1649472332-arch/Kolbe_Codex_handoff/README.md

# 当前使用入口

当前有效交付是 `CAD_v2/` 的 FreeCAD B1。先阅读 `README_START_HERE.md`，双击 `打开模块检查.cmd` 进入三维模块检查。下方为历史 OpenSCAD 原型，其尺寸与生成流程不适用于当前 FreeCAD 版本。

# 可堆叠无隔膜 Kolbe 电解槽：工程原型说明（历史资料）

本仓库描述一套可拆卸、可重复堆叠的板框式单极电解槽概念，供 OpenSCAD 几何检查和工程评审使用。它不是制造放行文件，也没有经过承压、密封、电气或化学验证。渲染成功不代表可安全运行。

## 设计摘要

- XY 为板面，Z 为堆叠方向。相邻电极形成独立开放流道；不设膜或隔膜。
- 电极按 `C-A-C`、`C-A-C-A-C`、`C-A-C-A-C-A-C` 排列。所有 A 并接、所有 C 并接，属于单极并联，不是双极串联。内部电极两面面向流道；两侧外阴极只有朝内的主要工作面。
- 基准几何：120 mm 方形框、R4 外角；50 mm 方形工作窗、R3 圆角；80 mm 方形电极、0.35 mm 厚。电极耳延至 x=±80 mm、宽 10 mm、位于 y=0：A 向 +x，C 向 −x。
- 每个流道框厚度与名义流道间隙相等，默认 4 mm；范围示例 2/4/6 mm。硬止挡由框体平整端面提供。
- 框两侧各有闭合圆角方形密封槽，中心线边长 60 mm、圆角 R6；密封圈线径 `cs=gap/4`，槽宽 `1.4cs`、深 `0.75cs`。自由密封圈截面为圆形；模型中的压扁/椭圆形只为表现压缩后的变形，不是可直接制造的自由态截面。
- 八个 M6 拉杆孔位于 x=±50 mm、y=±45/±15 mm；框、绝缘板和端板孔径均为 7 mm，配 12 mm 垫圈。端部各有 4 mm 绝缘支撑板和 10 mm 刚性端板。
- 接液框暂以 PEEK 为材料占位；阳极暂以铂或双面镀铂钛建模，阴极材料待定。材料牌号、表面处理和所有接液件仍需依据真实电解液与温度选定。

## 堆叠尺寸与物料数量

| 电极数 n | 流道数 n−1 | 名义总高 |
| ---: | ---: | ---: |
| 3 | 2 | 37.05 mm |
| 5 | 4 | 45.75 mm |
| 7 | 6 | 54.45 mm |

总高公式：`H = n·0.35 + (n−1)·gap + 2·(10+4) mm`。以上取默认 `gap=4 mm`，未含接头、外部母线、垫圈突起或压紧变形。

初版 BOM 计数：`n` 片电极；`n−1` 个流道框；`2(n−1)` 个密封圈；2 个绝缘支撑板、2 个端板；8 根 M6 拉杆、16 个垫圈和 16 个螺母；每框 2 个微管/连接短管，共 `2(n−1)` 个。外部歧管、远端接头、堵头、仪表、线缆及安装件需另行设计选型。

## 装配顺序（概念）

1. 检查框槽、端面、工作窗和孔道无毛刺、污物或可见损伤；确认每个框两条密封闭环连续。
2. 将合适的自由态密封圈分别放入每框两面的槽内。不可拉伸过度或扭曲；确认接液材料已通过相容性确认。
3. 从一端端板和绝缘板开始，按 `C-A-C...` 顺序交替堆叠电极与流道框，确保每个流道两侧电极表面平整贴合框体止挡，电极耳朝向和绝缘间隙符合装配图。
4. 加另一端绝缘板和端板，装入对称拉杆、垫圈和螺母。按经计算确定的顺序与预紧方案均匀加载；本说明不提供扭矩值或压紧力。
5. 逐个通道连接外部分配/回流管路，低风险介质下先确认通断和排气路径；连接干侧母线时确认极性、绝缘与短路防护。电极没有已定型的横向定位特征，需另设计装配定位夹具/治具（TBD）。

模型给出的硬止挡目标是框体端面抵住电极平面，不应靠无限增加螺母扭矩挤压软密封。实际装配工艺、紧固件预紧和压紧均匀性必须单独制定。

## 历史参考的取舍

旧 v37 仅作尺寸、外壳、加工和历史问题参考：外形尺度、孔位和加工空间等经验可用于比较与复核；旧参数中的约 104.7 mm 外形、68/86 mm 腔体尺度和 8/9/10 孔版本不直接决定新模型尺寸。双半框、隔膜、M12 插电极孔、垂直交叉电极及旧的接液铜连接思路均不属于本方案，不能据此推断新结构已解决密封或电化学性能问题。

## 修改与生成视图

主模型和视图开关见 `kolbe_stack.scad`。按项目提供的渲染脚本批量生成 3/5/7 片、爆炸图和流道剖视：

```powershell
python scripts/render_variants.py
```

如脚本或 OpenSCAD CLI 尚未安装，需先在本机配置 OpenSCAD 并按脚本提示运行。模型支持输出几何视图、STL/DXF 等脚本明确列出的格式；不承诺提供原生 STEP，也不应把网格输出当作已完成的加工图纸。每个加工件的材料、尺寸、公差和表面要求仍需工程图定义。

修改电极数时只使用奇数 3、5、7；修改间隙时同步复核密封圈线径、双槽之间的框体剩余腹板、进出液孔壁厚、软管接口和堆叠高度。不要只改单个参数就假定其余结构仍有足够壁厚或可装配。

## 必须确认的工程输入与限制

- 设计压力、正常工作压差、堵塞/泵故障压力、泄压设定、压力循环范围均为 **TBD**。当前没有压力额定值，也没有任何压力试验结果。
- 电解液组成、浓度、羧酸盐/产物、溶剂、清洗液、实际温度、流量、产气量与泵曲线尚未提供。60–85 °C 是待兼容性评估的温度范围，不是已验证工况。
- 需确认密封圈截面与材料、槽公差、压缩率、热膨胀、溶胀及压缩永久变形。默认 `cs=1 mm`（4 mm 间隙）；2 mm 间隙时 `cs=0.5 mm`，需供应商确认可采购性和装配能力。
- 需确认流体接头、微管、软管与外部并联歧管。当前框内埋入式横向孔直径为 `gap/4`，短管外径为 `port_d+0.4 mm`；相邻流道框同侧管口的 Z 中心距为 `gap+0.35 mm`，同一框相对两侧管口的 Y 向距离为 120 mm。每个框面无法假定可直接安装常规接头。微管与框体之间的密封和保持/防脱设计尚未完成，远端扇出连接、接头采购和压力验证仍是 TBD；未完成前不得按可用于实际带液服务的框体下单加工。
- 需确定阴极材质、阳极涂层与基材、引出耳连接方式、电流、电流密度、接触电阻、温升、母线截面和电气间隙。旧装置约 10.5 V 是槽电压记录，不是电极电位，也不能用来证明铜箔安全载流。
- 需做端板弯曲、拉杆/螺母/垫圈强度、压紧载荷分布、框体局部应力、绝缘和浮动公差计算；检查薄板在压差下的挠曲、屈曲/鼓胀及外侧阴极的背衬条件。
- 需要考虑 60–85 °C 下 PEEK 等材料的热膨胀、密封与框体蠕变、PTFE 冷流（若选用）和重复拆装后的损伤。
- 无隔膜单腔体系可能发生产物交叉、混合气体与可燃气体风险。系统必须另行设计气液分离、持续排气/安全排放、压力监测和适当防护；本模型不能解决这些系统安全问题。

OpenSCAD 几何只能帮助检查构型与尺寸关系，不能证明承压、均匀预紧、长期耐腐蚀、电气安全或“保证不漏液”。在材料测试、结构计算和经批准的压力/循环试验完成前，不可把本原型作为额定设备投入运行。
