1649472332-arch/Kolbe_Codex_handoff/CAD_v2/docs/design_review.md

# Kolbe 紧凑电堆设计审查

## 设计状态

当前冻结候选为 56 mm × 56 mm 双面电极片、0.35 mm PEEK 绝缘载片和 KF-101 内部分流框。框体在 CAD 中标注为 **PVDF provisional**；PEEK 仅用于载片/绝缘件，框体的最终材料尚未选定。6 mm 是机械审查用的暂定框厚，实际电极间隙仍待实测电极与流量需求确定。

这份审查覆盖 FreeCAD BRep 几何和尺寸关系。几何有效不代表耐压、流动、化学兼容或量产工艺已验证。

## 有效面积与密封边界

- 湿腔为 50 mm × 50 mm、R3 圆角，无加宽分配槽；流体由 ±Y 内部歧管经埋入式支路直接进入湿腔。
- 湿腔面积为 2,492.27 mm²。电极片为 56 mm × 56 mm、R2 圆角，去掉引出片后的面积为 3,132.57 mm²；湿腔/电极面积比为 79.56%。
- 主密封槽中心线尺寸 53.6 mm、R4.8，宽 1.4 mm、深 0.75 mm；密封槽外包络尺寸 55.0 mm。相对 56 mm 金属片，每边仅有 0.50 mm 外侧余量；密封槽内缘到 50 mm 湿腔边缘的平面余量为 1.10 mm。供应商公差及装配偏差可能显著影响这两个窄边界。
- 主 O 形圈暂按 1.0 mm 截面估算：名义压缩率 25.0%，矩形槽截面填充率约 74.8%。歧管槽使用独立参数：均径 14 mm、宽 2.2 mm、深 1.1 mm，暂按 1.5 mm 截面估算，压缩率 26.7%，填充率约 73.0%。密封材料、硬度、温度和介质适配尚未指定。

## 歧管、支路与装配

两个 Ø8 轴向歧管位于 (0, ±62)，金属电极片没有歧管孔。歧管密封落在载片/支撑件的绝缘平面上；主密封圈则压在金属电极片上。KF-101 的 Ø2.2 横向埋入支路在 z=3 mm 处从歧管通到湿腔。BRep 探针检查确认支路、湿腔和歧管交汇处无实体阻挡，主密封环和四个歧管密封环的抽样点均处于槽内。

重复 n 片电极的名义层叠关系为：n 个 PEEK 载片、n 个电极片、n−1 个 KF-101 框、2(n−1) 个主密封、4n 个歧管密封；端部为前端板 KP-201、前适配件 KP-202、后闭合件 KP-203、后端板 KP-204 各 1 件。每个框另有 2 个 M4 交叉钻孔堵头和配套垫片。KF-101 的外侧交叉钻孔是制造通道，堵头不是外部流体接口。

| 电极片数 n | 载片 | 电极片 | KF-101 框 | 主密封 | 歧管密封 | M4 堵头/垫片 |
| ---: | ---: | ---: | ---: | ---: | ---: | ---: |
| 3 | 3 | 3 | 2 | 4 | 12 | 4 组 |
| 5 | 5 | 5 | 4 | 8 | 20 | 8 组 |
| 7 | 7 | 7 | 6 | 12 | 28 | 12 组 |

堵头 KH-901 在 CAD 中为 M4×0.7、Ø3.3 光滑螺纹包络、6 mm 长，带 Ø5.5 × 2 mm 一字槽头；KH-902 垫片建模为 Ø5.5/Ø4.2、厚 0.5 mm。螺纹不是螺旋实体，堵头/垫片接触、公差、紧固扭矩和密封方式都需工程确认。

## 尚待验证

1. 实测电极、载片、框体厚度及平面度公差，并复核 0.50 mm 外侧密封余量和 1.10 mm 内侧余量。
2. 确定 KF-101 最终材料、密封材料、实际电解液和温度范围；完成相容性试验。
3. 对共用液体歧管评估离子旁路/分流电流。PEEK 载片隔离了金属歧管孔，但不能据此认定已消除所有液相分流。
4. 通过流量测量或 CFD 评估支路压降、分配均匀性、滞流区和排气/排液；目前没有 CFD 结论。
5. 完成交叉孔加工可达性、堵头装配与密封试验，以及工作压力、泄漏和耐久验证。

现有 FreeCAD 几何审计通过，只说明当前 BRep 有效、连通孔道没有被实体堵住；**尚未达到制造放行或压力等级认证状态**。
