1649472332-arch/Kolbe_Codex_handoff/CODEX_TASK.md

# Codex 开发任务：可堆叠、无隔膜、双面反应 Kolbe 电解槽（OpenSCAD）

## 任务目标

基于 reference/ 下的旧 v37 OpenSCAD 作为**尺寸、外壳、加工和历史问题参考**，重新设计一个类似碱性电解水电堆的**模块化板框压滤式（filter-press）Kolbe 电解槽**。不要直接在旧双半框、隔膜和垂直交叉电极结构上简单增加孔。提交可运行的参数化 SCAD 机械结构、分件视图、装配视图、爆炸图、装配说明、密封/供液/导电说明及可执行检查。

老师的硬性要求：**不是一体式池体，必须能拆卸、堆叠、扩容，并使内部电极的两个表面都能够参与反应。** 用户当前体系：**无隔膜**、单腔思路、外部储液瓶、循环泵。约 10.5 V 为旧装置部分实验槽电压，不等于电极电位，也不能据此确定铜箔安全载流能力。曾出现泵开启、压差增加后渗漏；设计优先级为密封可靠性和可维护性，不是单纯外观。

## 必须实现的电极结构与电连接

- 采用平行平板**单极式（monopolar）、同极并联**阵列，不做双极板串联。优先支持 `C-A-C`（3片）、`C-A-C-A-C`（5片）、`C-A-C-A-C-A-C`（7片），参数切换且自动重复相同类型零件。
- C=阴极、A=阳极；每两片相邻电极之间设置一个独立的开放流道，**无膜、无隔膜**。两侧外阴极只有朝向流道的主要工作面，内部电极两面参与反应；不能夸大成“所有电极两面都充分利用”。
- 双面阳极反应表面设为连续、平整的铂或双面镀铂钛模型（实际电极材料由实验确定），不允许背后用实体集流板挡住反应面。
- 每块电极的**平面引出耳/导电耳**在周向密封区外伸出；电极平板本体被两侧密封圈压住。设计时确保引出耳的几何特征**不破坏密封压合面**。电极引出耳、外部铜线/铜排、拉杆、端板彼此要有电气绝缘与机械避让。
- **铜箔/铜排只位于干燥的外部区域**，不能接触阳极电解液。导电接头强度、接触电阻、电流和温升需要单独校核，不把 10.5 V 直接当成铜箔耐压阈值。

## 必须实现的机械与密封结构

1. 重复单元：`流道框 + 两侧密封件 + 电极板`；两端安装绝缘支撑板与刚性压板，外围用对称拉杆/螺栓压紧。各件需便于单独拆出、更换、扩展。
2. 每个流道框内有贯通工作窗口；其**左右两张端面**均设置闭合、连续的密封圈槽/垫片座，密封圈压在邻接电极的**平整面**上。不能出现“密封圈被入口沟槽切断”“螺栓孔位于湿侧密封区”等问题。
3. 配置明确的压缩限位面/硬止挡，避免过度挤压密封圈；密封槽几何必须全部参数化，同时文档标明设计压缩率、槽宽/深、压缩后高度、堆叠尺寸链和公差分析。默认值仅作方案占位，需供应商标准进一步核查，不得称为已认证/保证不漏液。
4. 端板、外框、拉杆需有可供工程人员进行抗弯/预紧计算的尺寸和建议校核路径；OpenSCAD 不能直接证明压紧均匀。螺杆分布按湿区外周均匀对称布置，满足几何壁厚和绝缘避让。不要假设增加螺栓数量就一定密封更好。
5. 流道框材料先建模为 PEEK 等高刚性耐化学材质的占位；密封材料 EPDM/FKM/FFKM 等必须注明需按实际碱度、羧酸盐、产物和 60-85°C 条件做相容性验证。PTFE 的热蠕变/冷流应作为风险而非忽略。所有接液材料需留 BOM 备注，不能直接把旧原型的 3D 打印密封能力当作可靠承压能力。

## 供液与排气（第一版先用外部分配）

- 每个流道框独立入口/出口（优选底部进液、顶部出液/排气的流路），所有流道经**外部并联分配歧管**接循环泵与储液瓶。需要绘出每个流道的进出液通孔、接头安装空间及至内窗的实际贯通流路，而不是装饰性孔。
- 流道入口和出口若从侧边钻入框体，必须设计为框体**实体内部的穿孔**，不得在密封端面挖穿 O 形圈路径的明槽。端面 O 形圈需构成从湿窗向外无缺口的闭环。应显示局部剖视确认。
- 给各流道配置可拆卸堵头/转接接头概念、空间避让、排气说明；气液会有可燃混合气体风险，不得设计成无泄压出口的封闭压力腔。外部气液分离、安全排放、压力监测等需在 README 明确为系统级需求，不假装靠机械密封就解决产气危险。
- 可在后续提出“内部共用歧管”版本，但优先完成**可制造、可检查、可逐通道排障**的外部分配原型。

## 目标参数（初始方案占位，可为结构合理性调整）

| 参数 | 初始值 | 说明 |
| --- | --- | --- |
| `electrode_count` | 3 | 可取 3/5/7，奇数 |
| `active_window_mm` | 50 | 50×50 mm，暂定；不要强求沿用旧 68×68 腔体 |
| `gap_mm` | 4 | 2/4/6 mm 可选，最终由气泡/压降测试决定 |
| `electrode_thickness_mm` | 0.35 | 历史参考，不作为实际薄片强度认证 |
| `frame_material` | PEEK (概念) | 不是实际材料采购认证 |
| `gasket_cs_mm` | 可调 | O形圈线径，取供应商选型值后确定 |
| `bolt_count` | 6/8 或算法推导 | 受外形、密封环、端板刚度与应力约束，不是固定答案 |
| `operating_temperature_C` | 60-85 | 供兼容性与热膨胀校核 |
| `design_pressure_bar` | **TBD** | 用户尚未提供工作压差与极限压力；必须高亮待确认，**不要自定承压额定值** |

原版 V37 参数化参考里 `footprint_scale=2`、外形约 104.7×104.7 mm、活动腔参考尺寸可达 86×86 mm；另有 8/9/10 螺栓版本。旧工程含“双半框/膜/M12 插电极孔/交叉电极”遗留设定，**这些不是本方案的目标结构**。新板框尺寸由空间和受力需要决定，可以与旧 v37 不同。

## OpenSCAD 实施要求

- 建立统一坐标：建议 XY 为电极/流道板面，Z 为堆叠方向。每一层零件的 Z 位置由累计厚度确定，不用随意相对平移来掩盖干涉。
- 顶层提供 `part` 或 `view` 开关：`assembly`, `exploded`, `one_frame`, `gasket`, `anode`, `cathode`, `endplate`, `insulator`, `three_layer`, `five_layer`, `seven_layer`, `flow_section`, `terminal_detail` 等。
- 具有合理的颜色和透明度，能肉眼辨认阳极/阴极、流道、密封圈、端板、拉杆、外部接线耳；但输出 STL 时各零件必须是**单独可打印/可加工**的模型，颜色不作为制造特征。
- 加入 `assert()` 约束和错误提示：`electrode_count` 为奇数>=3；可用密封宽度>0；密封环不与螺杆孔/进出液孔相交；电极间净距>0；端板与接线耳有空间避让；侧向流道穿孔不得挖穿密封槽侧壁；避免开孔之间壁厚为负。
- 通过 OpenSCAD CLI 对 3/5/7 三种层数和流道间距配置执行至少预览/渲染检查。若机器没有 OpenSCAD，提供清晰的本地运行命令，不能谎称验证通过。
- 代码拆分合理，所有关键尺寸集中在参数区；维护可读注释，禁止过度 hardcode。

## 交付物

请在项目中创建以下文件，全部能在本地 OpenSCAD 中使用：

1. `kolbe_stack.scad`：参数化主模型和多种视图。
2. `README.md`：设计原则、装配顺序、参数表、修改方法、材料兼容性及仍需确认的工程参数。
3. `docs/seal_stackup.md`：密封接触路径、压缩尺寸链、公差、热膨胀与高温蠕变风险、失效模式。
4. `docs/electrical_fluid.md`：单极并联接线、电极双面利用、干侧铜连接、单独通道外部分流、产气及安全排气。
5. `docs/validation_plan.md`：逐层检查、几何干涉、密封压紧均匀性、冷态/热态水压和压差监测、循环工况、漏液判断等测试计划（压力阈值待确认）。
6. `scripts/render_variants.sh` 或跨平台 Python 脚本：OpenSCAD CLI 导出与批量渲染。
7. `renders/`：三、五、七电极装配图，至少一张爆炸图和一张流道密封剖视图（若能实际生成）。

## 验收标准

- `electrode_count=3,5,7` 可切换，几何阵列正确，每层间距与总堆叠厚度可计算。
- 中间每片电极两面面向相邻流道；没有膜；电连接为各 A 同极、各 C 同极，禁止短路。
- 每个湿区端面有完整密封闭环；出入口均连通工作窗口且未从端面截断密封圈；螺栓孔干区避让。
- 有真正的可拆分组件和清楚的 BOM，不只是一个看起来像电堆的单一实体。
- 电极引出耳全在干侧，外部铜件不直接接触液体；不存在明显电极/螺栓/压板干涉。
- 每个流道均可分配液体并排出气液，未出现死端封闭腔。
- 文档明确说明：OpenSCAD 模型无法证明承压、长期耐腐蚀或“保证不漏液”；需通过材料测试、端板受力和压力试验后再加工运行。

## 执行顺序

1. 阅读全部 reference/ SCAD，先简述旧设计真正可复用的几何、现存缺陷和需要推翻的部分。
2. 先构建密封流道框（含闭合周向密封槽、侧向实体内进出液孔）；出 `flow_section` 和 `one_frame`。
3. 再做双面电极薄板、引出耳与绝缘框架，接着完成 3/5/7 片装配。
4. 最后添加端板/拉杆/限位、导电母线示意、批量渲染、尺寸/安全/验证文档。
5. 完成后列出工程未定项，不许用模型可渲染代替密封性和耐压验证。
