1649472332-arch/Kolbe_Codex_handoff/docs/electrical_fluid.md

# 电连接、流道与排气

## 电极排列与电连接

阵列使用平行平板单极并联：3 片 `C-A-C`，5 片 `C-A-C-A-C`，7 片 `C-A-C-A-C-A-C`。每对相邻电极之间各有一个无膜、无隔膜的独立开放流道。所有 A 电极并到阳极母线，所有 C 电极并到阴极母线；不得把相邻板串成双极电池。每个通道的电压/电流分布仍需实测和设计校核。

内部 A 电极的两面分别朝向相邻流道，是双面阳极反应面；中间 C 电极的两面亦分别朝向流道。两侧最外层 C 电极只有朝内的主要工作面，不能表述为所有电极均双面充分利用。阳极建模为平整、连续的铂或双面镀铂钛概念件，背面不能加实体集流板遮挡其反应面。实际阳极基材/涂层、阴极材质、厚度、表面处理均待实验确定。

电极耳在周向密封区域外伸出：阳极耳向 x=+80 mm，阴极耳向 x=−80 mm，耳宽 10 mm、位于 y=0；外部干侧母线位置为 x=±82 mm。耳的根部及引出路径需保持框体密封压合面完整，并与端板、拉杆、垫圈和异极耳保持机械间隙与电气绝缘。每个重复层的极性耳可分别汇接同极母线；接头细节、紧固件和应力释放尚待设计。当前没有已定型的电极横向定位特征，堆叠装配需另设计定位夹具/治具（TBD）。

铜箔/铜排只用于外部干燥区域，不可浸入阳极电解液或接触湿润表面。引出耳—铜连接的接触电阻、载流能力、温升、机械强度、腐蚀隔离和绝缘距离需按电流及工况计算、测量。历史约 10.5 V 是旧装置槽电压数据，不是电极电位，也不构成铜箔载流能力的证明。

## 流体路径与接头边界

每个流道框有独立入口与出口，建议入口接框体下部、出口接上部，使流体冲洗工作窗并便于气体向上排出。所有通道由外部并联供液歧管接循环泵与储液瓶；每条支路应能单独隔离、取样、排气和排障，并评估并联支路的流量均匀性。端口必须经真实贯通孔道与活动窗相通，不得仅作外观孔。

本几何占位是横向埋入框体的孔，孔径 `port_d=gap/4`，Z 位于间隙中面。短管外径为 `port_d+0.4 mm`；相邻流道框同侧管口的 Z 中心距为 `gap+0.35 mm`。同一框的入口和出口位于相对两侧，Y 向相距 120 mm。默认 g=4 mm 时，孔径约 1 mm、短管外径约 1.4 mm、相邻框同侧管口 Z 中心距 4.35 mm；g=2 mm 时，孔径约 0.5 mm、短管外径约 0.9 mm、相邻框同侧管口 Z 中心距 2.35 mm。该几何不能假定可在每个框面直接安装常规接头。微管与框体之间的密封和保持/防脱设计尚未完成，远端扇出方案、固定方式和可采购性均为 **TBD**；完成设计并通过压力验证前，不应下单加工用于实际带液服务的流道框。

每个框的两面密封槽与工作窗之间保持闭合密封路径。横向钻孔必须位于框体实体内部，避免从端面开槽穿过 O 形圈路径。通孔、槽底和相邻面的薄隔壁需检查截面、加工偏差和强度；默认估算隔壁仅 `0.1875·gap`，g=4 mm 时 0.75 mm。除非已在模型剖视和实物验证，否则不能认为该薄壁可承压。

在接入循环泵前，外部分配管路应有明确的供液、回液、隔离、排气与泄压安排。每通道需能排尽气袋并确认回流；泵死端、堵塞、软管折弯和支路不平衡都可能提高压差。具体泵、流量、压差和接头额定值尚未确定。

## 产气与系统安全

无隔膜单腔运行时，反应产物与气体可能互相接触或混合，并可能形成可燃气体混合物。不得将有产气的流道设计或操作成没有安全排气/泄压路径的封闭压力腔。储液瓶、回液、气液分离器、连续排气、安全排放、压力监测/联锁和适当的通风/防护需要作为系统级设计；本模型和机械密封不能替代这些措施，也不能据此确认反应化学安全。

电解液种类、浓度、产物、溶剂、实际温度（目标范围 60–85 °C）、电流、气体生成速率和危险评估均待确认。所有接液材料、软管及密封件必须针对完整体系和清洗介质做相容性与寿命验证。
