1649472332-arch/Kolbe_Codex_handoff/docs/seal_stackup.md

# 密封路径与堆叠尺寸链

## 结构与接触路径

一个流道重复单元由流道框、框两侧各一只自由态圆截面密封圈，以及邻接的平整电极面组成。框体工作窗为 50×50 mm、R3；框外形为 120×120 mm、R4。密封圈中心线为边长 60 mm、R6 的闭合圆角方形。两个端面上的槽各自连续闭合，围住湿窗；流体口从框体内部横向钻入，不在密封端面开明槽。八个拉杆孔处于密封湿区之外。

接触路径是湿窗 → 密封圈内侧接液边 → 连续密封接触面 → 干侧框体/端面。检查每个面全周闭环、槽角、孔道与槽之间的实体隔壁，以及螺杆孔到槽的最小实体宽度。模型几何不能证明表面粗糙度、平面度、材料渗透率或实际接触压力。

## 名义压缩与止挡

符号：`g=gap_mm`，自由圈截面直径 `cs=g/4`；槽宽 `w=1.4cs`；单面槽深 `d=0.75cs`。框体厚度设为 `g`。框面硬止挡贴到电极平面时，压缩后的名义密封高度等于槽深 `d`，因此：

```text
压缩量 = cs − d = 0.25cs
名义压缩率 = (cs − d) / cs = 25%
```

此处是概念占位。自由圆截面密封圈的名义槽填充率为：

```text
fill = (π·cs²/4) / (1.4cs·0.75cs) = 74.8%
```

模型将压缩后的密封圈示意为宽约 `1.333cs`、高 `0.75cs` 的椭圆；这只是变形可视化，不代表可直接制造或采购的截面。未压缩的圈应按圆截面供应件处理。实际允许压缩率与槽填充率必须根据供应商对材料、截面、温度、介质、表面和静/动态密封工况的建议确认。

| 间隙 g | 自由截面 cs | 槽宽 w | 槽深 d | 双槽后残余腹板 `g−2d` | 名义框厚 |
| ---: | ---: | ---: | ---: | ---: | ---: |
| 2 mm | 0.5 mm | 0.7 mm | 0.375 mm | 1.25 mm | 2 mm |
| 4 mm | 1.0 mm | 1.4 mm | 0.75 mm | 2.50 mm | 4 mm |
| 6 mm | 1.5 mm | 2.1 mm | 1.125 mm | 3.75 mm | 6 mm |

### 端口壁厚的几何占位

横向埋入孔直径 `port_d=g/4`，位于框体 Z 中面。以孔道到任一密封槽底之间最短实体距离估算的名义隔壁：

```text
ligament = g/2 − 0.75cs − port_d/2
         = g/2 − 0.1875g − 0.125g
         = 0.1875g
```

即 g=4 mm 时仅 0.75 mm；g=2 mm 时为 0.375 mm。该薄隔壁是明显的强度、加工和泄漏敏感点，需检查真实孔道走向、槽宽、钻孔偏差、材料与工艺，并以截面/压力验证决定是否改版。代数结果不是最小制造壁厚的推荐值。

## 堆叠高度与公差

端板厚 10 mm、绝缘板厚 4 mm，各一对；每片电极厚 0.35 mm；每个流道框名义厚 `g`。总高度链为：

```text
H = 2·10 + 2·4 + n·0.35 + (n−1)·g
```

以 g=4 mm：n=3 时 37.05 mm，n=5 时 45.75 mm，n=7 时 54.45 mm。实际装配高度还受框厚公差、板厚、密封圈压缩、端板挠曲、垫圈/螺母和接头布置影响。压缩圈位于槽中，不可将自由圈高度额外累加到框厚链上。

公差链至少应纳入端板厚度与平面度、绝缘板厚度、电极厚度/翘曲、框体厚度/平行度、槽深、槽宽、圈截面公差及热态尺寸。螺杆有效长度和夹紧余量应由最终公差叠加与预紧设计确定。

**仅作算例的尺寸公差敏感性**：若自由截面与槽深分别为名义值 ±0.03 mm（不是已选工艺能力），g=4 mm 时，最小压缩率按 `cs=0.97,d=0.78` 算为 `(0.97−0.78)/0.97=19.6%`；最大按 `cs=1.03,d=0.72` 算为 `(1.03−0.72)/1.03=30.1%`。此算例未计温度、圈截面非圆、槽宽、材料回弹或压板变形，不能作为验收公差。

## 热、材料与装配风险

- 60–85 °C 下框、端板、杆件、电极与密封的热膨胀不同，可能改变间隙、预紧力和圈压缩量。应按具体牌号和实际尺寸建立冷热尺寸链。
- 密封材料对碱、羧酸盐/产物、溶剂及清洗液的兼容性未确定。EPDM、FKM、FFKM 等须按实际配方与温度筛选并浸泡/循环验证；不能仅凭通用材料名称判断兼容。
- PEEK 作为框材占位仍需采购牌号与化学兼容性确认。PTFE 若用于密封或绝缘部件，应把热蠕变和冷流纳入预紧保持评估。
- 反复拆装、偏心压紧、污染、刮伤、圈扭曲、槽毛刺、端面不平、孔道隔壁破损，均可能造成旁路或外漏。
- 只有框体硬止挡接触、槽底/槽宽和自由圈正确，才接近模型所示压缩。不得用提高拧紧扭矩弥补公差或泄漏。

## 载荷和失效评估路径

压力对一个窗口的分离力可先按 `F_p = Δp·A_wet` 估算，其中 `A_wet` 取真实受压投影面积；整个堆叠需考虑所有流道的压差、可能的压力不平衡和闭合力路径。密封压紧力需依据供应商数据或接触分析取得。由此校核拉杆、螺母、垫圈承压、端板弯曲/挠度、框体局部应力和压紧均匀性，并确认端板挠度不会明显改变流道间隙或局部圈压缩。针对电极薄板还需评估压差造成的挠曲/屈曲及外侧阴极是否需要背衬。

尚无确定压力、材料数据、预紧力、扭矩或端板校核结果；因此**无承压额定值、无建议扭矩、无“不漏”结论**。潜在失效包括外漏、通道间串漏、圈挤出/切伤、密封压缩不足或过大、端板翘曲、紧固件松弛、热态蠕变、孔道穿透槽壁和电极变形。压力阈值须由系统危险分析和结构设计确定后，再制定验证计划。
