1649472332-arch/Kolbe_Codex_handoff/CAD_v2/docs/seal_fluid_notes.md

# KF-101 密封与流路审查记录

本记录使用当前 KF-101 FreeCAD BRep 和设计基准进行几何核对。单位均为 mm；面积比仅针对圆角电极片主体，排除引出片。

## 密封槽尺寸核算

| 位置 | O 形圈截面 | 槽宽 × 深 | 名义压缩率 | 截面填充率 |
| --- | ---: | ---: | ---: | ---: |
| 主湿腔周边 | 1.0 | 1.4 × 0.75 | 25.0% | 74.8% |
| 每个歧管口 | 1.5 | 2.2 × 1.1 | 26.7% | 73.0% |

压缩率按 `1 − 槽深 / O形圈截面` 计算；填充率按 `π(CS/2)² / (槽宽 × 槽深)` 估算。结果是矩形截面的名义几何比例，不含圆角、弹性体体积公差、热膨胀、润滑剂或压缩后材料流动影响。

主槽为中心线 53.6、R4.8 的闭合圆角方环。槽外包络为 55.0；56 mm、R2 电极片外缘每边余量 0.50。槽内包络为 52.2；相对 50 mm 湿腔每边余量 1.10。歧管槽为均径 14、宽 2.2 的环槽，与主密封槽使用独立参数。

建议后续按目标介质、温度、压力、循环寿命和供应商 O 形圈规格复核压缩与填充，并将片材/加工/装配公差纳入最坏情况叠加。可参考 [Parker O-Ring Handbook](https://www.parker.com/content/dam/Parker-com/Literature/O-Ring-Division-Literature/ORD-5700.pdf) 的密封设计原则；本文尺寸仍是当前 CAD 假设，不代表该手册认可这些具体尺寸。

## 埋入支路与剩余壁厚

KF-101 每侧以 Ø2.2 横向钻孔连接轴向 Ø8 歧管与 50 mm 湿腔；外侧加工口为 Ø3.3 M4 螺纹底孔，深 6 mm，并用堵头和垫片封闭。BRep 空腔探针覆盖从湿腔、支路、歧管交点到外侧加工口的连续路径；探针与实体交叠体积低于审计阈值。此项只验证几何连通，不验证流量或密封能力。

在支路位于框厚中面、主槽从两侧各切深 0.75、歧管槽各切深 1.1 的名义几何下：

- 支路到主槽槽底的最小覆盖厚度约为 `3 − 0.75 − 1.1 = 1.15`。
- 支路到歧管槽槽底的最小覆盖厚度约为 `3 − 1.1 − 1.1 = 0.80`。

0.80 mm 是局部薄弱壁厚，应在最终材料、加工方式和压力边界确定后做强度/耐压复核。当前没有 FEA、压力试验或流量分配结果。

## 关键限制

- 框体 CAD 材料标签为 **PVDF provisional**，并非已批准材料；PEEK 是载片/绝缘件的暂定材料标注。
- 电极间隙、实际电极厚度和流量工况仍待用户实物/需求确认；6 mm 只作机械审查包络。
- M4 堵头为光滑名义螺纹包络，没有建模螺旋牙型；当前 KH-902 垫片是 Ø5.5/Ø4.2 × 0.5，不等同于已选定的密封件。
- 公共液体歧管可能形成离子旁路；需要按电解液、电阻率、层数和电气边界评估分流电流。
- O 形圈材质、硬度、公差、压缩量、表面粗糙度、堵头防松和泄漏标准均未冻结。
