1649472332-arch/Kolbe_Codex_handoff/CAD_v2/renders/inspection_free_angle.png

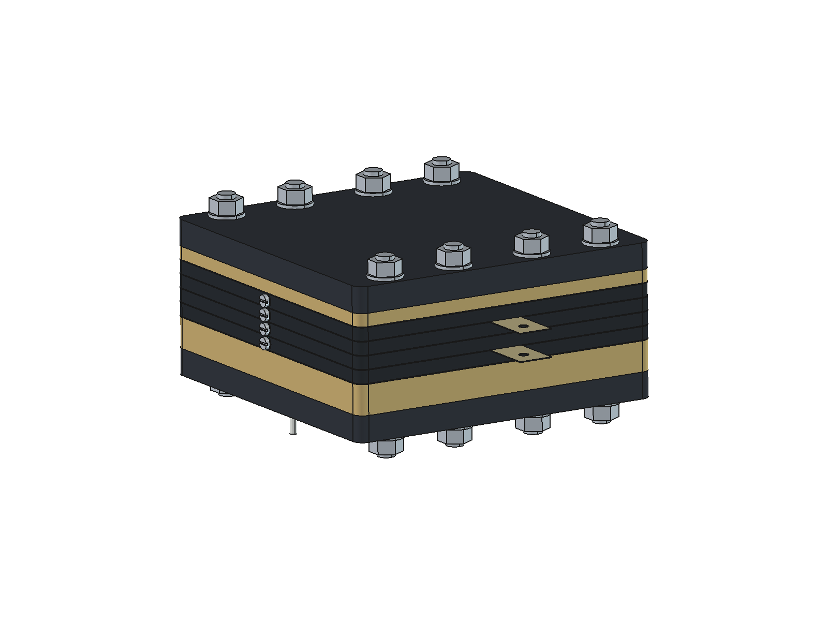
CAD_v2/renders/inspection_free_angle.png
