1649472332-arch/Kolbe_Codex_handoff/CAD_v2/renders/inspection_isolated.png

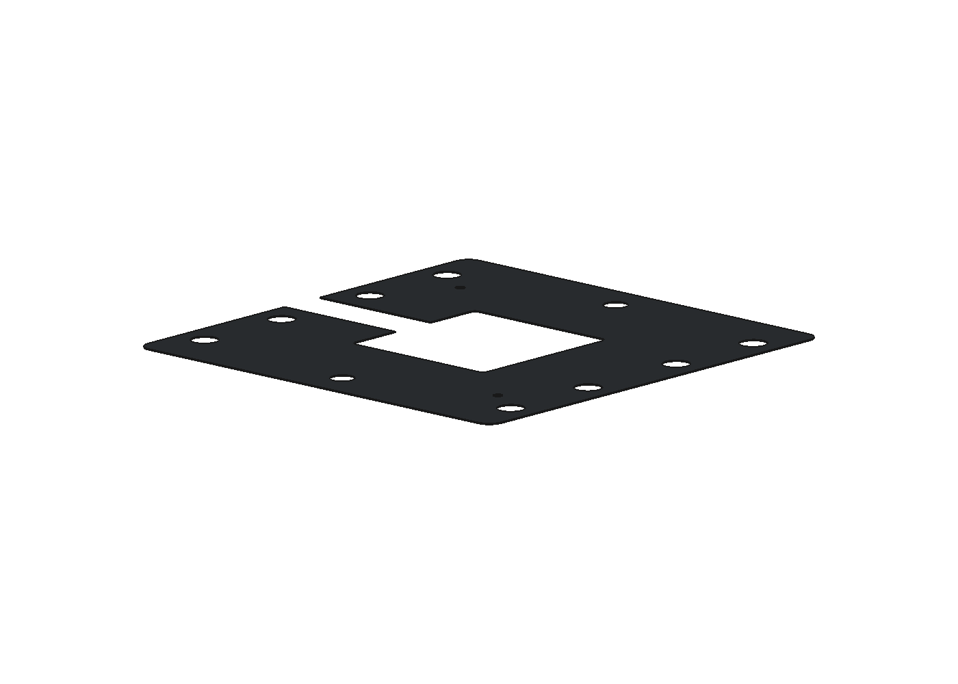
CAD_v2/renders/inspection_isolated.png
