1649472332-arch/Kolbe_Codex_handoff/CAD_v2/renders/Kolbe_3.png

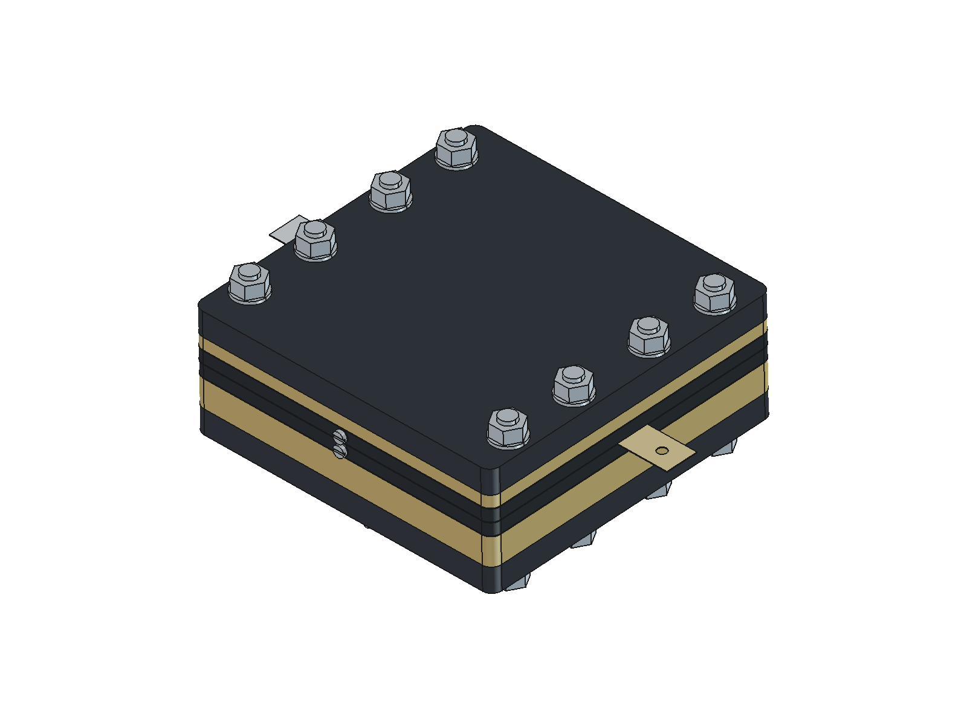
CAD_v2/renders/Kolbe_3.png
