1649472332-arch/Kolbe_Codex_handoff/CAD_v2/renders/Kolbe_5_exploded.png

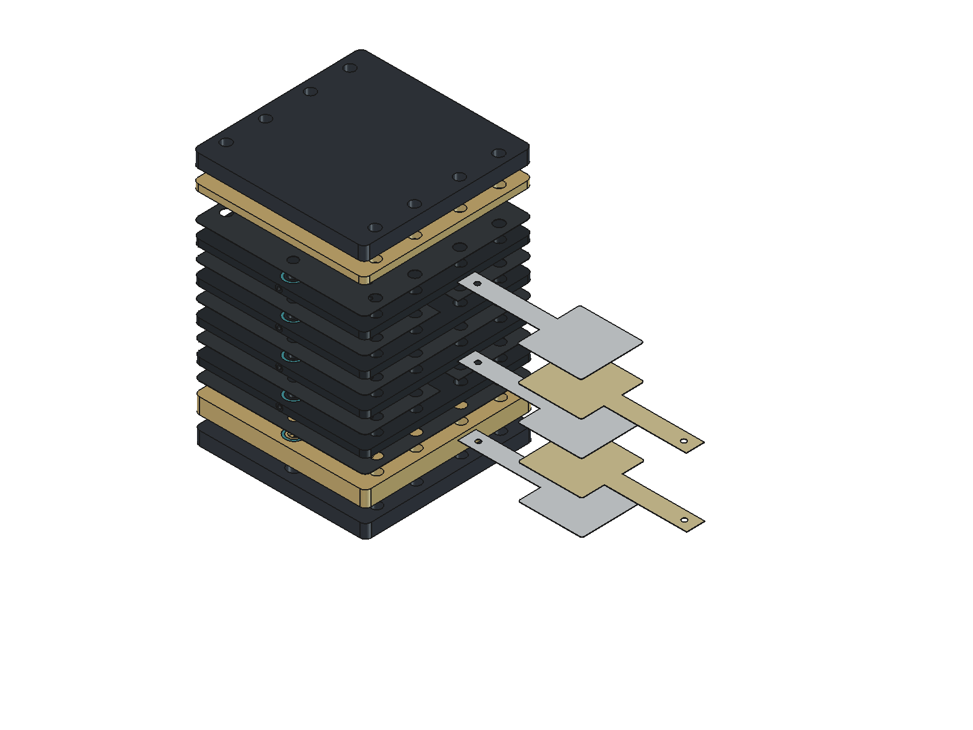
CAD_v2/renders/Kolbe_5_exploded.png
