1649472332-arch/Kolbe_Codex_handoff/CAD_v2/renders/KP-101.png

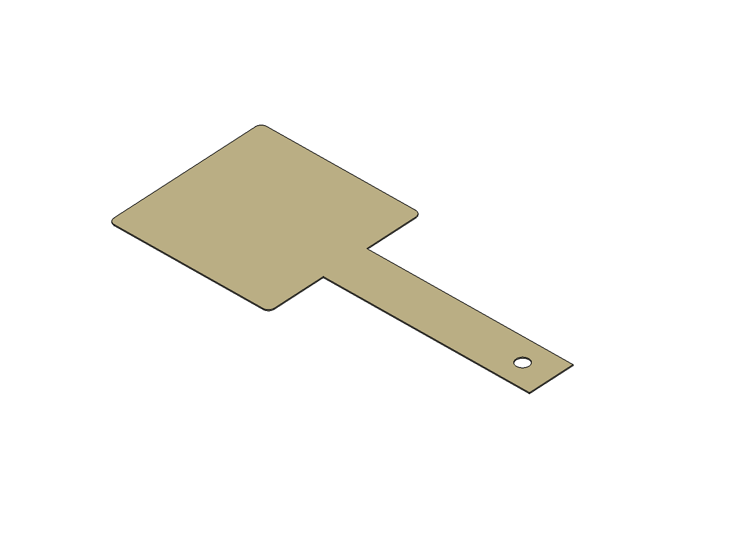
CAD_v2/renders/KP-101.png
