1649472332-arch/Kolbe_Codex_handoff/renders/exploded.png

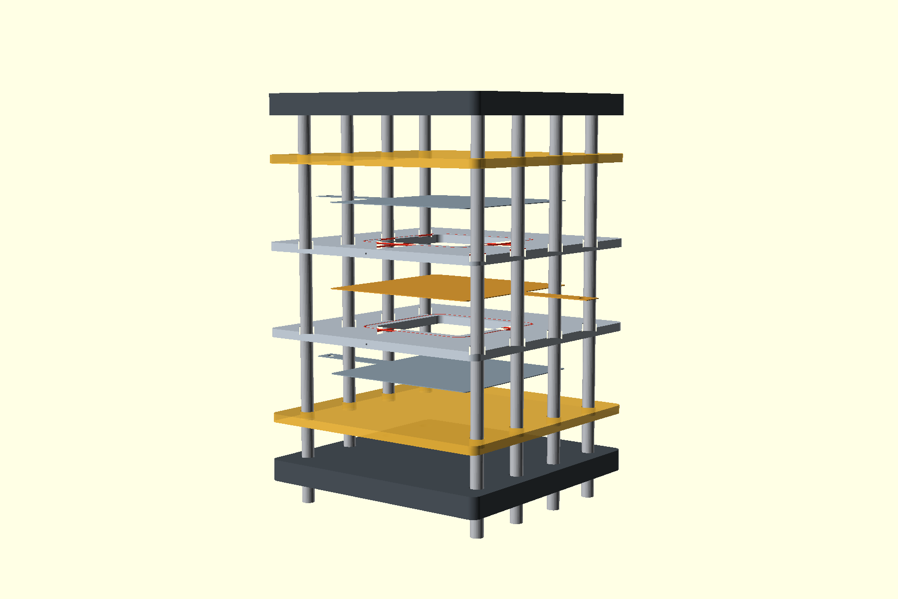
renders/exploded.png
