1649472332-arch/Kolbe_Codex_handoff/renders/flow_section.png

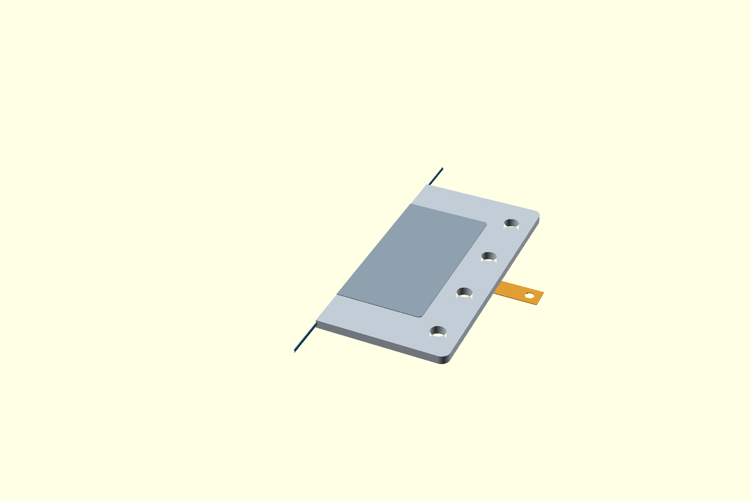
renders/flow_section.png
