1649472332-arch/Kolbe_Codex_handoff/renders/one_frame.png

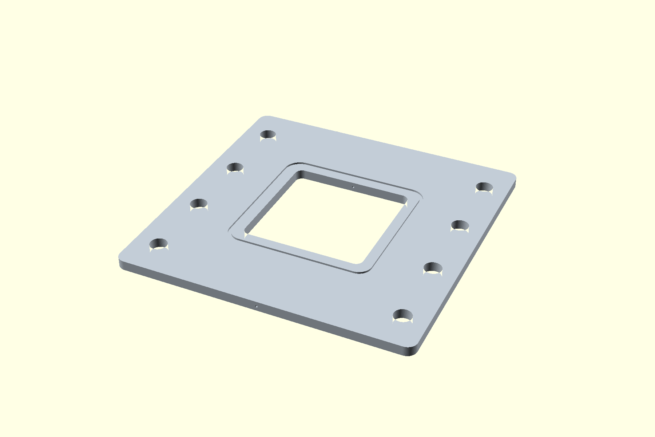
renders/one_frame.png
