1649472332-arch/Kolbe_Codex_handoff/renders/terminal_detail.png

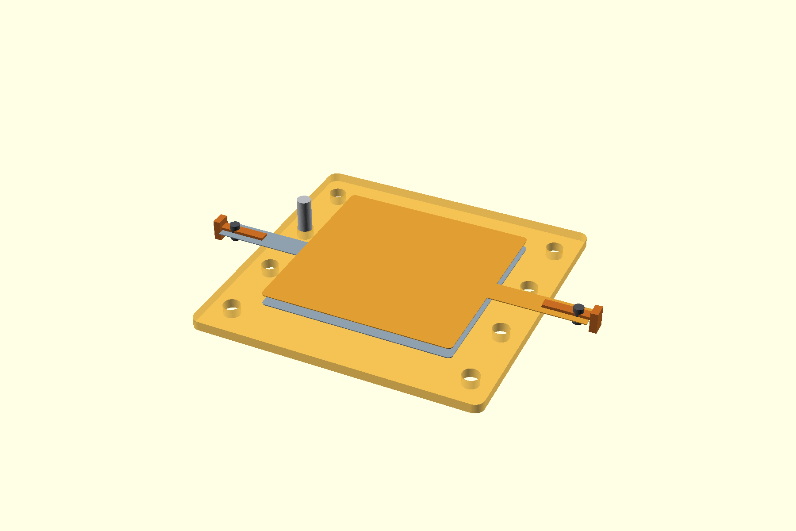
renders/terminal_detail.png
