1649472332-arch/Kolbe_Codex_handoff/CAD_v2/drawings/BOM_3.csv

Part number | Quantity | Note
KP-201 | 1 | See native component document
KP-202 | 1 | See native component document
KS-102 | 12 | Compressed seal shown in assembly
KP-602 | 2 | See native component document
KP-102 | 2 | See native component document
KF-101 | 2 | See native component document
KS-101 | 4 | Compressed seal shown in assembly
KH-901 | 4 | See native component document
KH-902 | 4 | See native component document
KP-601 | 1 | See native component document
KP-101 | 1 | See native component document
KP-203 | 1 | See native component document
KP-204 | 1 | See native component document
STD-M8-ROD-3-PLATE | 8 | See native component document
STD-M8-WASHER | 16 | See native component document
STD-M8-NUT | 16 | See native component document
STD-LOCATOR-3 | 2 | See native component document
KP-501 | 2 | See native component document
KP-502 | 2 | See native component document
KP-503 | 2 | See native component document
