1649472332-arch/Kolbe_Codex_handoff/CAD_v2/assemblies/Kolbe_5_exploded.step

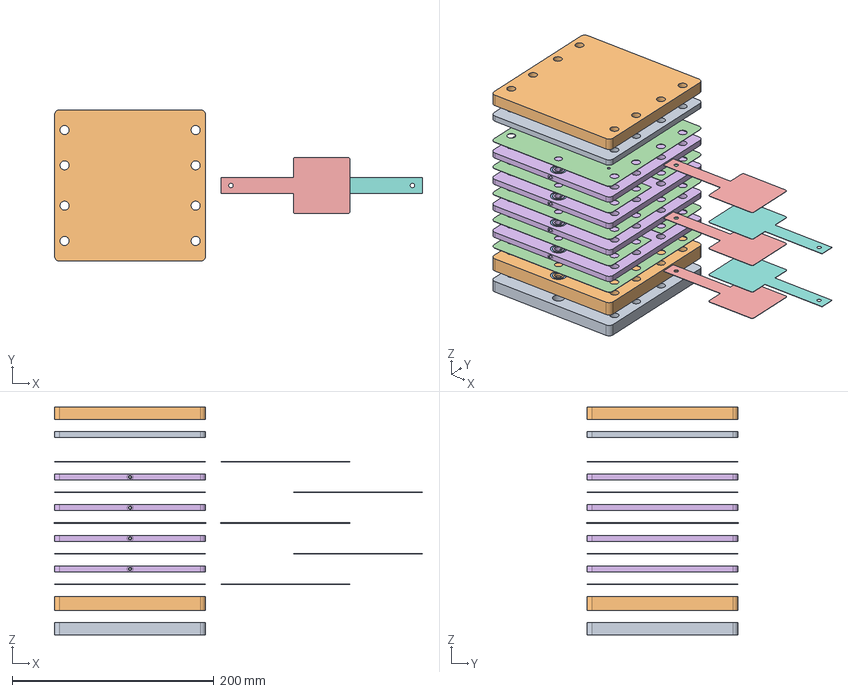
[picture p25: CAD file, 2026-11-03]
CAD_v2/assemblies/Kolbe_5_exploded.step
365.0 x 150.0 x 225.8 mm
KP-201｜前端压板
KP-202｜前端绝缘流道板
KS-102｜歧管端面密封圈 x 20
KP-602｜阴极精密绝缘载膜 x 3
KP-102｜阴极电极片 x 3
KF-101｜内部并联流道框 x 4
KS-101｜主流道周边密封圈 x 8
KP-601｜阳极精密绝缘载膜 x 2
KP-101｜阳极电极片 x 2
KP-203｜后端绝缘封流板
KP-204｜后端压板
