1649472332-arch/Kolbe_Codex_handoff/CAD_v2/drawings/KP-601_drawing.FCStd

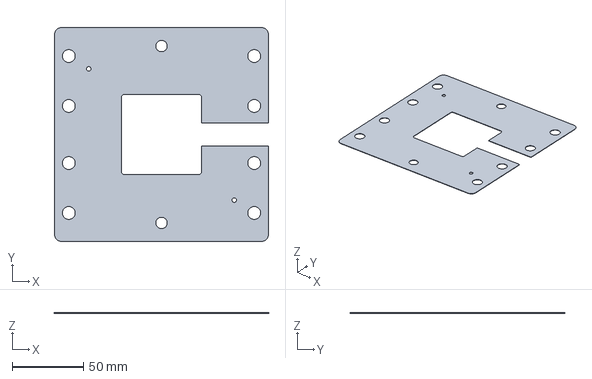
[picture p26: CAD file, 2026-11-03]
CAD_v2/drawings/KP-601_drawing.FCStd
150.0 x 150.0 x 0.35 mm
