1649472332-arch/Kolbe_Codex_handoff/CAD_v2/modules/Kolbe_5层电极组件第1号.step

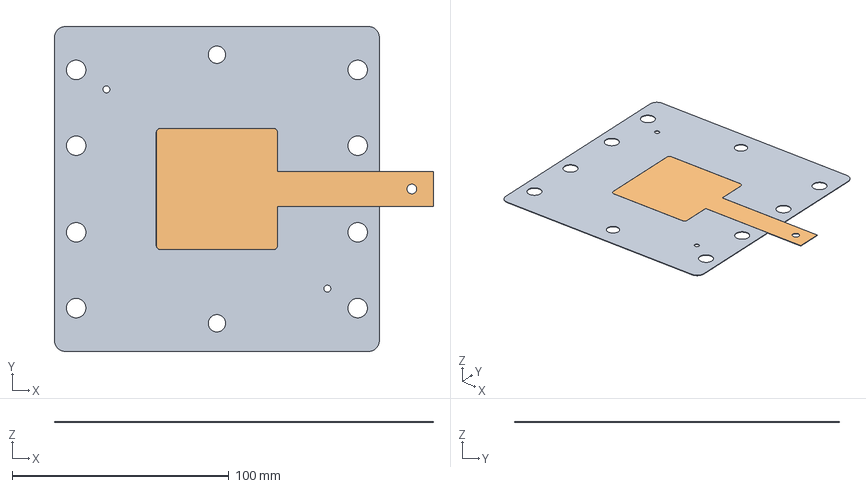
[picture p27: CAD file, 2026-11-03]
CAD_v2/modules/Kolbe_5层电极组件第1号.step
175.0 x 150.0 x 0.35 mm
