1649472332-arch/Kolbe_Codex_handoff/CAD_v2/validation/import_test.step

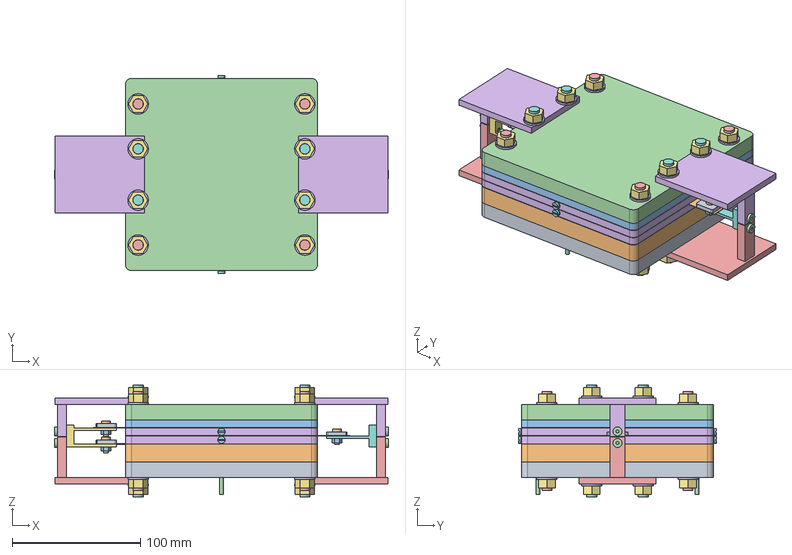
[picture p28: CAD file, 2026-11-03]
CAD_v2/validation/import_test.step
260.4 x 154.6 x 87.2 mm
KP-201 | KP-201 | Front dry endplate with manifold tool access
KP-202 | KP-202 | Front manifold insulator
KS-102-COMP x 12
KP-602 | KP-602 | Cathode precision-film carrier x 2
KP-102 | KP-102 | Cathode electrode x 2
KF-101 | KF-101 | Internal-manifold flow frame KF-101 x 2
KS-101-COMP x 4
KH-901 | KH-901 | M4x0.7 nominal cross-drill plug x 4
KH-902 | KH-902 | Cross-drill plug washer x 4
KP-601 | KP-601 | Anode precision-film carrier
KP-101 | KP-101 | Anode electrode
KP-203 | KP-203 | Rear manifold insulator
KP-204 | KP-204 | Rear dry endplate
KB-801 | KB-801 | Front PEEK comb support bracket x 2
KB-802 | KB-802 | Rear PEEK comb support bracket x 2
KB-C3 | KB-C3 | Cathode negative-X copper comb busbar, 3 layers
KB-A3 | KB-A3 | Anode positive-X copper comb busbar, 3 layers
KP-301 | KP-301 | Electrode tab clamp jaw x 3
STD-M4-S10 | STD-M4-S10 | STD-M4-S10 x 3
STD-M4-NUT | STD-M4-NUT | STD-M4-NUT x 3
STD-M4-S12 | STD-M4-S12 | STD-M4-S12 x 4
STD-M8-ROD-3-PLATE | STD-M8-ROD-3-PLATE | STD-M8-ROD-3-PLATE x 4
STD-M8-WASHER | STD-M8-WASHER | STD-M8-WASHER x 16
STD-M8-NUT | STD-M8-NUT | STD-M8-NUT x 16
STD-M8-ROD-3-SUPPORT | STD-M8-ROD-3-SUPPORT | STD-M8-ROD-3-SUPPORT x 4
STD-LOCATOR-3 | STD-LOCATOR-3 | STD-LOCATOR-3 x 2
KP-501 | KP-501 | M6x1 bulkhead connector nut x 2
KP-502 | KP-502 | Tube compression ferrule x 2
KP-503 | KP-503 | Electrolyte tube stub x 2
