1649472332-arch/Kolbe_Codex_handoff/drawings/endplate_profile.dxf

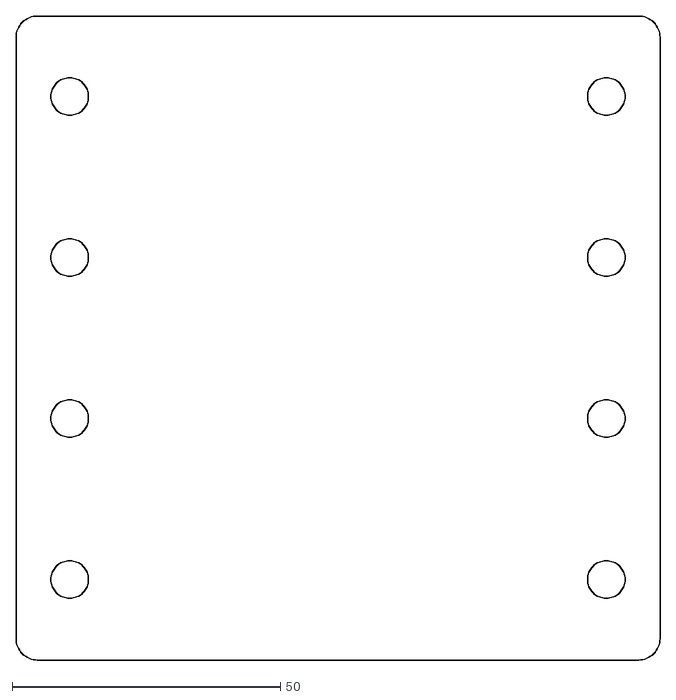
[picture p29: CAD file, 2026-11-03]
drawings/endplate_profile.dxf
120.0 x 120.0
