1649472332-arch/Kolbe_Codex_handoff/models/gasket.stl

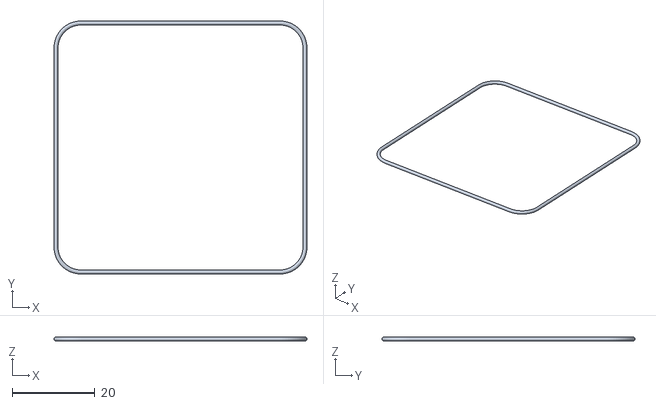
[picture p30: CAD file, 2026-11-03]
models/gasket.stl
61.0 x 61.0 x 0.981
