1649472332-arch/Kolbe_Codex_handoff/version4.3mf

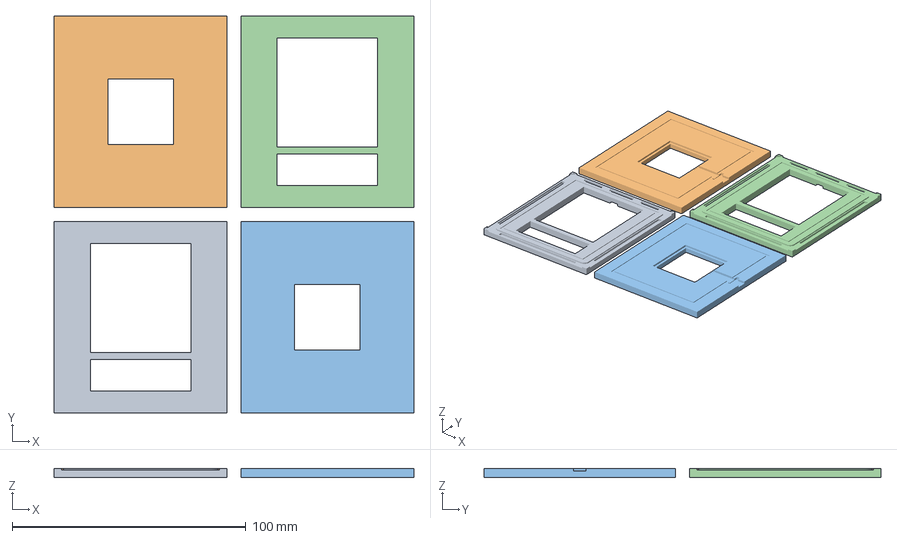
[picture p31: CAD file, 2026-11-13]
version4.3mf
154.0 x 170.0 x 4.00 mm
