1649472332-arch/Kolbe_Codex_handoff/CAD_v2/drawings/KP-201_drawing.FCStd

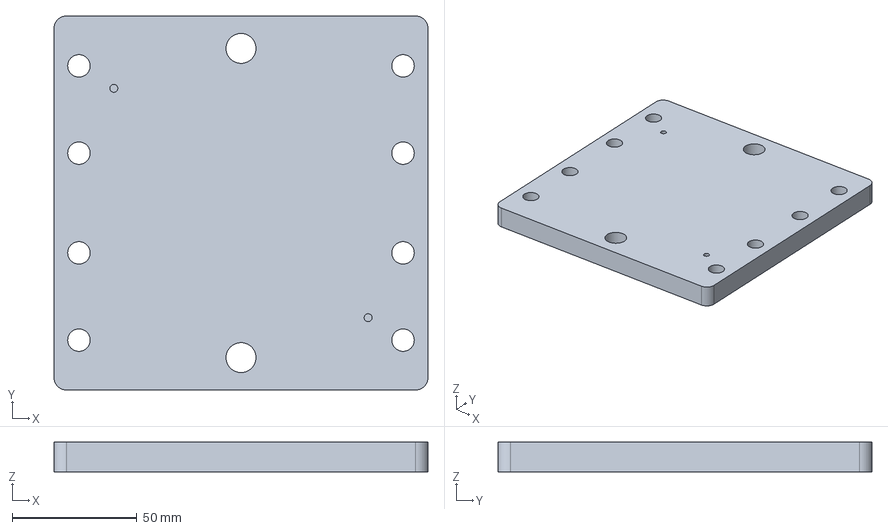
[picture p33: CAD file, 2026-11-03]
CAD_v2/drawings/KP-201_drawing.FCStd
150.0 x 150.0 x 12.0 mm
