1649472332-arch/Kolbe_Codex_handoff/drawings/frame_profile.dxf

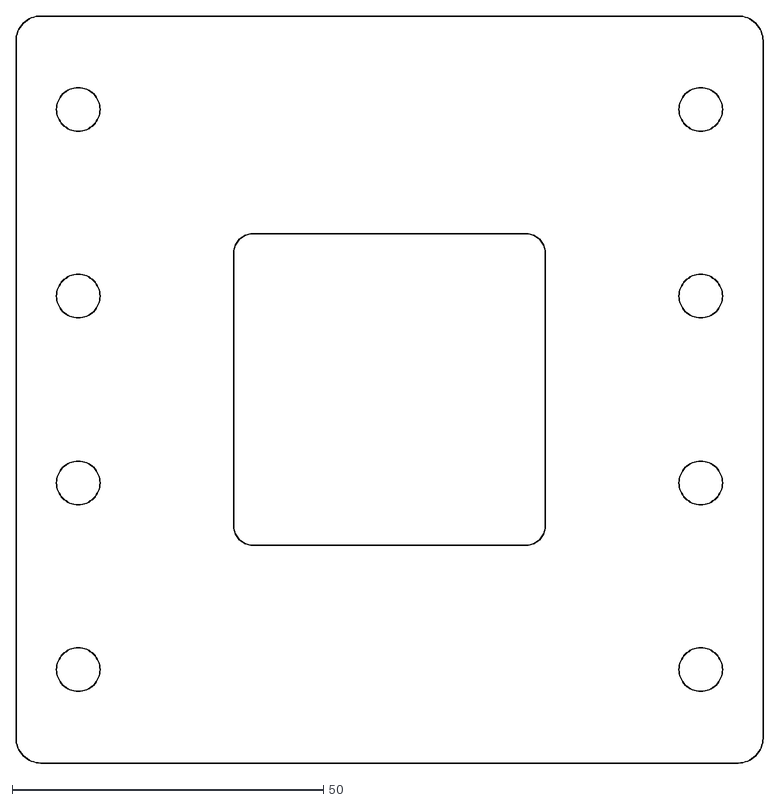
[picture p34: CAD file, 2026-11-03]
drawings/frame_profile.dxf
120.0 x 120.0
