1649472332-arch/Kolbe_Codex_handoff/models/anode.stl

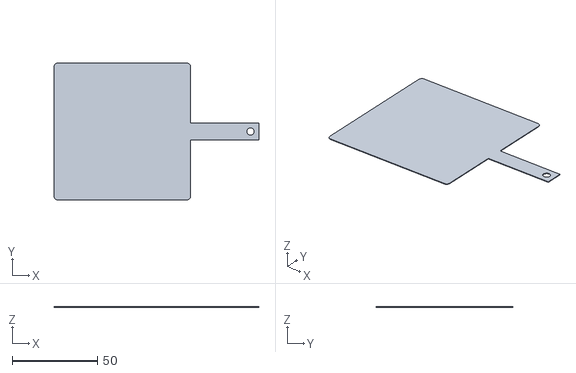
[picture p35: CAD file, 2026-11-03]
models/anode.stl
120.0 x 80.0 x 0.35
