1649472332-arch/Kolbe_Codex_handoff/CAD_v2/modules/Kolbe_5层流体接口组件.step

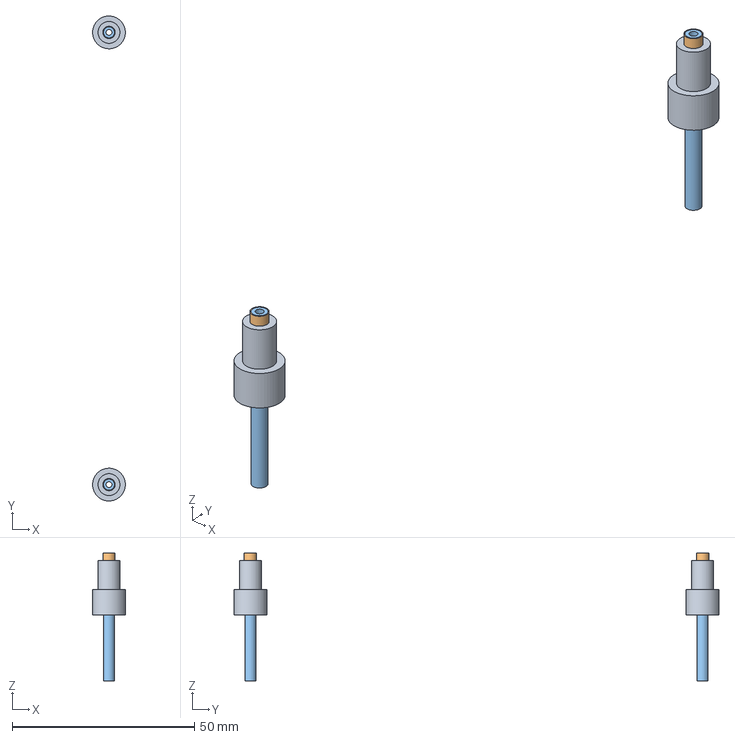
[picture p37: CAD file, 2026-11-03]
CAD_v2/modules/Kolbe_5层流体接口组件.step
8.99 x 133.0 x 35.0 mm
