1649472332-arch/Kolbe_Codex_handoff/CAD_v2/parts/KF-03.step

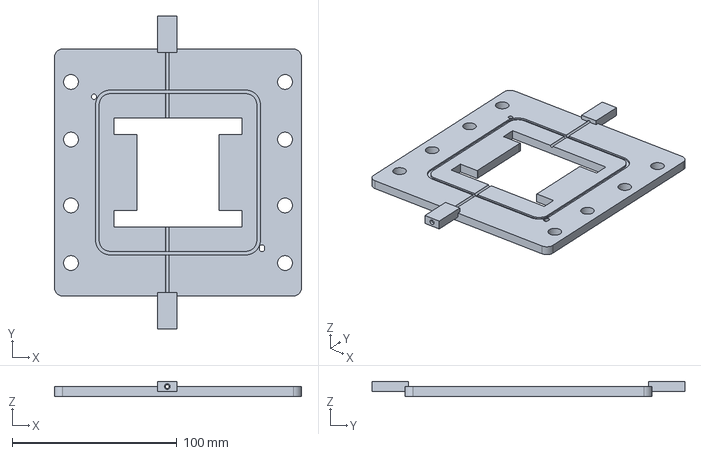
[picture p38: CAD file, 2026-11-03]
CAD_v2/parts/KF-03.step
150.0 x 190.0 x 9.00 mm
