1649472332-arch/Kolbe_Codex_handoff/drawings/cathode_profile.dxf

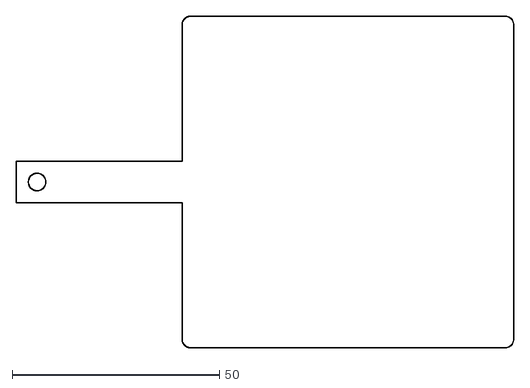
[picture p39: CAD file, 2026-11-03]
drawings/cathode_profile.dxf
120.0 x 80.0
