1649472332-arch/Kolbe_Codex_handoff/CAD_v2/assemblies/Kolbe_5.step

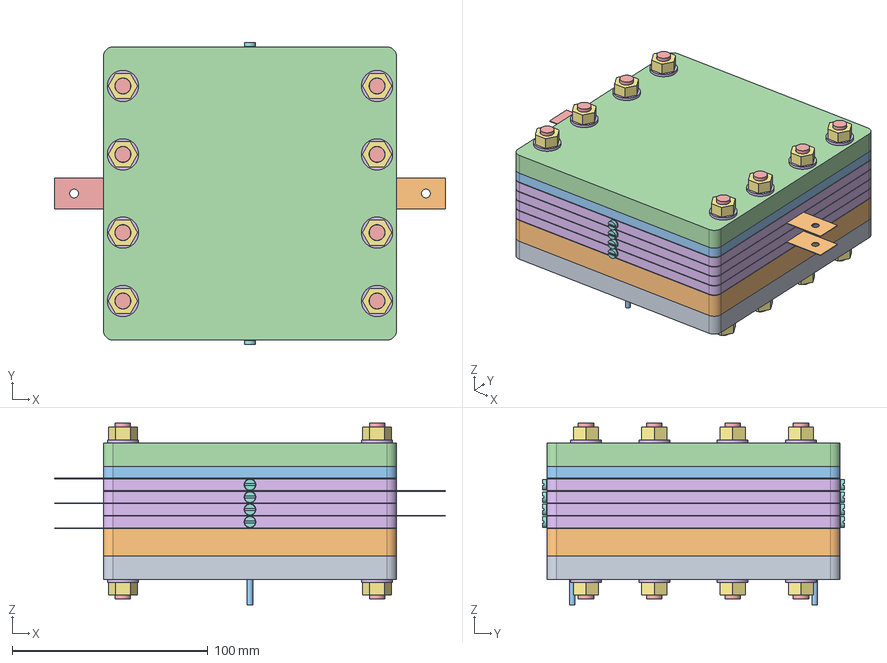
[picture p40: CAD file, 2026-11-03]
CAD_v2/assemblies/Kolbe_5.step
200.0 x 154.6 x 92.9 mm
KP-201｜前端压板
KP-202｜前端绝缘流道板
KS-102｜歧管端面密封圈 x 20
KP-602｜阴极精密绝缘载膜 x 3
KP-102｜阴极电极片 x 3
KF-101｜内部并联流道框 x 4
KS-101｜主流道周边密封圈 x 8
KH-901｜M4横钻孔堵头 x 8
KH-902｜堵头密封垫圈 x 8
KP-601｜阳极精密绝缘载膜 x 2
KP-101｜阳极电极片 x 2
KP-203｜后端绝缘封流板
KP-204｜后端压板
STD-M8-ROD-5-PLATE｜M8×5层压板用拉杆 x 8
STD-M8-WASHER｜M8平垫圈 x 16
STD-M8-NUT｜M8螺母 x 16
STD-LOCATOR-5｜5层电堆绝缘对准销 x 2
KP-501｜M6×1隔板接头螺母 x 2
KP-502｜管路压紧卡套 x 2
KP-503｜电解液导管 x 2
