1649472332-arch/Kolbe_Codex_handoff/CAD_v2/modules/Kolbe_5层流道组件第2号.step

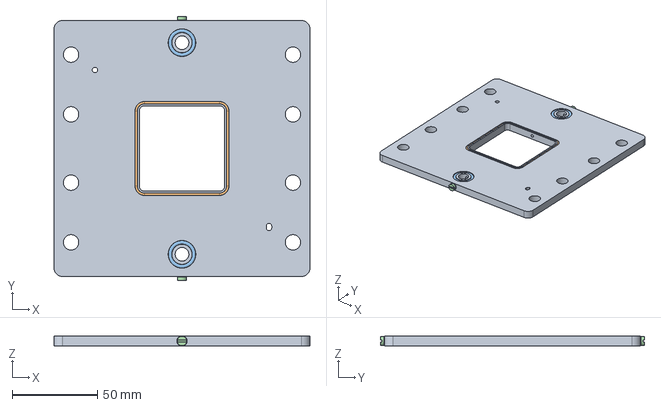
[picture p41: CAD file, 2026-11-03]
CAD_v2/modules/Kolbe_5层流道组件第2号.step
150.0 x 154.6 x 6.00 mm
