1649472332-arch/Kolbe_Codex_handoff/drawings/anode_profile.dxf

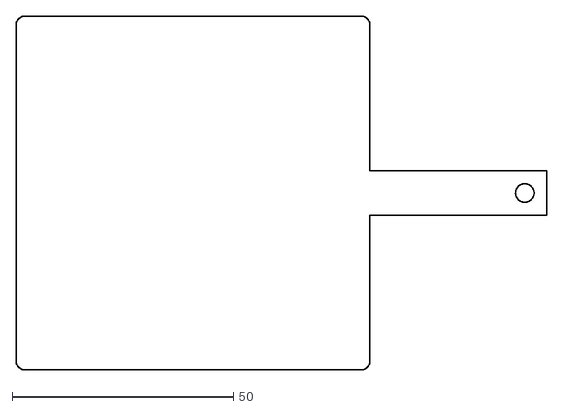
[picture p42: CAD file, 2026-11-03]
drawings/anode_profile.dxf
120.0 x 80.0
