1649472332-arch/Kolbe_Codex_handoff/models/tube_adapter.stl

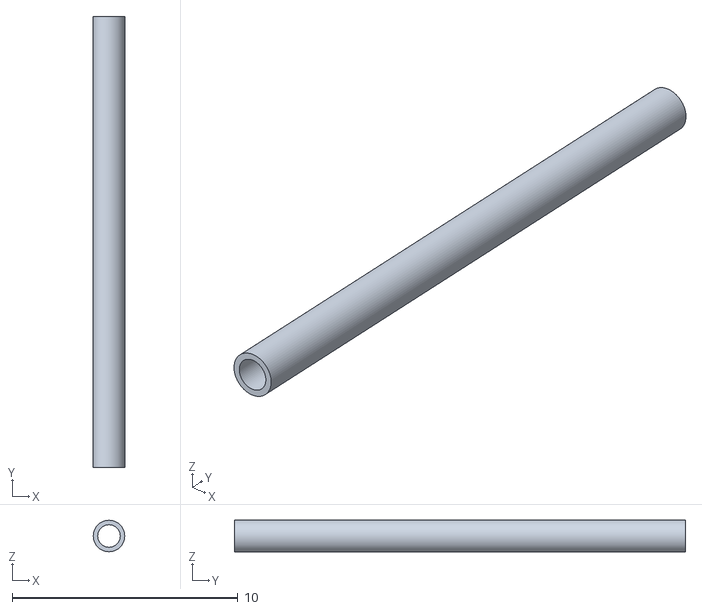
[picture p43: CAD file, 2026-11-03]
models/tube_adapter.stl
1.40 x 20.0 x 1.40
