1649472332-arch/Kolbe_Codex_handoff/models/insulator.stl

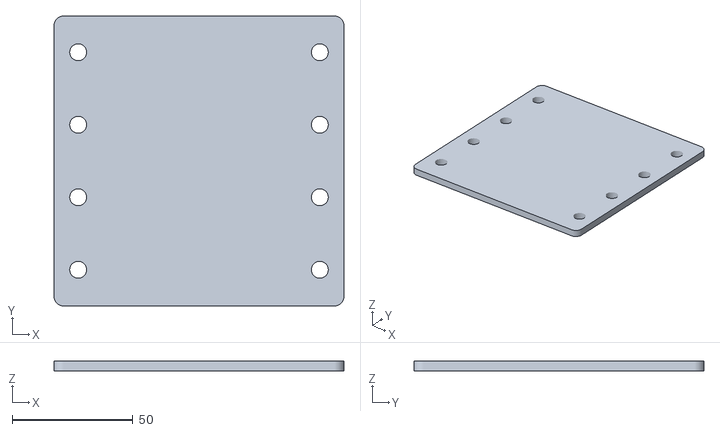
[picture p44: CAD file, 2026-11-03]
models/insulator.stl
120.0 x 120.0 x 4.00
