1649472332-arch/Kolbe_Codex_handoff/CAD_v2/drawings/KH-901_drawing.FCStd

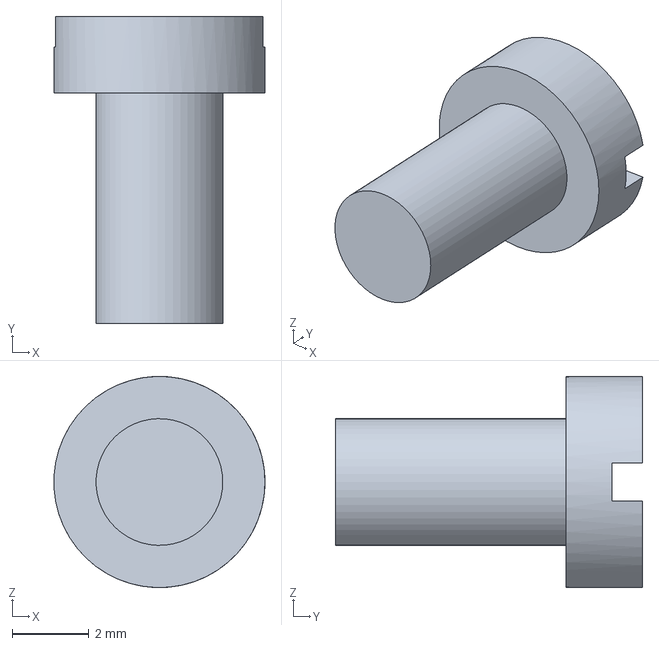
[picture p45: CAD file, 2026-11-03]
CAD_v2/drawings/KH-901_drawing.FCStd
5.49 x 8.00 x 5.50 mm
