1649472332-arch/Kolbe_Codex_handoff/CAD_v2/parts/KP-503.step

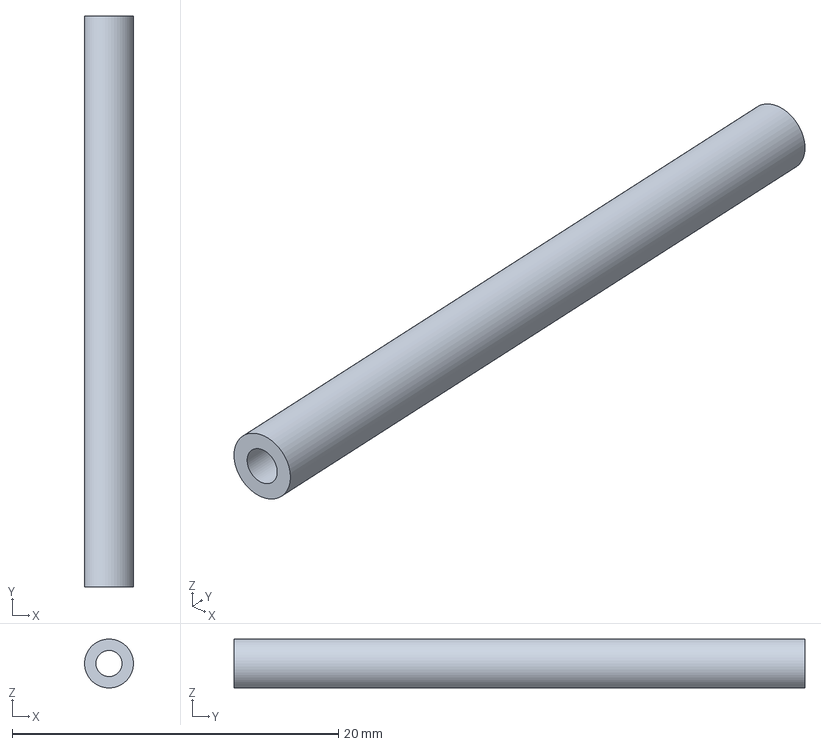
[picture p46: CAD file, 2026-11-03]
CAD_v2/parts/KP-503.step
3.00 x 35.0 x 3.00 mm
