1649472332-arch/Kolbe_Codex_handoff/models/endplate.stl

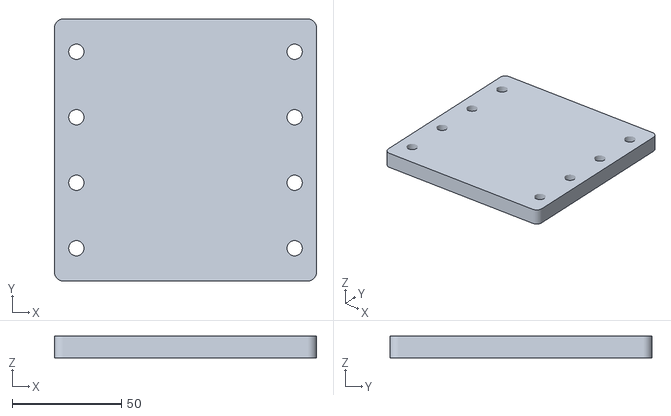
[picture p47: CAD file, 2026-11-03]
models/endplate.stl
120.0 x 120.0 x 10.0
