1649472332-arch/Kolbe_Codex_handoff/CAD_v2/drawings/KF-101_drawing.FCStd

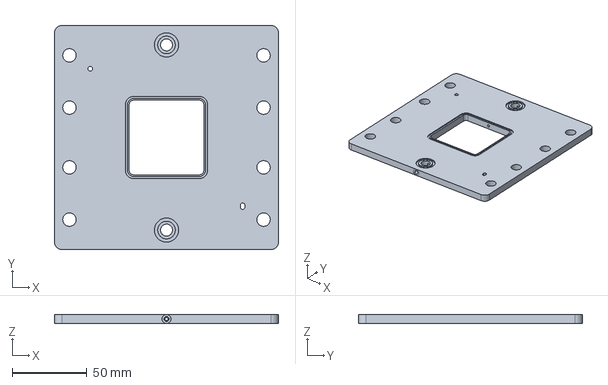
[picture p48: CAD file, 2026-11-03]
CAD_v2/drawings/KF-101_drawing.FCStd
150.0 x 150.0 x 6.00 mm
