1649472332-arch/Kolbe_Codex_handoff/CAD_v2/parts/KS-102.step

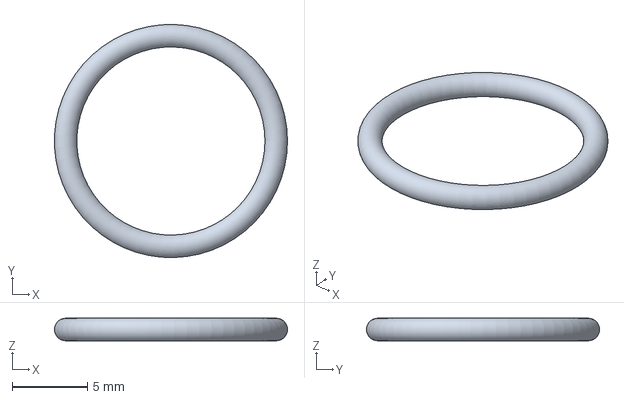
[picture p49: CAD file, 2026-11-03]
CAD_v2/parts/KS-102.step
15.5 x 15.5 x 1.50 mm
