1649472332-arch/Kolbe_Codex_handoff/models/one_frame.stl

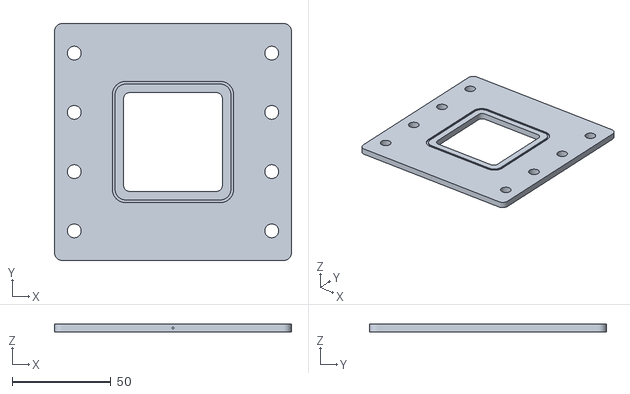
[picture p50: CAD file, 2026-11-03]
models/one_frame.stl
120.0 x 120.0 x 4.00
