1649472332-arch/Kolbe_Codex_handoff/CAD_v2/parts/STD-LOCATOR-7.step

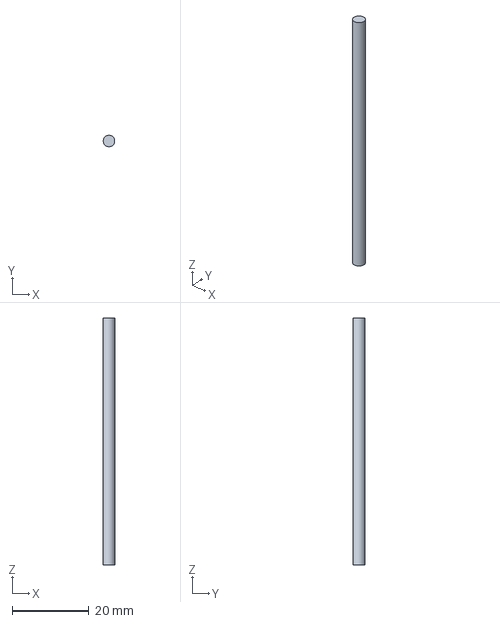
[picture p52: CAD file, 2026-11-03]
CAD_v2/parts/STD-LOCATOR-7.step
3.00 x 3.00 x 64.2 mm
