1649472332-arch/Kolbe_Codex_handoff/CAD_v2/parts/KP-401.step

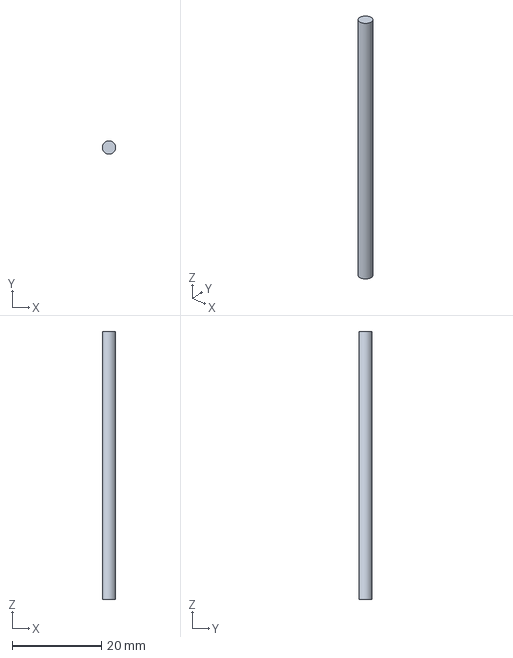
[picture p54: CAD file, 2026-11-03]
CAD_v2/parts/KP-401.step
3.00 x 3.00 x 60.0 mm
