1649472332-arch/Kolbe_Codex_handoff/CAD_v2/parts/KP-502.step

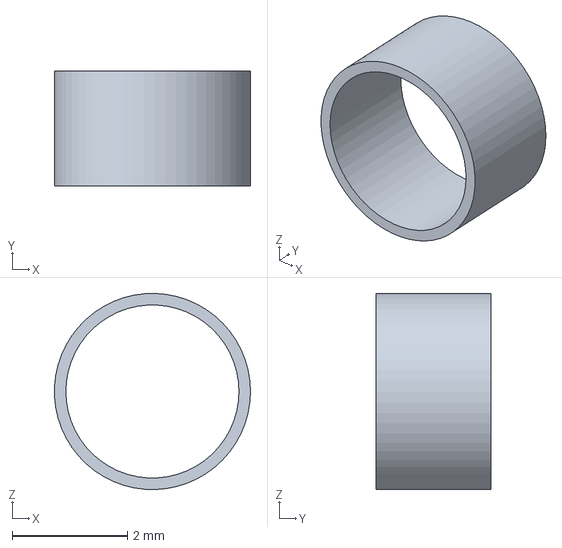
[picture p55: CAD file, 2026-11-03]
CAD_v2/parts/KP-502.step
3.40 x 2.00 x 3.40 mm
