1649472332-arch/Kolbe_Codex_handoff/CAD_v2/modules/Kolbe_5层拉杆与定位组件.step

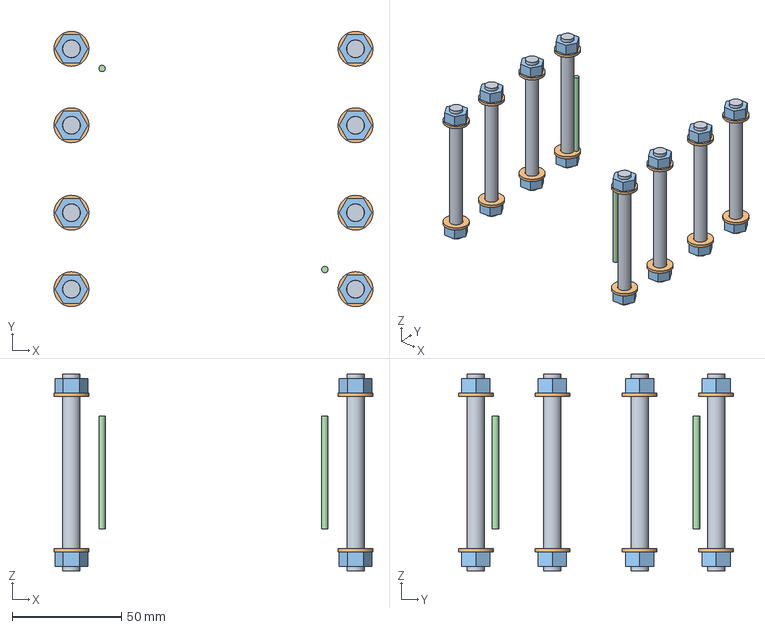
[picture p56: CAD file, 2026-11-03]
CAD_v2/modules/Kolbe_5层拉杆与定位组件.step
146.0 x 126.0 x 89.9 mm
