1649472332-arch/Kolbe_Codex_handoff/CAD_v2/drawings/KH-902_drawing.FCStd

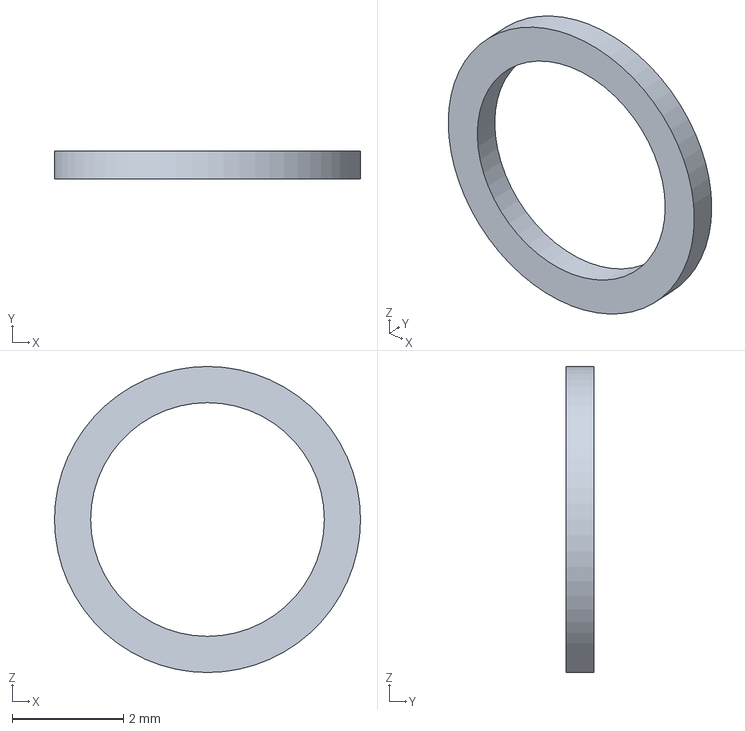
[picture p57: CAD file, 2026-11-03]
CAD_v2/drawings/KH-902_drawing.FCStd
5.50 x 0.5 x 5.50 mm
