1649472332-arch/Kolbe_Codex_handoff/CAD_v2/modules/Kolbe_7层拉杆与定位组件.step

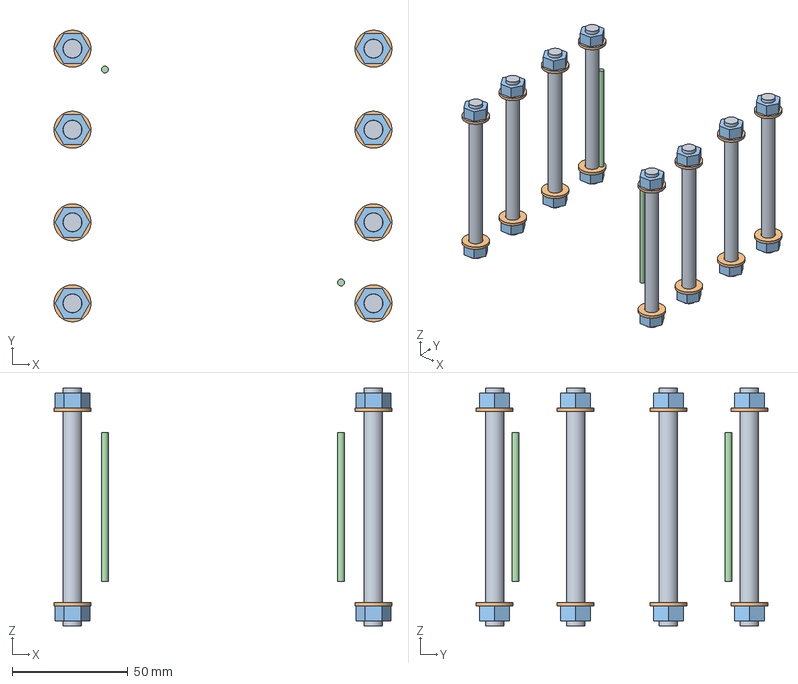
[picture p58: CAD file, 2026-11-03]
CAD_v2/modules/Kolbe_7层拉杆与定位组件.step
146.0 x 126.0 x 102.6 mm
