1649472332-arch/Kolbe_Codex_handoff/CAD_v2/parts/STD-LOCATOR-5.step

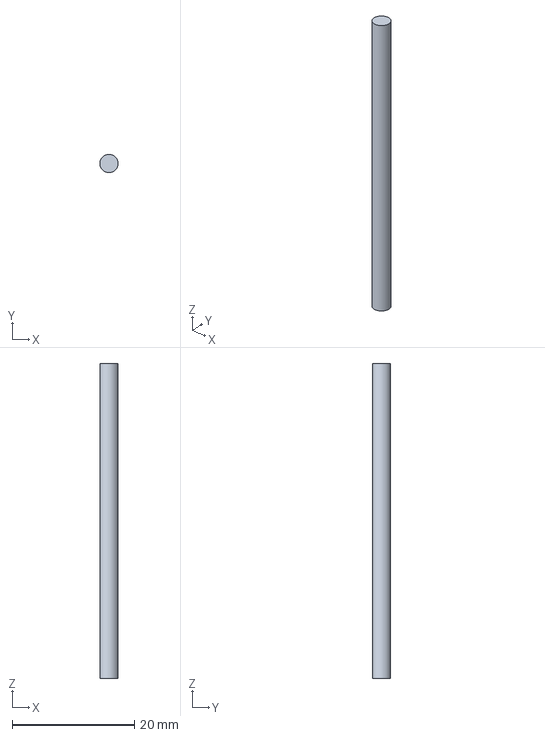
[picture p59: CAD file, 2026-11-03]
CAD_v2/parts/STD-LOCATOR-5.step
3.00 x 3.00 x 51.5 mm
