1649472332-arch/Kolbe_Codex_handoff/CAD_v2/modules/Kolbe_7层后端组件.step

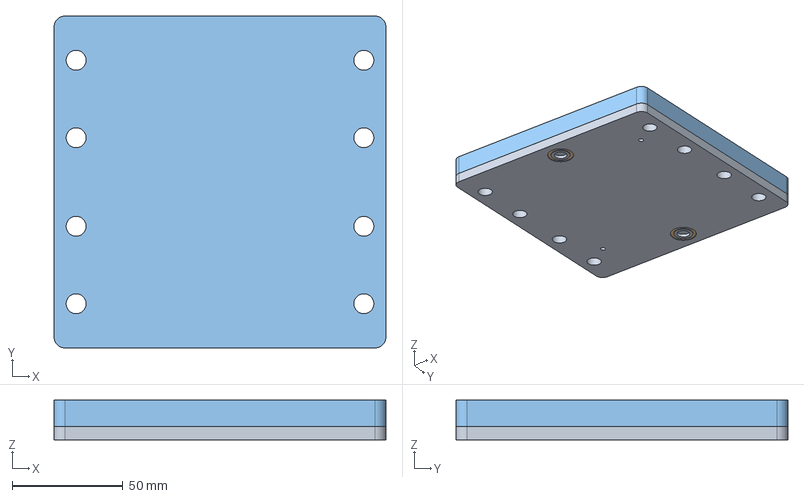
[picture p60: CAD file, 2026-11-03]
CAD_v2/modules/Kolbe_7层后端组件.step
150.0 x 150.0 x 18.0 mm
