1649472332-arch/Kolbe_Codex_handoff/CAD_v2/parts/STD-LOCATOR-3.step

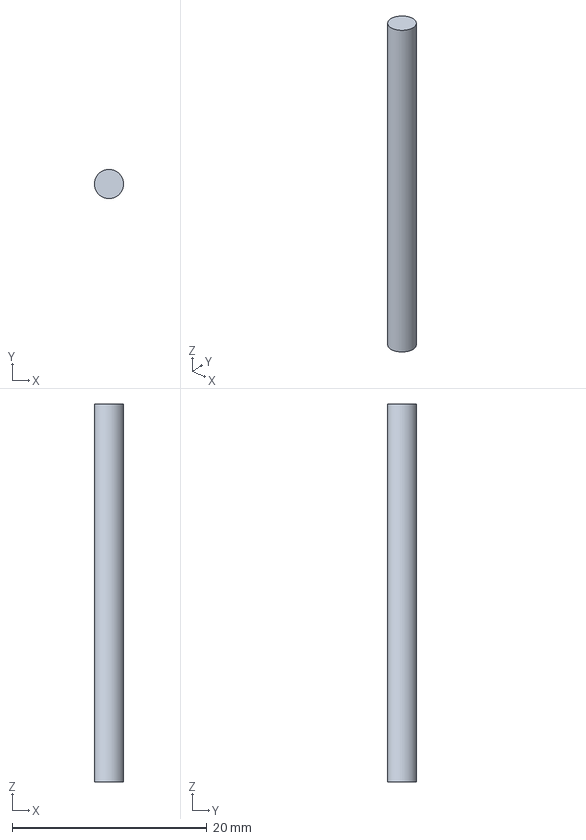
[picture p61: CAD file, 2026-11-03]
CAD_v2/parts/STD-LOCATOR-3.step
3.00 x 3.00 x 38.9 mm
