1649472332-arch/Kolbe_Codex_handoff/CAD_v2/parts/KP-501.step

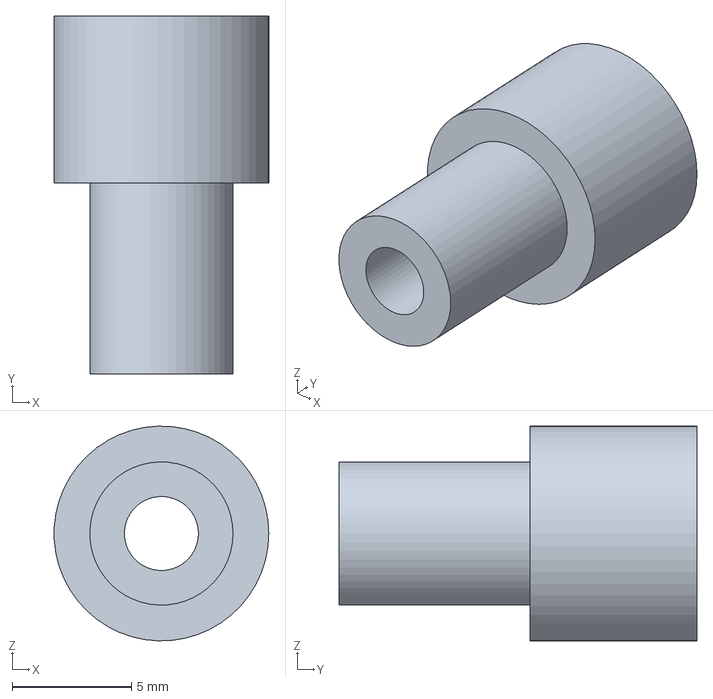
[picture p62: CAD file, 2026-11-03]
CAD_v2/parts/KP-501.step
8.99 x 15.0 x 9.00 mm
