1649472332-arch/Kolbe_Codex_handoff/CAD_v2/drawings/KP-102_drawing.FCStd

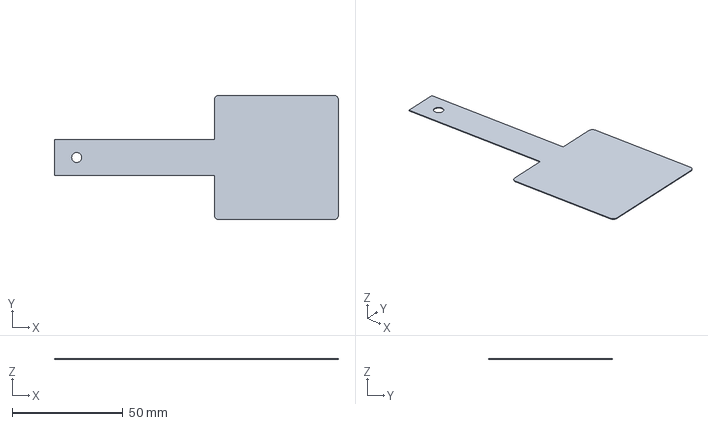
[picture p63: CAD file, 2026-11-03]
CAD_v2/drawings/KP-102_drawing.FCStd
128.0 x 56.0 x 0.35 mm
