1649472332-arch/Kolbe_Codex_handoff/CAD_v2/parts/KS-101.step

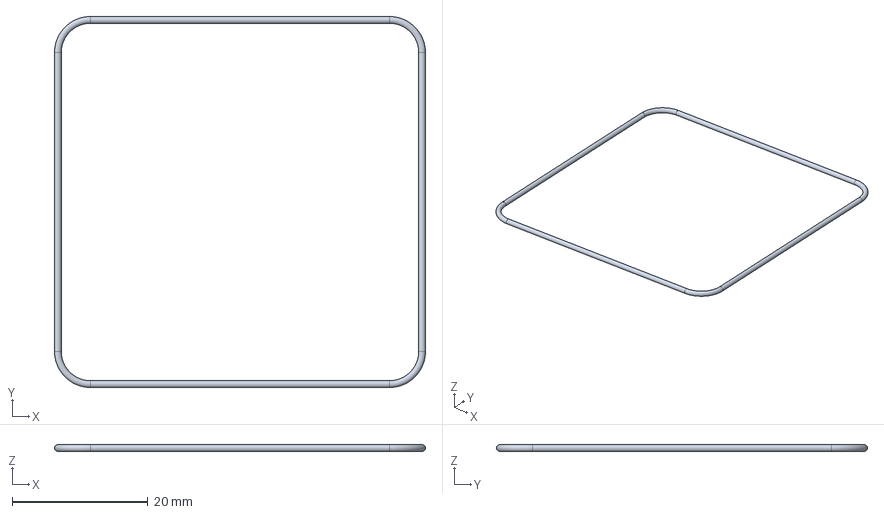
[picture p65: CAD file, 2026-11-03]
CAD_v2/parts/KS-101.step
54.6 x 54.6 x 1 mm
