1649472332-arch/Kolbe_Codex_handoff/CAD_v2/parts/STD-M8-ROD-3-PLATE.step

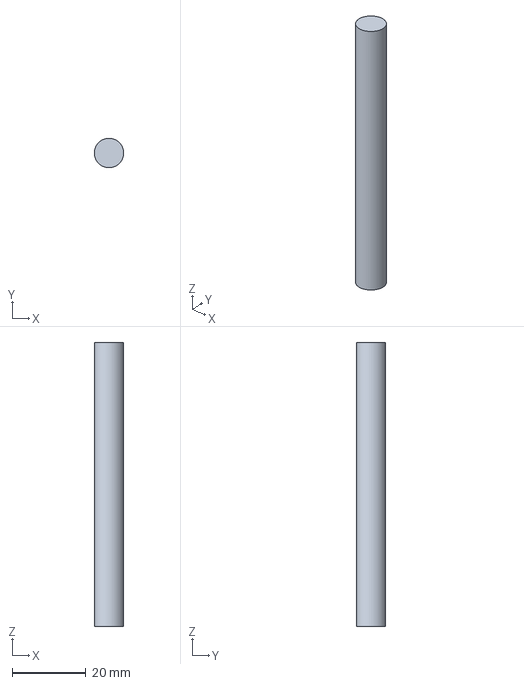
[picture p66: CAD file, 2026-11-03]
CAD_v2/parts/STD-M8-ROD-3-PLATE.step
7.99 x 8.00 x 77.2 mm
