1649472332-arch/Kolbe_Codex_handoff/CAD_v2/modules/Kolbe_3层拉杆与定位组件.step

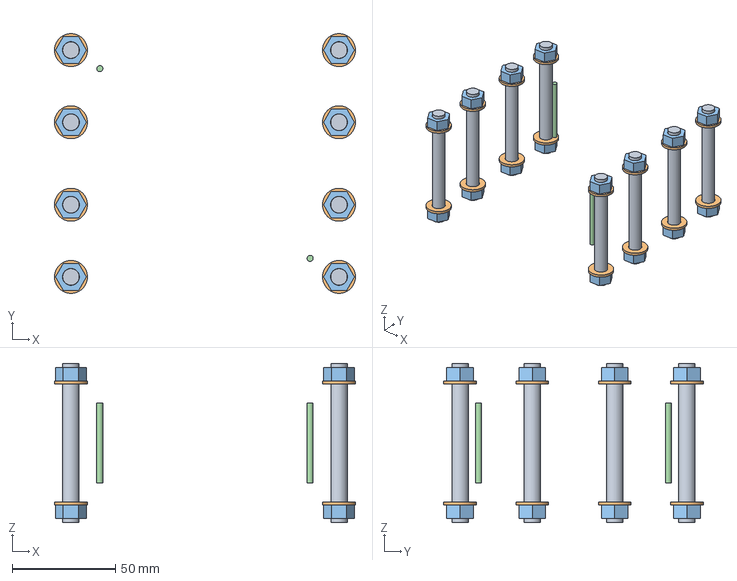
[picture p67: CAD file, 2026-11-03]
CAD_v2/modules/Kolbe_3层拉杆与定位组件.step
146.0 x 126.0 x 77.2 mm
