1649472332-arch/Kolbe_Codex_handoff/(list of files, cad)

Other CAD files:
CAD_v2/parts/KP-601.step
CAD_v2/modules/Kolbe_5层电极组件第2号.step
CAD_v2/parts/KP-201.step
CAD_v2/drawings/KP-204_drawing.FCStd
models/cathode.stl
CAD_v2/drawings/KP-102_plan.dxf
CAD_v2/parts/KF-05.step
CAD_v2/drawings/KP-203_drawing.FCStd
CAD_v2/modules/Kolbe_3层流体接口组件.step
CAD_v2/parts/KP-203.step
CAD_v2/modules/Kolbe_7层流道组件第4号.step
CAD_v2/modules/Kolbe_3层流道组件第1号.step
CAD_v2/drawings/KH-901_plan.dxf
CAD_v2/modules/Kolbe_5层电极组件第0号.step
CAD_v2/drawings/KP-601_plan.dxf
CAD_v2/modules/Kolbe_7层电极组件第6号.step
CAD_v2/drawings/KP-602_drawing.FCStd
CAD_v2/drawings/KF-101_plan.dxf
CAD_v2/parts/KH-902.step
CAD_v2/drawings/KS-102_plan.dxf
CAD_v2/modules/Kolbe_5层前端组件.step
CAD_v2/drawings/KP-101_plan.dxf
CAD_v2/modules/Kolbe_7层流道组件第1号.step
CAD_v2/parts/KF-06.step
CAD_v2/drawings/KP-203_plan.dxf
CAD_v2/modules/Kolbe_3层前端组件.step
CAD_v2/modules/Kolbe_7层电极组件第4号.step
CAD_v2/drawings/KS-101_plan.dxf
CAD_v2/modules/Kolbe_7层流体接口组件.step
CAD_v2/drawings/KP-101_drawing.FCStd
CAD_v2/modules/Kolbe_7层电极组件第0号.step
CAD_v2/drawings/KP-204_plan.dxf
CAD_v2/modules/Kolbe_5层电极组件第3号.step
CAD_v2/parts/KF-04.step
CAD_v2/drawings/KP-201_plan.dxf
CAD_v2/modules/Kolbe_3层电极组件第2号.step
CAD_v2/parts/KH-901.step
CAD_v2/drawings/KH-902_plan.dxf
CAD_v2/modules/Kolbe_5层后端组件.step
CAD_v2/parts/KF-01.step
CAD_v2/drawings/KP-602_plan.dxf
CAD_v2/modules/Kolbe_7层电极组件第3号.step
CAD_v2/drawings/KS-101_drawing.FCStd
CAD_v2/modules/Kolbe_3层流道组件第0号.step
CAD_v2/parts/KP-102.step
CAD_v2/drawings/KS-102_drawing.FCStd
CAD_v2/parts/KP-204.step
CAD_v2/drawings/KP-202_plan.dxf
CAD_v2/modules/Kolbe_7层流道组件第3号.step
CAD_v2/parts/KP-602.step
CAD_v2/modules/Kolbe_5层流道组件第3号.step
CAD_v2/modules/Kolbe_5层流道组件第0号.step
CAD_v2/parts/KF-02.step
CAD_v2/modules/Kolbe_3层电极组件第1号.step
CAD_v2/parts/KP-101.step
CAD_v2/modules/Kolbe_3层电极组件第0号.step
CAD_v2/parts/KF-101.step
CAD_v2/modules/Kolbe_7层电极组件第2号.step
CAD_v2/parts/KP-202.step
CAD_v2/modules/Kolbe_3层后端组件.step
CAD_v2/modules/Kolbe_7层流道组件第2号.step
CAD_v2/modules/Kolbe_7层电极组件第5号.step
CAD_v2/modules/Kolbe_7层流道组件第5号.step
CAD_v2/modules/Kolbe_5层电极组件第4号.step
CAD_v2/modules/Kolbe_5层流道组件第1号.step
CAD_v2/modules/Kolbe_7层电极组件第1号.step
CAD_v2/modules/Kolbe_7层流道组件第0号.step
reference/Kolbe_v37_104p7_shell_68_chamber_8bolts_centered_ports_shifted.scad
CAD_v2/archive/before_no_busbars/assemblies/Kolbe_3.FCStd
CAD_v2/archive/before_no_busbars/assemblies/Kolbe_3.step
CAD_v2/archive/before_no_busbars/assemblies/Kolbe_5.FCStd
CAD_v2/archive/before_no_busbars/assemblies/Kolbe_5.step
CAD_v2/archive/before_no_busbars/assemblies/Kolbe_5_exploded.FCStd
CAD_v2/archive/before_no_busbars/assemblies/Kolbe_5_exploded.step
CAD_v2/archive/before_no_busbars/assemblies/Kolbe_7.FCStd
CAD_v2/archive/before_no_busbars/assemblies/Kolbe_7.step
CAD_v2/archive/before_no_busbars/drawings/KB-801_drawing.FCStd
CAD_v2/archive/before_no_busbars/drawings/KB-801_plan.dxf
CAD_v2/archive/before_no_busbars/drawings/KB-802_drawing.FCStd
CAD_v2/archive/before_no_busbars/drawings/KB-802_plan.dxf
CAD_v2/archive/before_no_busbars/drawings/KB-A3_drawing.FCStd
CAD_v2/archive/before_no_busbars/drawings/KB-A3_plan.dxf
CAD_v2/archive/before_no_busbars/drawings/KB-A5_drawing.FCStd
CAD_v2/archive/before_no_busbars/drawings/KB-A5_plan.dxf
CAD_v2/archive/before_no_busbars/drawings/KB-A7_drawing.FCStd
CAD_v2/archive/before_no_busbars/drawings/KB-A7_plan.dxf
CAD_v2/archive/before_no_busbars/drawings/KB-C3_drawing.FCStd
CAD_v2/archive/before_no_busbars/drawings/KB-C3_plan.dxf
CAD_v2/archive/before_no_busbars/drawings/KB-C5_drawing.FCStd
CAD_v2/archive/before_no_busbars/drawings/KB-C5_plan.dxf
CAD_v2/archive/before_no_busbars/drawings/KB-C7_drawing.FCStd
CAD_v2/archive/before_no_busbars/drawings/KB-C7_plan.dxf
CAD_v2/archive/before_no_busbars/drawings/KF-101_plan.dxf
CAD_v2/archive/before_no_busbars/drawings/KH-901_plan.dxf
CAD_v2/archive/before_no_busbars/drawings/KH-902_plan.dxf
CAD_v2/archive/before_no_busbars/drawings/KP-101_drawing.FCStd
CAD_v2/archive/before_no_busbars/drawings/KP-101_plan.dxf
CAD_v2/archive/before_no_busbars/drawings/KP-102_plan.dxf
CAD_v2/archive/before_no_busbars/drawings/KP-201_plan.dxf
CAD_v2/archive/before_no_busbars/drawings/KP-202_plan.dxf
CAD_v2/archive/before_no_busbars/drawings/KP-203_drawing.FCStd
CAD_v2/archive/before_no_busbars/drawings/KP-203_plan.dxf
CAD_v2/archive/before_no_busbars/drawings/KP-204_drawing.FCStd
CAD_v2/archive/before_no_busbars/drawings/KP-204_plan.dxf
CAD_v2/archive/before_no_busbars/drawings/KP-601_plan.dxf
CAD_v2/archive/before_no_busbars/drawings/KP-602_drawing.FCStd
CAD_v2/archive/before_no_busbars/drawings/KP-602_plan.dxf
CAD_v2/archive/before_no_busbars/drawings/KS-101_drawing.FCStd
CAD_v2/archive/before_no_busbars/drawings/KS-101_plan.dxf
CAD_v2/archive/before_no_busbars/drawings/KS-102_drawing.FCStd
CAD_v2/archive/before_no_busbars/drawings/KS-102_plan.dxf
CAD_v2/archive/before_no_busbars/modules/Kolbe_3_electrical_busbars.FCStd
CAD_v2/archive/before_no_busbars/modules/Kolbe_3_electrical_busbars.step
CAD_v2/archive/before_no_busbars/modules/Kolbe_3_electrode_00.FCStd
CAD_v2/archive/before_no_busbars/modules/Kolbe_3_electrode_00.step
CAD_v2/archive/before_no_busbars/modules/Kolbe_3_electrode_01.FCStd
CAD_v2/archive/before_no_busbars/modules/Kolbe_3_electrode_01.step
CAD_v2/archive/before_no_busbars/modules/Kolbe_3_electrode_02.FCStd
CAD_v2/archive/before_no_busbars/modules/Kolbe_3_electrode_02.step
CAD_v2/archive/before_no_busbars/modules/Kolbe_3_flow_00.FCStd
CAD_v2/archive/before_no_busbars/modules/Kolbe_3_flow_00.step
CAD_v2/archive/before_no_busbars/modules/Kolbe_3_flow_01.FCStd
CAD_v2/archive/before_no_busbars/modules/Kolbe_3_flow_01.step
CAD_v2/archive/before_no_busbars/modules/Kolbe_3_fluid_ports.FCStd
CAD_v2/archive/before_no_busbars/modules/Kolbe_3_fluid_ports.step
CAD_v2/archive/before_no_busbars/modules/Kolbe_3_front_end.FCStd
CAD_v2/archive/before_no_busbars/modules/Kolbe_3_front_end.step
CAD_v2/archive/before_no_busbars/modules/Kolbe_3_rear_end.FCStd
CAD_v2/archive/before_no_busbars/modules/Kolbe_3_rear_end.step
CAD_v2/archive/before_no_busbars/modules/Kolbe_3_tie_rods_alignment.FCStd
CAD_v2/archive/before_no_busbars/modules/Kolbe_3_tie_rods_alignment.step
CAD_v2/archive/before_no_busbars/modules/Kolbe_5_electrical_busbars.FCStd
CAD_v2/archive/before_no_busbars/modules/Kolbe_5_electrical_busbars.step
CAD_v2/archive/before_no_busbars/modules/Kolbe_5_electrode_00.FCStd
CAD_v2/archive/before_no_busbars/modules/Kolbe_5_electrode_00.step
CAD_v2/archive/before_no_busbars/modules/Kolbe_5_electrode_01.FCStd
CAD_v2/archive/before_no_busbars/modules/Kolbe_5_electrode_01.step
CAD_v2/archive/before_no_busbars/modules/Kolbe_5_electrode_02.FCStd
CAD_v2/archive/before_no_busbars/modules/Kolbe_5_electrode_02.step
CAD_v2/archive/before_no_busbars/modules/Kolbe_5_electrode_03.FCStd
CAD_v2/archive/before_no_busbars/modules/Kolbe_5_electrode_03.step
CAD_v2/archive/before_no_busbars/modules/Kolbe_5_electrode_04.FCStd
CAD_v2/archive/before_no_busbars/modules/Kolbe_5_electrode_04.step
CAD_v2/archive/before_no_busbars/modules/Kolbe_5_flow_00.FCStd
CAD_v2/archive/before_no_busbars/modules/Kolbe_5_flow_00.step
CAD_v2/archive/before_no_busbars/modules/Kolbe_5_flow_01.FCStd
CAD_v2/archive/before_no_busbars/modules/Kolbe_5_flow_01.step
CAD_v2/archive/before_no_busbars/modules/Kolbe_5_flow_02.FCStd
CAD_v2/archive/before_no_busbars/modules/Kolbe_5_flow_02.step
CAD_v2/archive/before_no_busbars/modules/Kolbe_5_flow_03.FCStd
CAD_v2/archive/before_no_busbars/modules/Kolbe_5_flow_03.step
CAD_v2/archive/before_no_busbars/modules/Kolbe_5_fluid_ports.FCStd
CAD_v2/archive/before_no_busbars/modules/Kolbe_5_fluid_ports.step
CAD_v2/archive/before_no_busbars/modules/Kolbe_5_front_end.FCStd
CAD_v2/archive/before_no_busbars/modules/Kolbe_5_front_end.step
CAD_v2/archive/before_no_busbars/modules/Kolbe_5_rear_end.FCStd
CAD_v2/archive/before_no_busbars/modules/Kolbe_5_rear_end.step
CAD_v2/archive/before_no_busbars/modules/Kolbe_5_tie_rods_alignment.FCStd
CAD_v2/archive/before_no_busbars/modules/Kolbe_5_tie_rods_alignment.step
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
