1649472332-arch/Kolbe_Codex_handoff/CAD_v2/renders/drawing QA/Kolbe_3_assembly.png

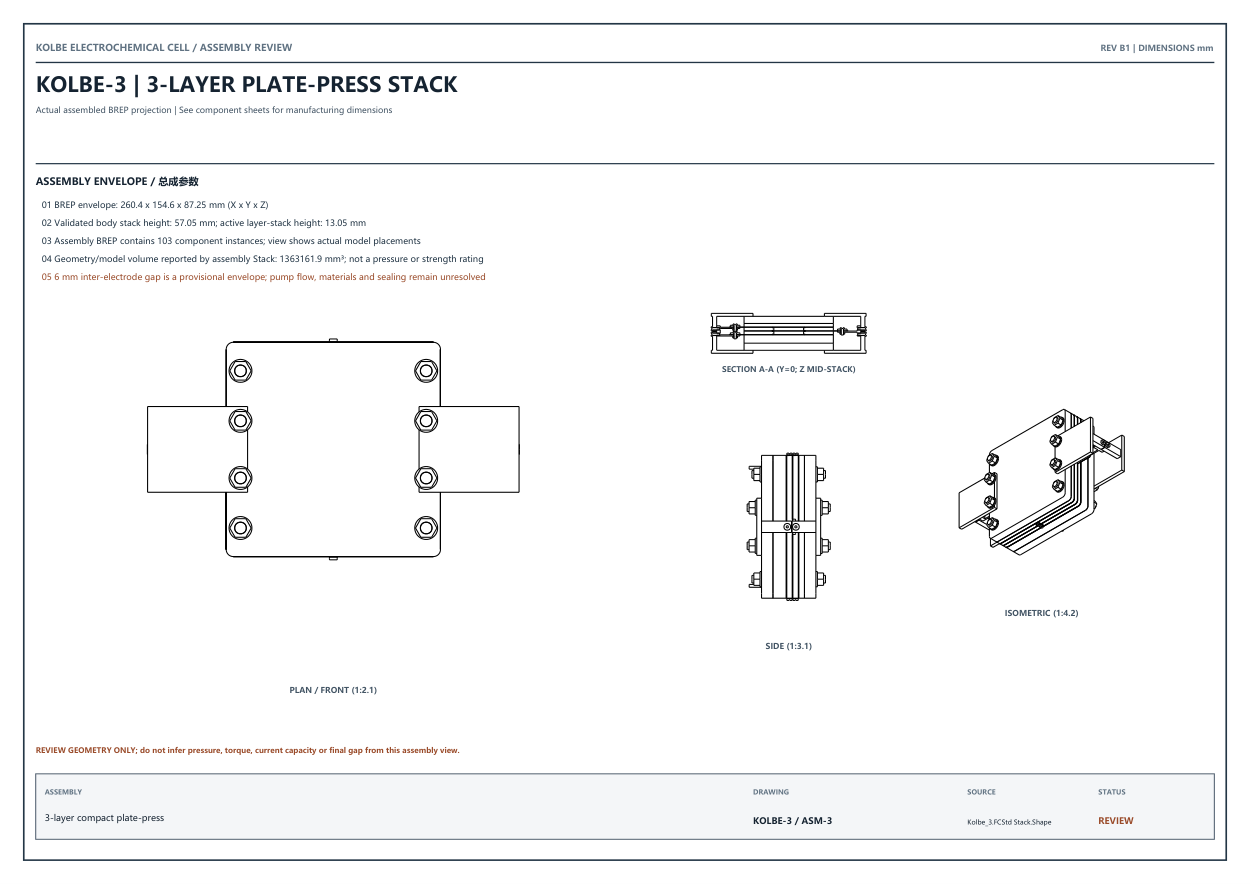
CAD_v2/renders/drawing QA/Kolbe_3_assembly.png
