1649472332-arch/Kolbe_Codex_handoff/renders/assembly_7.png

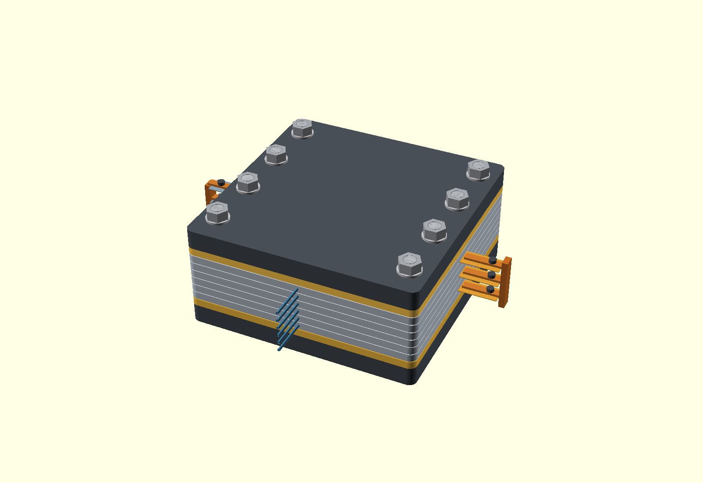
renders/assembly_7.png
