1649472332-arch/Kolbe_Codex_handoff/validation/README.md

# Rev A 实际检查记录（2026-10-30）

- OpenSCAD：3/5/7 电极 × 2/4/6 mm 间距，共 9 组 CSG 生成通过；不等同于实体干涉自动分析。
- 默认间距 4 mm：3 张装配图、爆炸图、单框、流道剖视、接线局部图均实际生成。
- 7 种零件 STL 实体渲染、5 种平面轮廓 DXF 导出完成。STL 三角网格边计数检查均无非流形边；该检查不证明加工可行性。
- 5 组故意错误配置（偶数电极、过大端口、过大密封圈、湿区螺栓、过小电极）均触发断言拒绝。见 assertion_checks.json。
- 独立名义尺寸检查 9 组通过，见 dimension_checks.json。此脚本记录固定 Rev A 尺寸，修改主模型后应同步更新。
- 爆炸图单独以 explode_step_mm=18 和侧向相机重新生成，以提高可读性；接线局部图母排位置同步至 ±82 mm。批量脚本已保存爆炸图参数。
- PDF 经逐页栅格化与视觉检查。PDF 是手工编排的尺寸评审图，与 SCAD 不具备自动关联更新关系。

未执行：结构有限元、接触压力分析、压力/漏液试验、化学相容性试验、热态循环、电流温升、实际泵循环、实际加工和装配。微管与框体接口的固定/密封以及电极定位尚未定型。压力、材料、采购密封圈和制造公差待确定，禁止据本版直接制造运行设备。

完整命令与输出见 export_results.json、logs/；模型为毫米单位。原始 reference/ 文件保留。
