1649472332-arch/Kolbe_Codex_handoff/CAD_v2/renders/drawing QA/review_cover.pdf

### KOLBE ELECTROCHEMICAL CELL / REV B1

# 板式压紧电化学电池

# CAD尺寸评审图册

依据最终零件BREP生成正视、侧视、轴测投影；尺寸单位为mm。

湿窗投影占箔片实体：79.56% = 2492.274 / 3132.566 mm²（50 x 50 R3窗口 / 56 x 56 R2箔片本体；干端子排除）。

审查状态：压力、化学兼容性、材料牌号、制造公差及密封验证未完成。

6 mm间隙仅为机械评审包络；实际电极厚度、装配间隙和泵流量待确认。

不赋予额定压力或最终紧固扭矩。螺纹标注为名义光滑包络，不代表螺旋牙型。

图册包含零件功能、材料现状、主要尺寸、端口/密封/紧固特征和模型投影。

图纸编号：B1-CAD-REVIEW | 禁止用于制造放行

包含3/5/7层当前总成投影及全部在用自定义零件；已剔除未使用的旧端子、铜带和固定长度定位销。
