1649472332-arch/Kolbe_Codex_handoff/CAD_v2/renders/drawing QA/KP-102_drawing.png

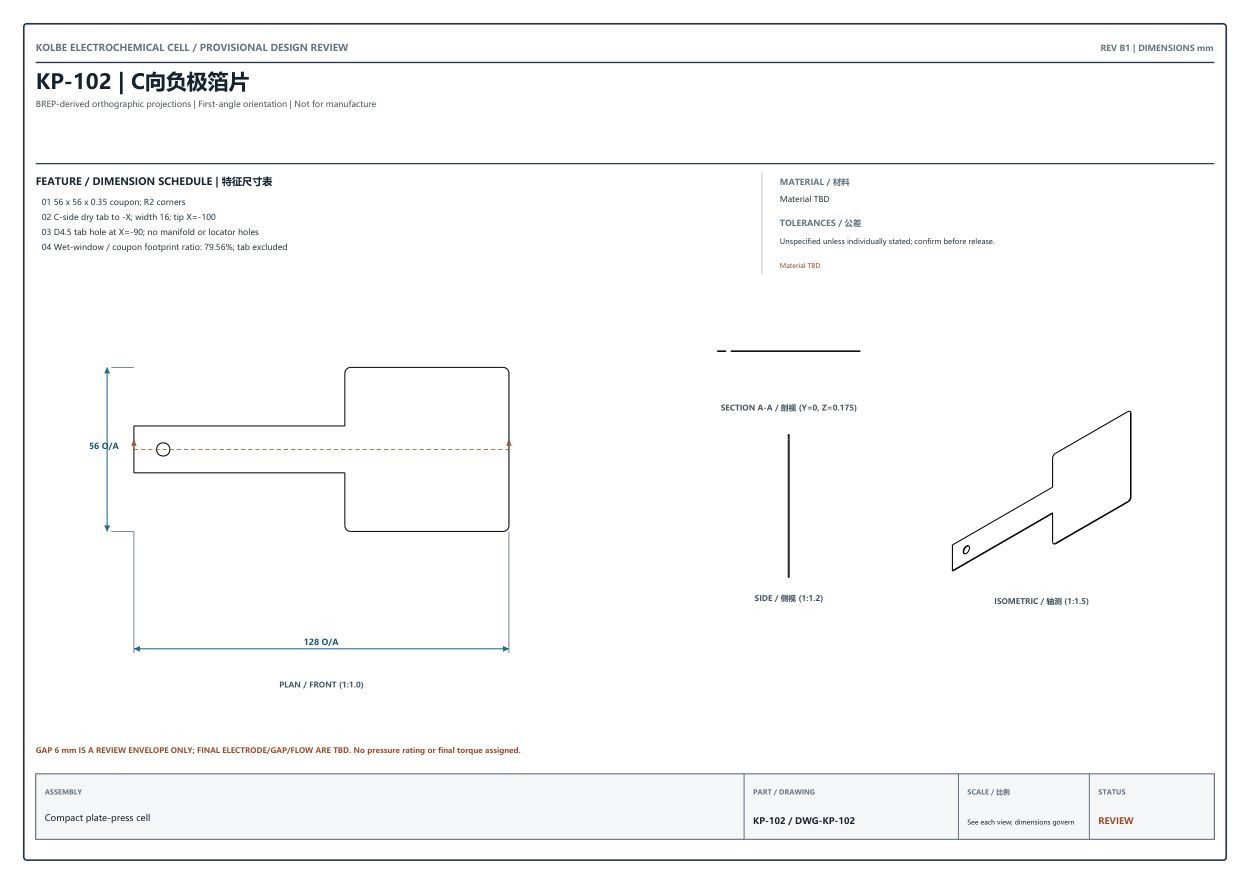
CAD_v2/renders/drawing QA/KP-102_drawing.png
