1649472332-arch/Kolbe_Codex_handoff/CAD_v2/renders/drawing QA/review_page_21.png

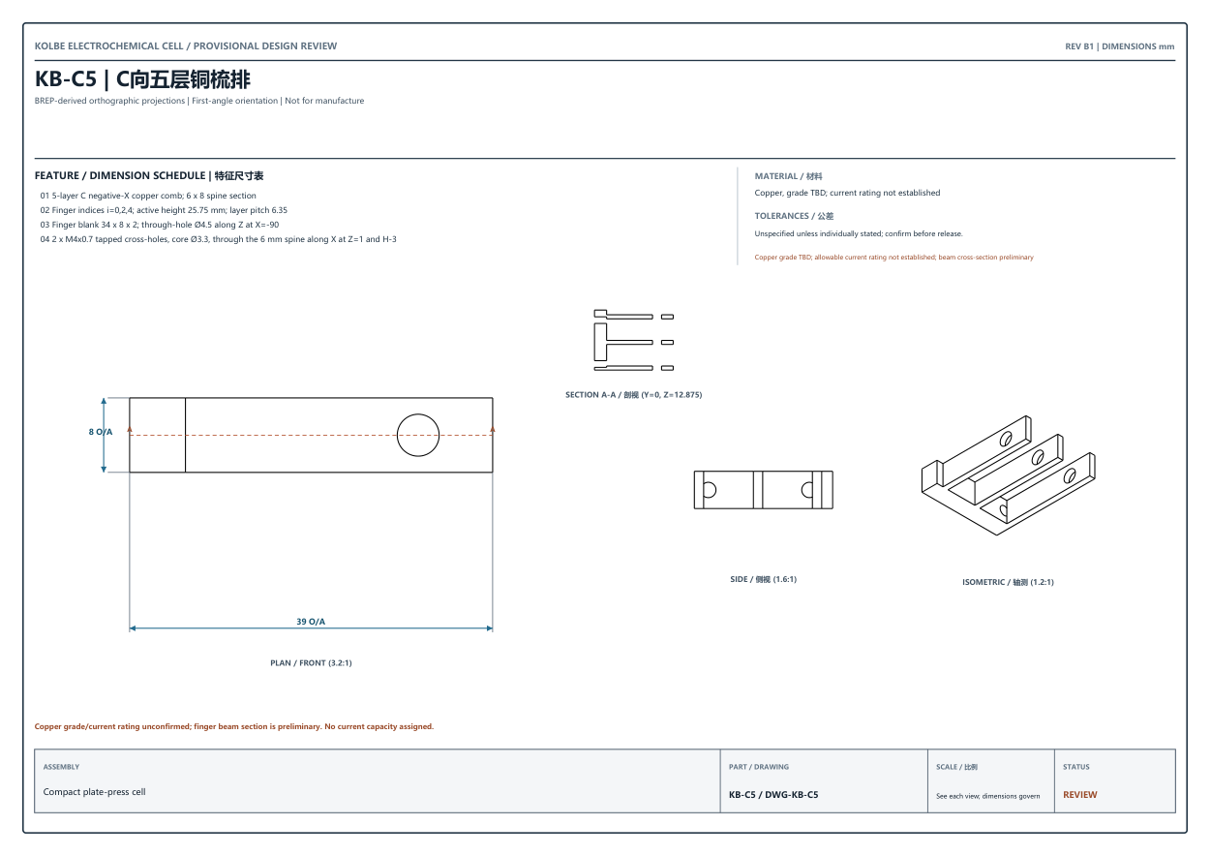
CAD_v2/renders/drawing QA/review_page_21.png
