1649472332-arch/Kolbe_Codex_handoff/CAD_v2/renders/review_QA/page_01.png

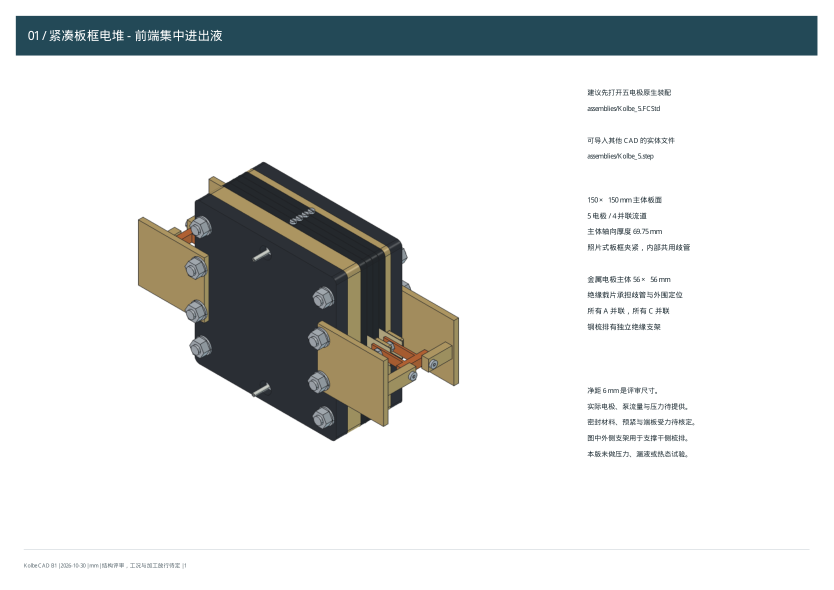
CAD_v2/renders/review_QA/page_01.png
