1649472332-arch/Kolbe_Codex_handoff/CAD_v2/validation/inspection_gui_initial_animation_failure.txt

Traceback (most recent call last):
  File "C:/Users/16494/Desktop/Kolbe_Codex_handoff/CAD_v2/scripts/verify_inspection.FCMacro", line 18, in <module>
    assert max(abs(a-b) for a,b in zip(before,after))>1e-6, (before,after)
           ^^^^^^^^^^^^^^^^^^^^^^^^^^^^^^^^^^^^^^^^^^^^^^^
AssertionError: ((0.4654341672135181, 0.2815082689850717, 0.28150809017113604, 0.7904918251642372), (0.4654341672135181, 0.2815082689850717, 0.28150809017113604, 0.7904918251642372))
