1649472332-arch/Kolbe_Codex_handoff/CAD_v2/archive/before_no_busbars/drawings/Kolbe_3_assembly.pdf

# KOLBE-3 | 3-LAYER PLATE-PRESS STACK

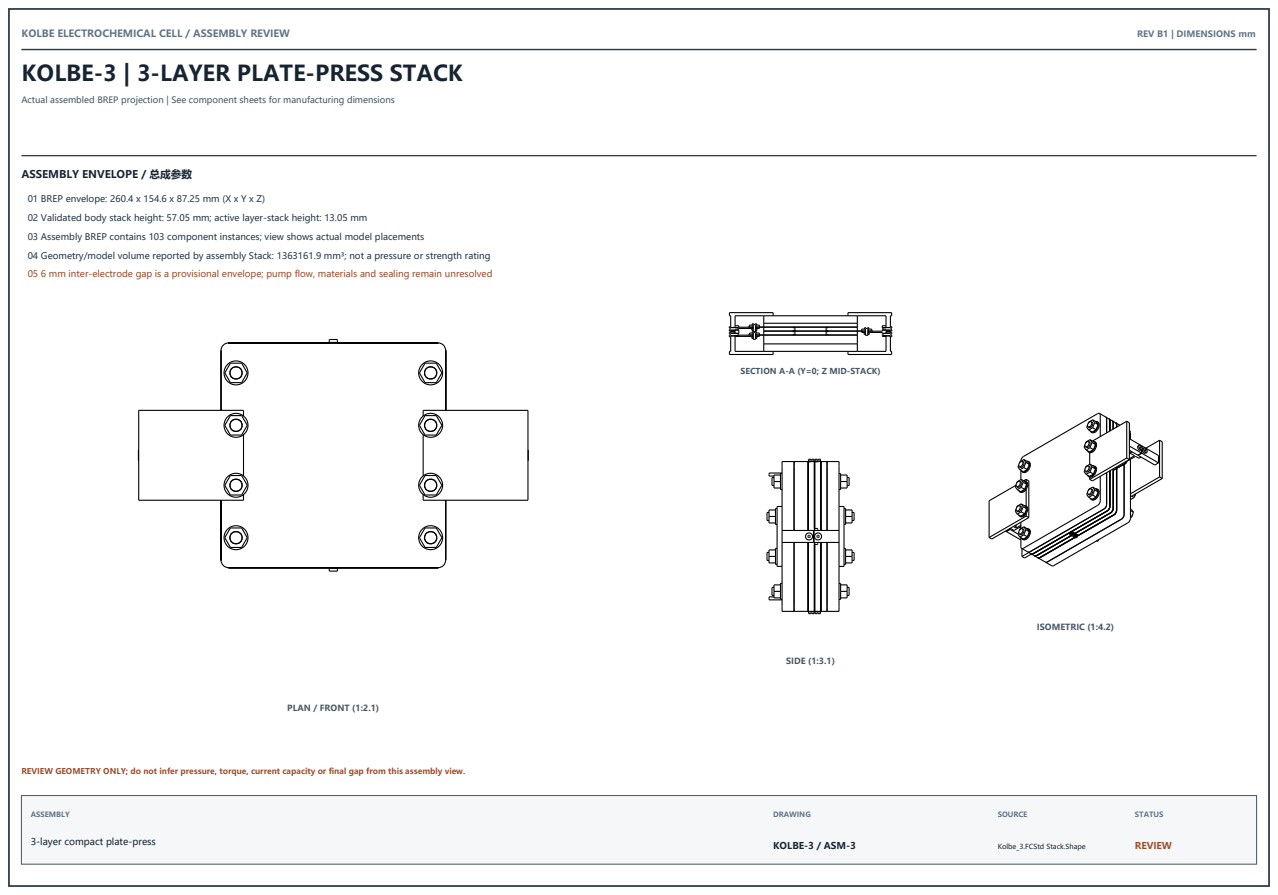
[picture p89: page 1]
KOLBE ELECTROCHEMICAL CELL / ASSEMBLY REVIEW; REV B1 | DIMENSIONS mm; PLAN / FRONT (1:2.1); SIDE (1:3.1); ISOMETRIC (1:4.2); ASSEMBLY; DRAWING; KOLBE-3 / ASM-3; SOURCE; STATUS; REVIEW

Actual assembled BREP projection | See component sheets for manufacturing dimensions

ASSEMBLY ENVELOPE / 总成参数

01 BREP envelope: 260.4 x 154.6 x 87.25 mm (X x Y x Z)
02 Validated body stack height: 57.05 mm; active layer-stack height: 13.05 mm
03 Assembly BREP contains 103 component instances; view shows actual model placements
04 Geometry/model volume reported by assembly Stack: 1363161.9 mm³; not a pressure or strength rating
05 6 mm inter-electrode gap is a provisional envelope; pump flow, materials and sealing remain unresolved

SECTION A-A (Y=0; Z MID-STACK)

REVIEW GEOMETRY ONLY; do not infer pressure, torque, current capacity or final gap from this assembly view.

3-layer compact plate-press

Kolbe_3.FCStd Stack.Shape
