1649472332-arch/Kolbe_Codex_handoff/CAD_v2/archive/before_no_busbars/Kolbe_CAD_B1_review.pdf

# 01 / 紧凑板框电堆 - 前端集中进出液


Kolbe CAD B1 | 2026-10-30 | mm | 结构评审，工况与加工放行待定 | 1

## 建议先打开五电极原生装配

## assemblies/Kolbe_5.FCStd

## 可导入其他 CAD 的实体文件

## assemblies/Kolbe_5.step

## 150 × 150 mm 主体板面

## 5 电极 / 4 并联流道

## 主体轴向厚度 69.75 mm

## 照片式板框夹紧，内部共用歧管

## 金属电极主体 56 × 56 mm

## 绝缘载片承担歧管与外围定位

## 所有 A 并联，所有 C 并联

## 铜梳排有独立绝缘支架

## 净距 6 mm 是评审尺寸。

## 实际电极、泵流量与压力待提供。

## 密封材料、预紧与端板受力待核定。

## 图中外侧支架用于支撑干侧梳排。

## 本版未做压力、漏液或热态试验。

# 02 / 分层拆装 - 电极与绝缘载片分离


Kolbe CAD B1 | 2026-10-30 | mm | 结构评审，工况与加工放行待定 | 2

## 从前至后：

## 前压板 / 前绝缘液路板

## C / 流道框 / A / 流道框 / C

## 流道框 / A / 流道框 / C

## 后绝缘封液板 / 后压板

## 每张金属片配同厚绝缘载片。

## 主密封圈仅压金属片窄边。

## 歧管密封圈压在绝缘载片上。

## 内部电极两面均面向流道。

## 最外侧阴极主要使用朝内一面。

## 爆炸图横向移出金属电极，

## 用于检查反应窗、耳片与载片。

## 铜连接与紧固件在本图中省略。

## 单件 FCStd 保留原生特征树。

## 装配零件定义嵌入同一文件，

## 无外部零件引用。

## 定位采用明确基准放置；

## 未添加运动学装配约束。

# 03 / 电极面积 - 窄边密封，外围由绝缘载片承担

双面开放反应窗口

Kolbe CAD B1 | 2026-10-30 | mm | 结构评审，工况与加工放行待定 | 3

## 金属主体 56 × 56 / R2；窗口 50 × 50 / R3

## 橙线：密封槽边界（中心线 53.6 / R4.8；宽 1.4）

## 外槽边至金属边名义余量 0.5 mm；需结合公差与薄片变形核查。

## 按圆角轮廓计算：

## 单面窗口面积：2492.27 mm²

## 金属主体面积：3132.57 mm²

## 主体几何面积占比：79.56%

## 计入当前干侧耳片后，金属总面积 4284.57 mm²，

## 窗口占金属总面积 58.17%。

## 这是几何开窗面积，不是实测电化学有效面积。

## 载片不覆盖金属反应面。

## 实际电极尺寸未提供，主体和窗口均可重做。

## 如采用镀铂钛，可将铂镀层限制在工作区，

## 耳片与密封边的镀覆范围另行明确。


## 150 mm 绝缘载片承担歧管孔、定位与外围。

# 04 / 实际 CAD 核验与待定工程输入

Kolbe CAD B1 | 2026-10-30 | mm | 结构评审，工况与加工放行待定 | 4
电极数 电极数 | 内部流道 | 主体厚度 / mm | STEP 实体数 | 未解释实体干涉
| | 57.05 | 103
69.75 | 135
82.45 | 167

# 已核验：原生装配可打开；全部实例为有效实体；STEP 重新导入实体数量一致。

# 螺纹采用名义包络。M4 螺钉与攻丝底孔的设计啮合已单列，不属于遗漏的碰撞。

# 密封件装配形状为保面积椭圆截面示意，供货尺寸以独立自由态零件为准。

# 仍需：实际电极长宽厚及材料、泵工作流量与最大压力、电解液/溶剂、温度和电流。

# 据此确定净距、支路孔径、材料、密封圈、公差、预紧以及端板挠度要求。

# 内部共用歧管仍需检查旁路电流、并联流量分配和气体排放路径。

# 未执行实际加工、压力/漏液、介质相容性、热循环和电气温升试验。

# 后附原生实体投影与剖视图。每个定制件的 FCStd 与 STEP 见 parts/。

## KOLBE ELECTROCHEMICAL CELL / REV B1

# 板式压紧电化学电池

# CAD尺寸评审图册

依据最终零件BREP生成正视、侧视、轴测投影；尺寸单位为mm。

湿窗投影占箔片实体：79.56% = 2492.274 / 3132.566 mm²（50 x 50 R3窗口 / 56 x 56 R2箔片本体；干端子排除）。

审查状态：压力、化学兼容性、材料牌号、制造公差及密封验证未完成。

6 mm间隙仅为机械评审包络；实际电极厚度、装配间隙和泵流量待确认。

不赋予额定压力或最终紧固扭矩。螺纹标注为名义光滑包络，不代表螺旋牙型。

图册包含零件功能、材料现状、主要尺寸、端口/密封/紧固特征和模型投影。

图纸编号：B1-CAD-REVIEW | 禁止用于制造放行

包含3/5/7层当前总成投影及全部在用自定义零件；已剔除未使用的旧端子、铜带和固定长度定位销。

# KOLBE-3 | 3-LAYER PLATE-PRESS STACK

### ASSEMBLY ENVELOPE / 总成参数

KOLBE ELECTROCHEMICAL CELL / ASSEMBLY REVIEW; REV B1 | DIMENSIONS mm; PLAN / FRONT (1:2.1); SIDE (1:3.1); ISOMETRIC (1:4.2); ASSEMBLY; DRAWING; KOLBE-3 / ASM-3; SOURCE; STATUS; REVIEW

Actual assembled BREP projection | See component sheets for manufacturing dimensions

01 BREP envelope: 260.4 x 154.6 x 87.25 mm (X x Y x Z)
02 Validated body stack height: 57.05 mm; active layer-stack height: 13.05 mm
03 Assembly BREP contains 103 component instances; view shows actual model placements
04 Geometry/model volume reported by assembly Stack: 1363161.9 mm³; not a pressure or strength rating
05 6 mm inter-electrode gap is a provisional envelope; pump flow, materials and sealing remain unresolved

SECTION A-A (Y=0; Z MID-STACK)

REVIEW GEOMETRY ONLY; do not infer pressure, torque, current capacity or final gap from this assembly view.

3-layer compact plate-press

Kolbe_3.FCStd Stack.Shape

# KOLBE-5 | 5-LAYER PLATE-PRESS STACK

### ASSEMBLY ENVELOPE / 总成参数

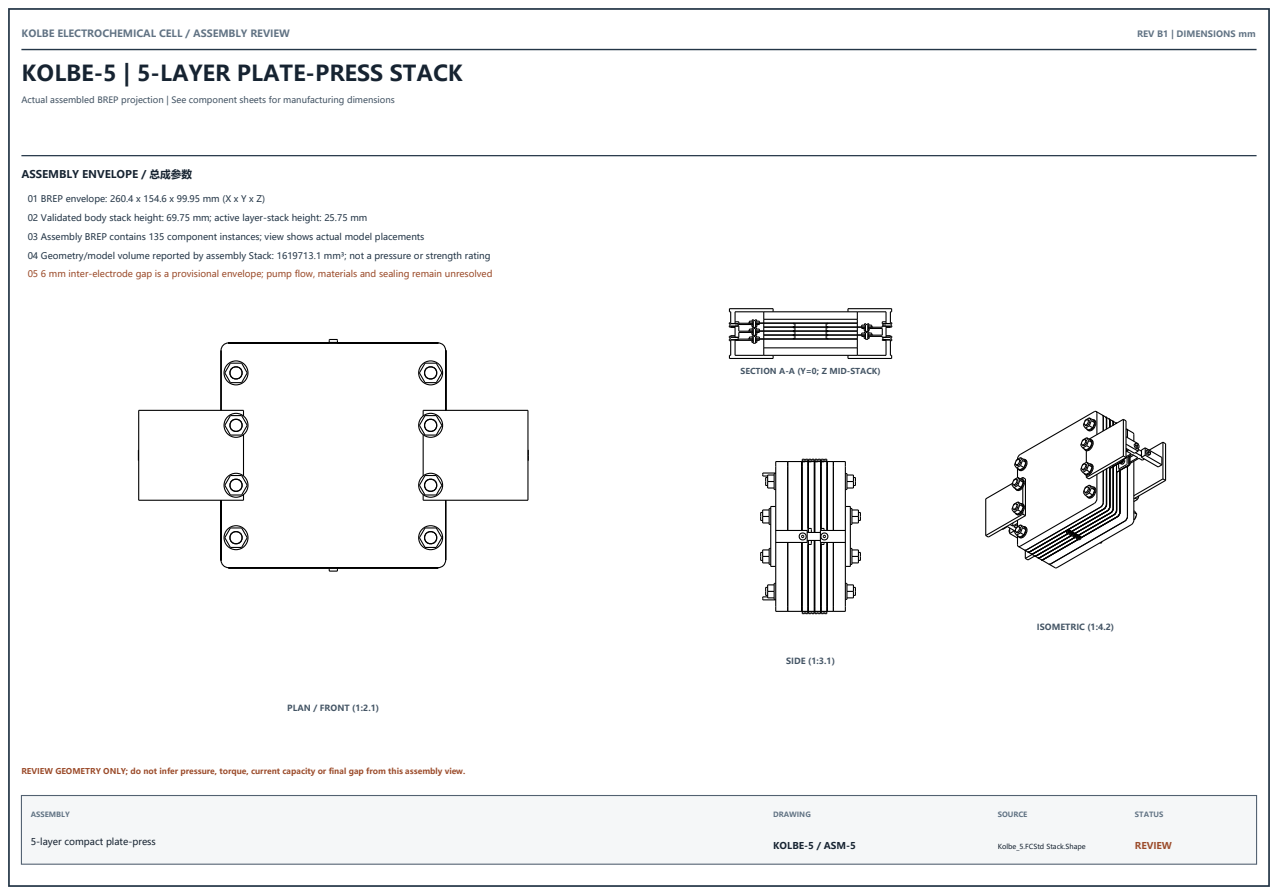
[picture p90: page 7]
KOLBE ELECTROCHEMICAL CELL / ASSEMBLY REVIEW; REV B1 | DIMENSIONS mm; PLAN / FRONT (1:2.1); SIDE (1:3.1); ISOMETRIC (1:4.2); ASSEMBLY; DRAWING; KOLBE-5 / ASM-5; SOURCE; STATUS

Actual assembled BREP projection | See component sheets for manufacturing dimensions

01 BREP envelope: 260.4 x 154.6 x 99.95 mm (X x Y x Z)
02 Validated body stack height: 69.75 mm; active layer-stack height: 25.75 mm
03 Assembly BREP contains 135 component instances; view shows actual model placements
04 Geometry/model volume reported by assembly Stack: 1619713.1 mm³; not a pressure or strength rating
05 6 mm inter-electrode gap is a provisional envelope; pump flow, materials and sealing remain unresolved

SECTION A-A (Y=0; Z MID-STACK)

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

5-layer compact plate-press

Kolbe_5.FCStd Stack.Shape

# KOLBE-7 | 7-LAYER PLATE-PRESS STACK

### ASSEMBLY ENVELOPE / 总成参数

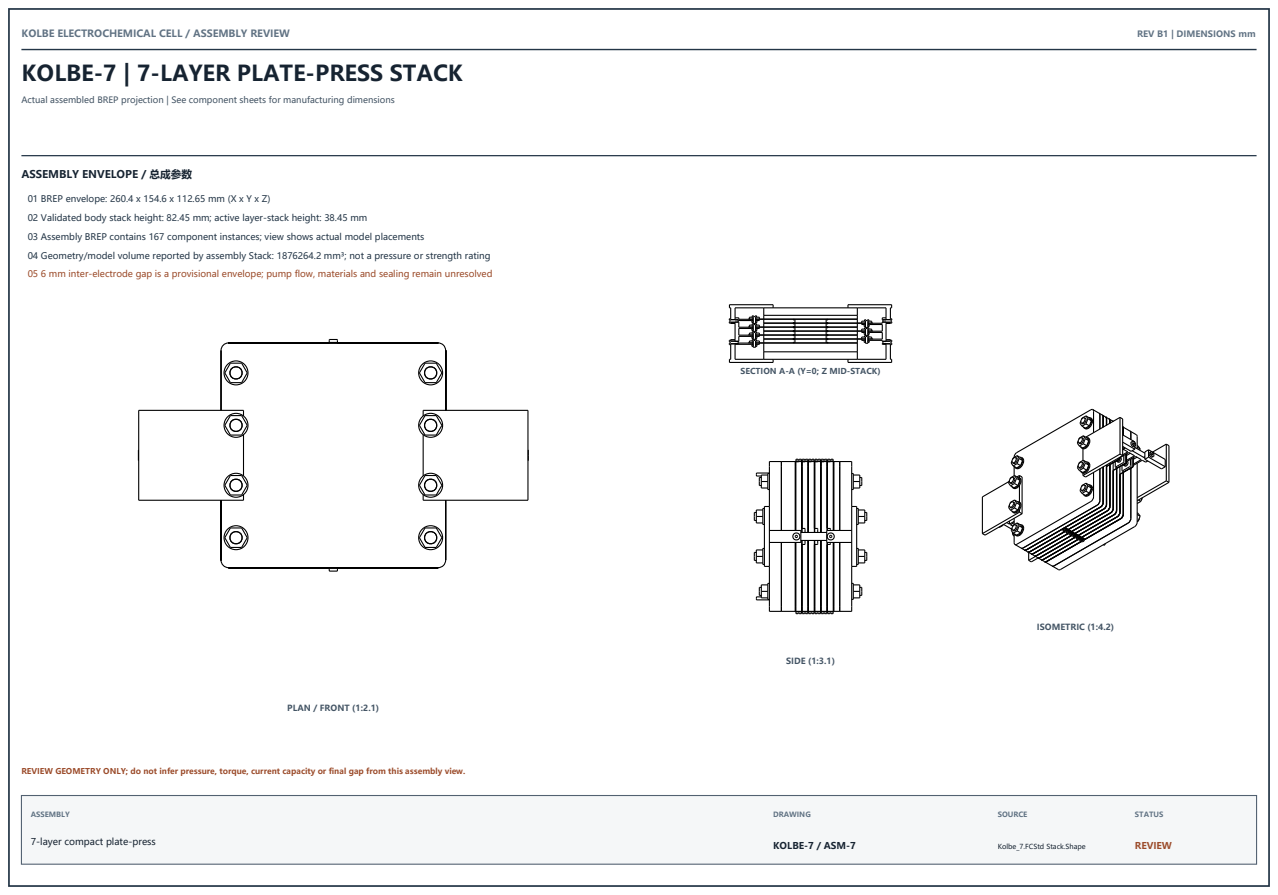
[picture p91: page 8]
KOLBE ELECTROCHEMICAL CELL / ASSEMBLY REVIEW; REV B1 | DIMENSIONS mm; PLAN / FRONT (1:2.1); SIDE (1:3.1); ISOMETRIC (1:4.2); ASSEMBLY; DRAWING; KOLBE-7 / ASM-7; SOURCE; STATUS

Actual assembled BREP projection | See component sheets for manufacturing dimensions

01 BREP envelope: 260.4 x 154.6 x 112.65 mm (X x Y x Z)
02 Validated body stack height: 82.45 mm; active layer-stack height: 38.45 mm
03 Assembly BREP contains 167 component instances; view shows actual model placements
04 Geometry/model volume reported by assembly Stack: 1876264.2 mm³; not a pressure or strength rating
05 6 mm inter-electrode gap is a provisional envelope; pump flow, materials and sealing remain unresolved

SECTION A-A (Y=0; Z MID-STACK)

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

7-layer compact plate-press

Kolbe_7.FCStd Stack.Shape

# KF-101 | 流道框架

### FEATURE / DIMENSION SCHEDULE | 特征尺寸表

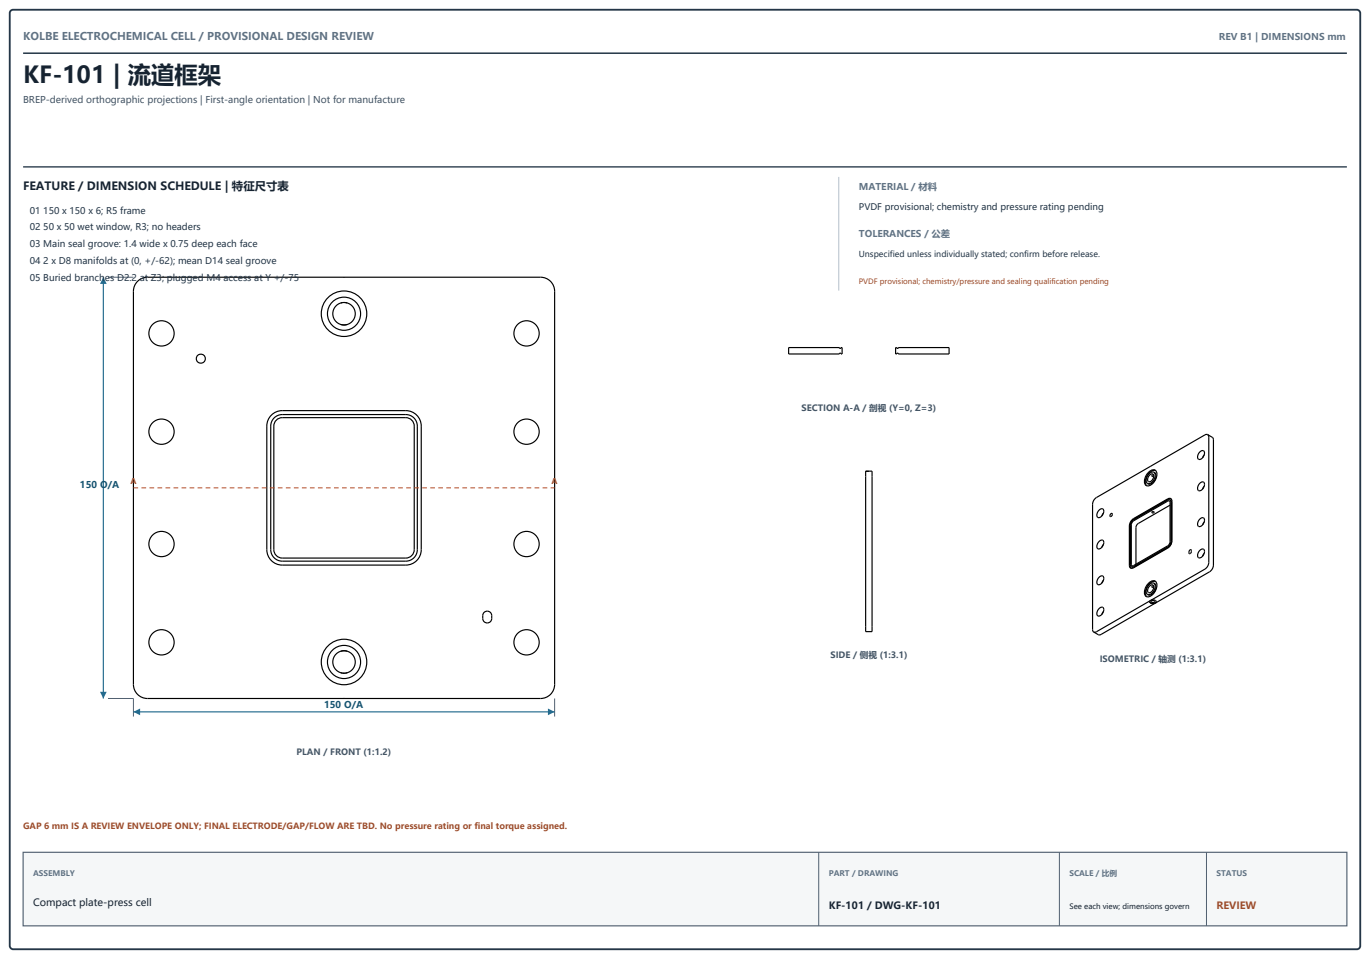
[picture p92: page 9]
KOLBE ELECTROCHEMICAL CELL / PROVISIONAL DESIGN REVIEW; REV B1 | DIMENSIONS mm; PLAN / FRONT (1:1.2); SIDE / 侧视 (1:3.1); ISOMETRIC / 轴测 (1:3.1); SECTION A-A / 剖视 (Y=0, Z=3); TOLERANCES / 公差; ASSEMBLY; PART / DRAWING; SCALE / 比例; STATUS

BREP-derived orthographic projections | First-angle orientation | Not for manufacture

MATERIAL / 材料
PVDF provisional; chemistry and pressure rating pending

01 150 x 150 x 6; R5 frame
02 50 x 50 wet window, R3; no headers
03 Main seal groove: 1.4 wide x 0.75 deep each face
04 2 x D8 manifolds at (0, +/-62); mean D14 seal groove
05 Buried branches D2.2 at Z3; plugged M4 access at Y +/-75

Unspecified unless individually stated; confirm before release.

PVDF provisional; chemistry/pressure and sealing qualification pending

GAP 6 mm IS A REVIEW ENVELOPE ONLY; FINAL ELECTRODE/GAP/FLOW ARE TBD. No pressure rating or final torque assigned.

Compact plate-press cell

KF-101 / DWG-KF-101

See each view; dimensions govern

# KP-101 | A向正极箔片

### FEATURE / DIMENSION SCHEDULE | 特征尺寸表

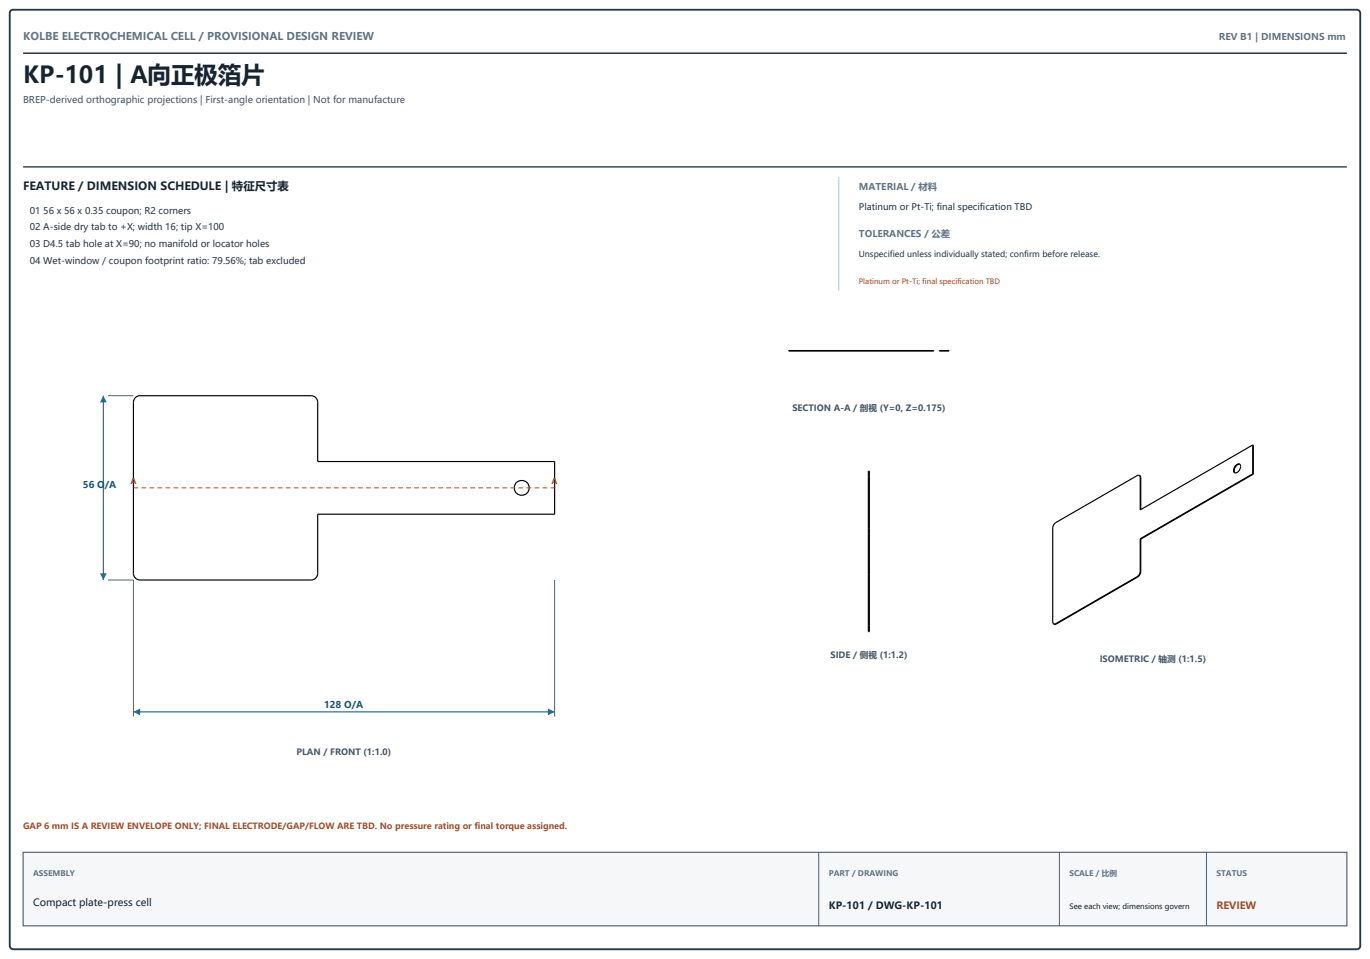
[picture p93: page 10]
PLAN / FRONT (1:1.0); SIDE / 侧视 (1:1.2); ISOMETRIC / 轴测 (1:1.5); SECTION A-A / 剖视 (Y=0, Z=0.175); TOLERANCES / 公差; ASSEMBLY; PART / DRAWING; SCALE / 比例; STATUS

BREP-derived orthographic projections | First-angle orientation | Not for manufacture

MATERIAL / 材料
Platinum or Pt-Ti; final specification TBD

01 56 x 56 x 0.35 coupon; R2 corners
02 A-side dry tab to +X; width 16; tip X=100
03 D4.5 tab hole at X=90; no manifold or locator holes
04 Wet-window / coupon footprint ratio: 79.56%; tab excluded

Unspecified unless individually stated; confirm before release.

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

KP-101 / DWG-KP-101

# KP-102 | C向负极箔片

### FEATURE / DIMENSION SCHEDULE | 特征尺寸表

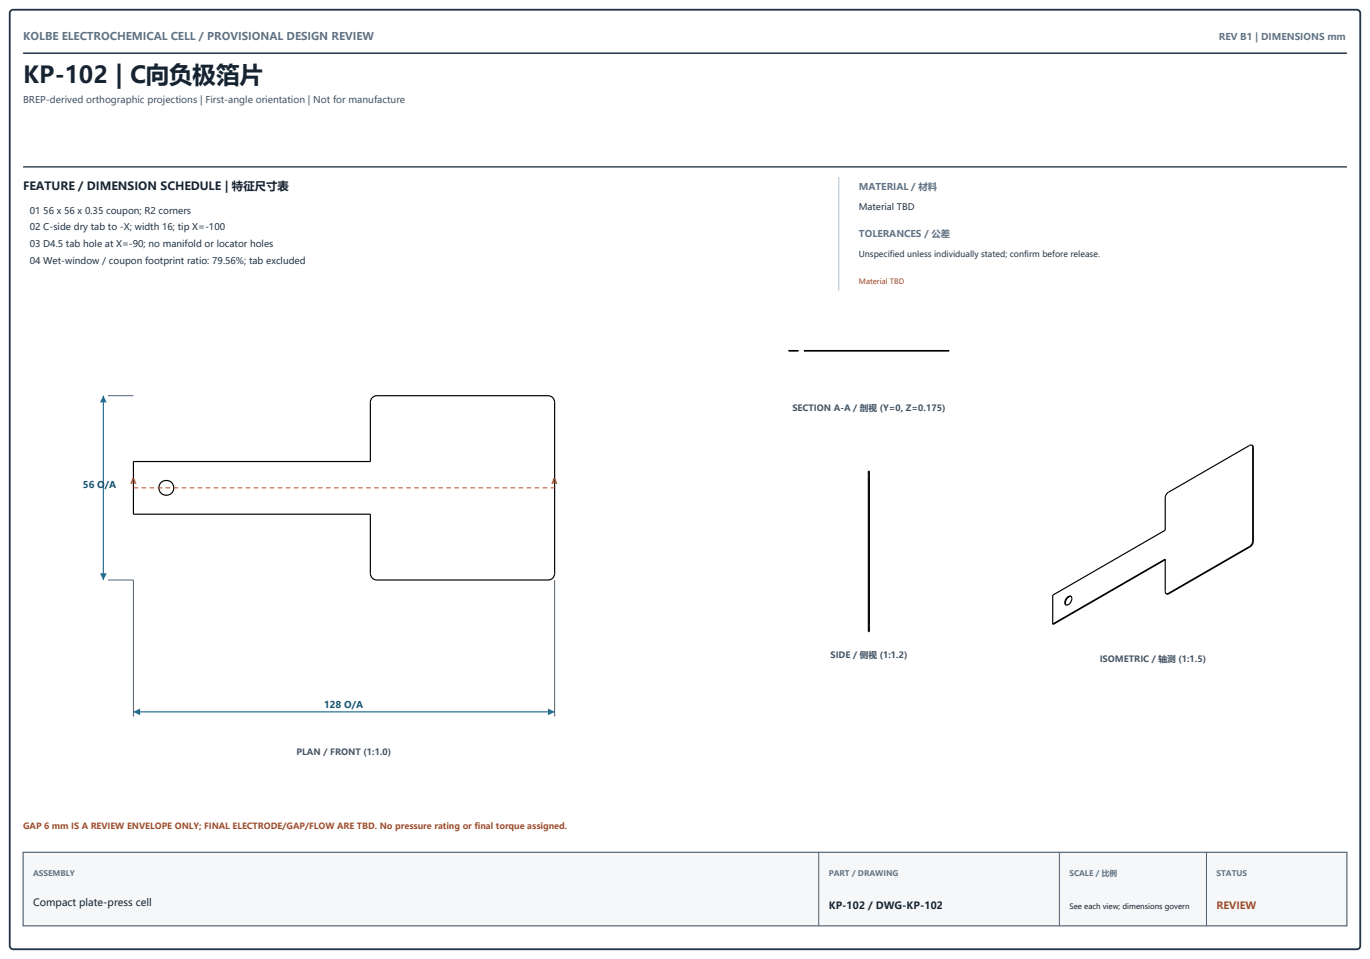
[picture p94: page 11]
PLAN / FRONT (1:1.0); SIDE / 侧视 (1:1.2); ISOMETRIC / 轴测 (1:1.5); SECTION A-A / 剖视 (Y=0, Z=0.175); MATERIAL / 材料; Material TBD; TOLERANCES / 公差; ASSEMBLY; PART / DRAWING; SCALE / 比例; STATUS

BREP-derived orthographic projections | First-angle orientation | Not for manufacture

01 56 x 56 x 0.35 coupon; R2 corners
02 C-side dry tab to -X; width 16; tip X=-100
03 D4.5 tab hole at X=-90; no manifold or locator holes
04 Wet-window / coupon footprint ratio: 79.56%; tab excluded

Unspecified unless individually stated; confirm before release.

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

KP-102 / DWG-KP-102

# KP-201 | 前端板

### FEATURE / DIMENSION SCHEDULE | 特征尺寸表

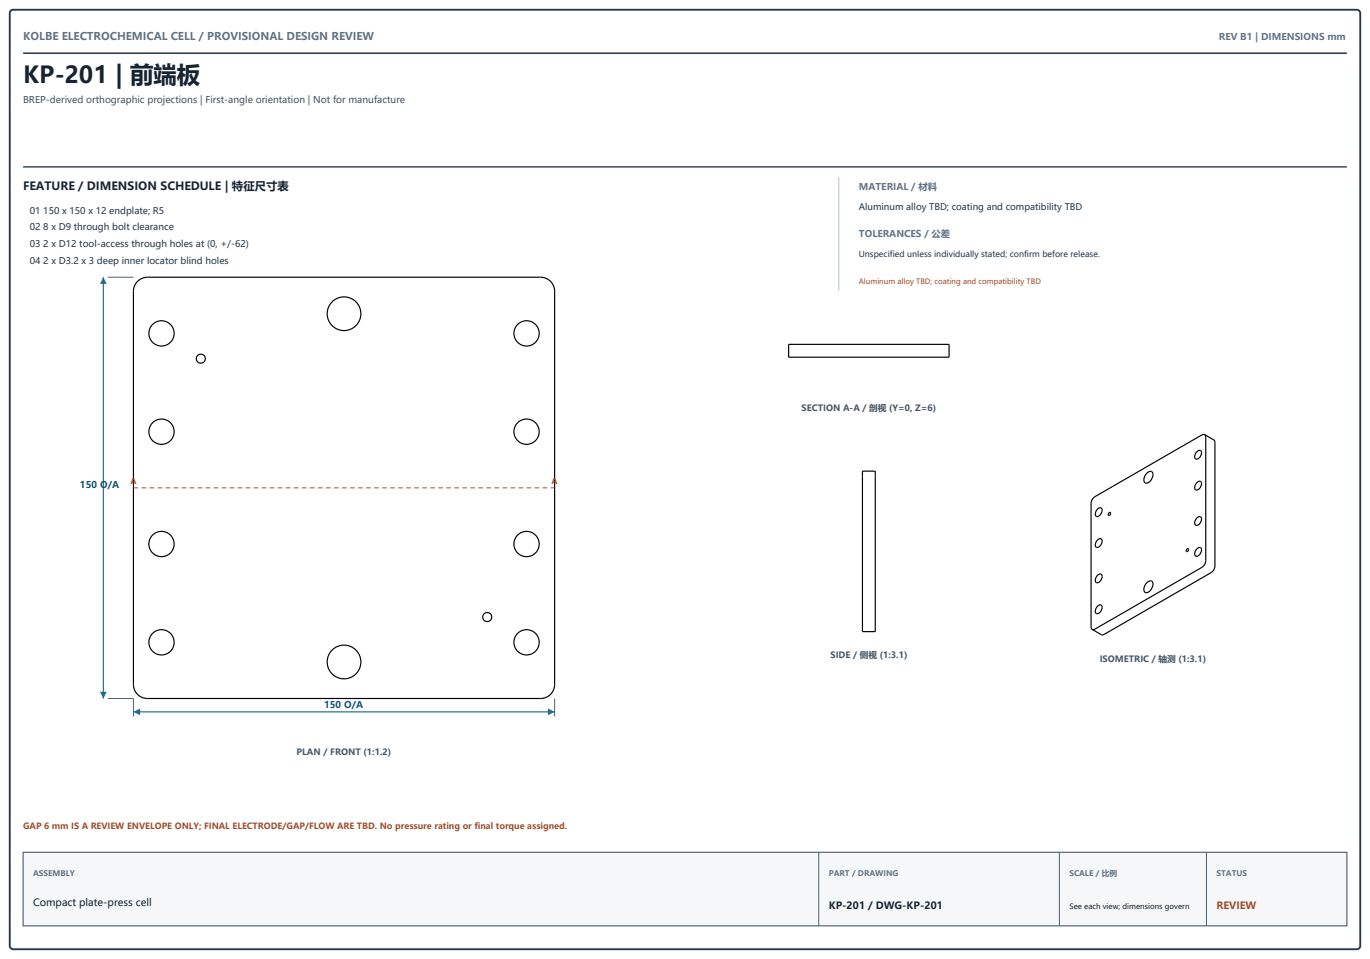
[picture p95: page 12]
PLAN / FRONT (1:1.2); SIDE / 侧视 (1:3.1); ISOMETRIC / 轴测 (1:3.1); SECTION A-A / 剖视 (Y=0, Z=6); TOLERANCES / 公差; ASSEMBLY; PART / DRAWING; SCALE / 比例; STATUS

BREP-derived orthographic projections | First-angle orientation | Not for manufacture

MATERIAL / 材料
Aluminum alloy TBD; coating and compatibility TBD

01 150 x 150 x 12 endplate; R5
02 8 x D9 through bolt clearance
03 2 x D12 tool-access through holes at (0, +/-62)
04 2 x D3.2 x 3 deep inner locator blind holes

Unspecified unless individually stated; confirm before release.

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

KP-201 / DWG-KP-201

# KP-202 | 前绝缘板

### FEATURE / DIMENSION SCHEDULE | 特征尺寸表

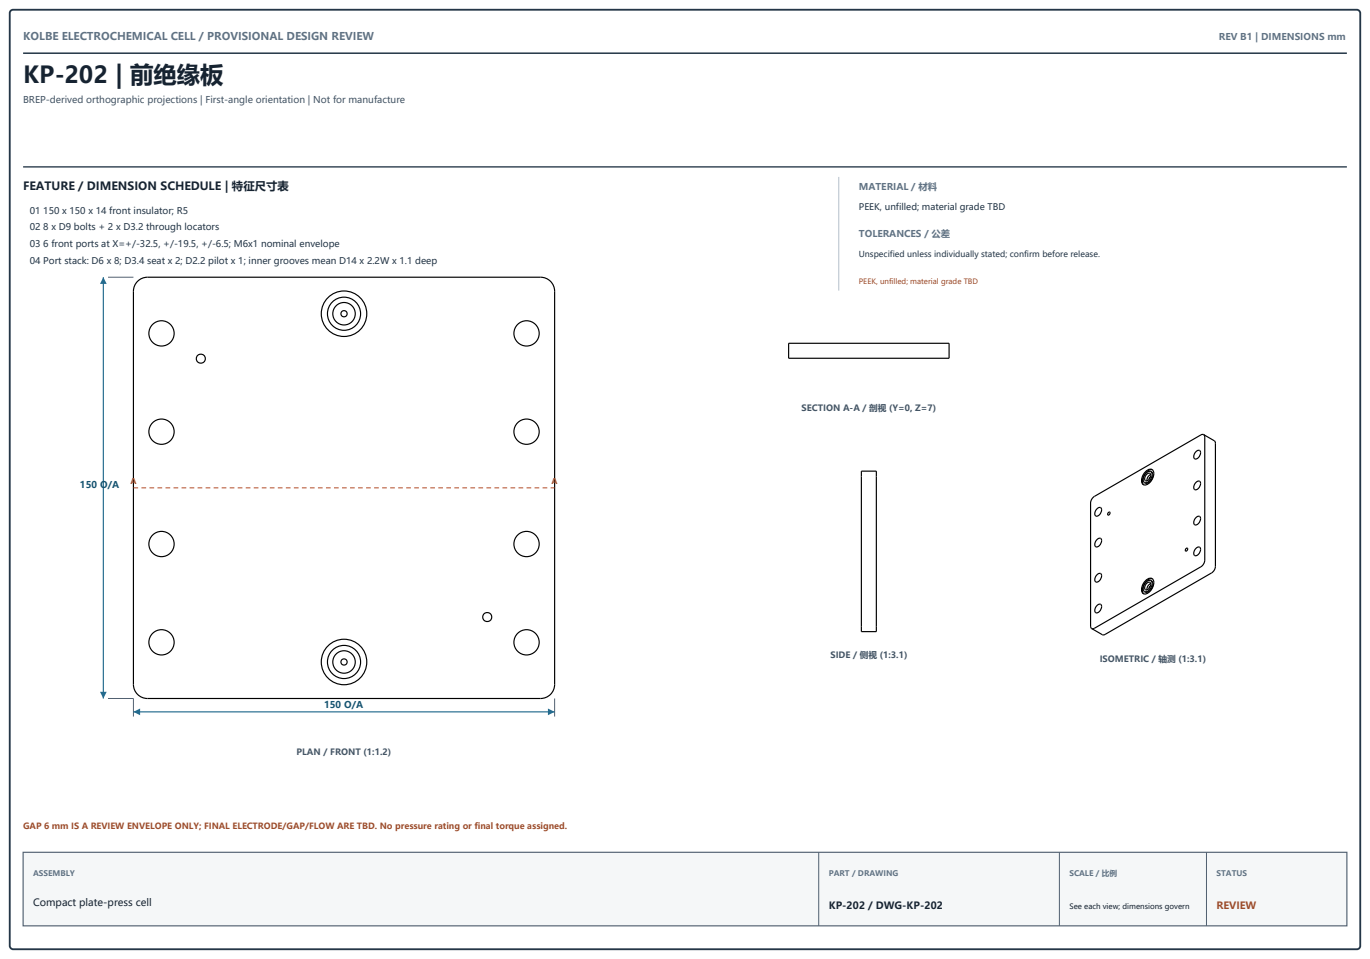
[picture p96: page 13]
PLAN / FRONT (1:1.2); SIDE / 侧视 (1:3.1); ISOMETRIC / 轴测 (1:3.1); SECTION A-A / 剖视 (Y=0, Z=7); TOLERANCES / 公差; ASSEMBLY; PART / DRAWING; SCALE / 比例; STATUS

BREP-derived orthographic projections | First-angle orientation | Not for manufacture

MATERIAL / 材料
PEEK, unfilled; material grade TBD

01 150 x 150 x 14 front insulator; R5
02 8 x D9 bolts + 2 x D3.2 through locators
03 6 front ports at X=+/-32.5, +/-19.5, +/-6.5; M6x1 nominal envelope
04 Port stack: D6 x 8; D3.4 seat x 2; D2.2 pilot x 1; inner grooves mean D14 x 2.2W x 1.1 deep

Unspecified unless individually stated; confirm before release.

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

KP-202 / DWG-KP-202

# KP-203 | 后绝缘板

### FEATURE / DIMENSION SCHEDULE | 特征尺寸表

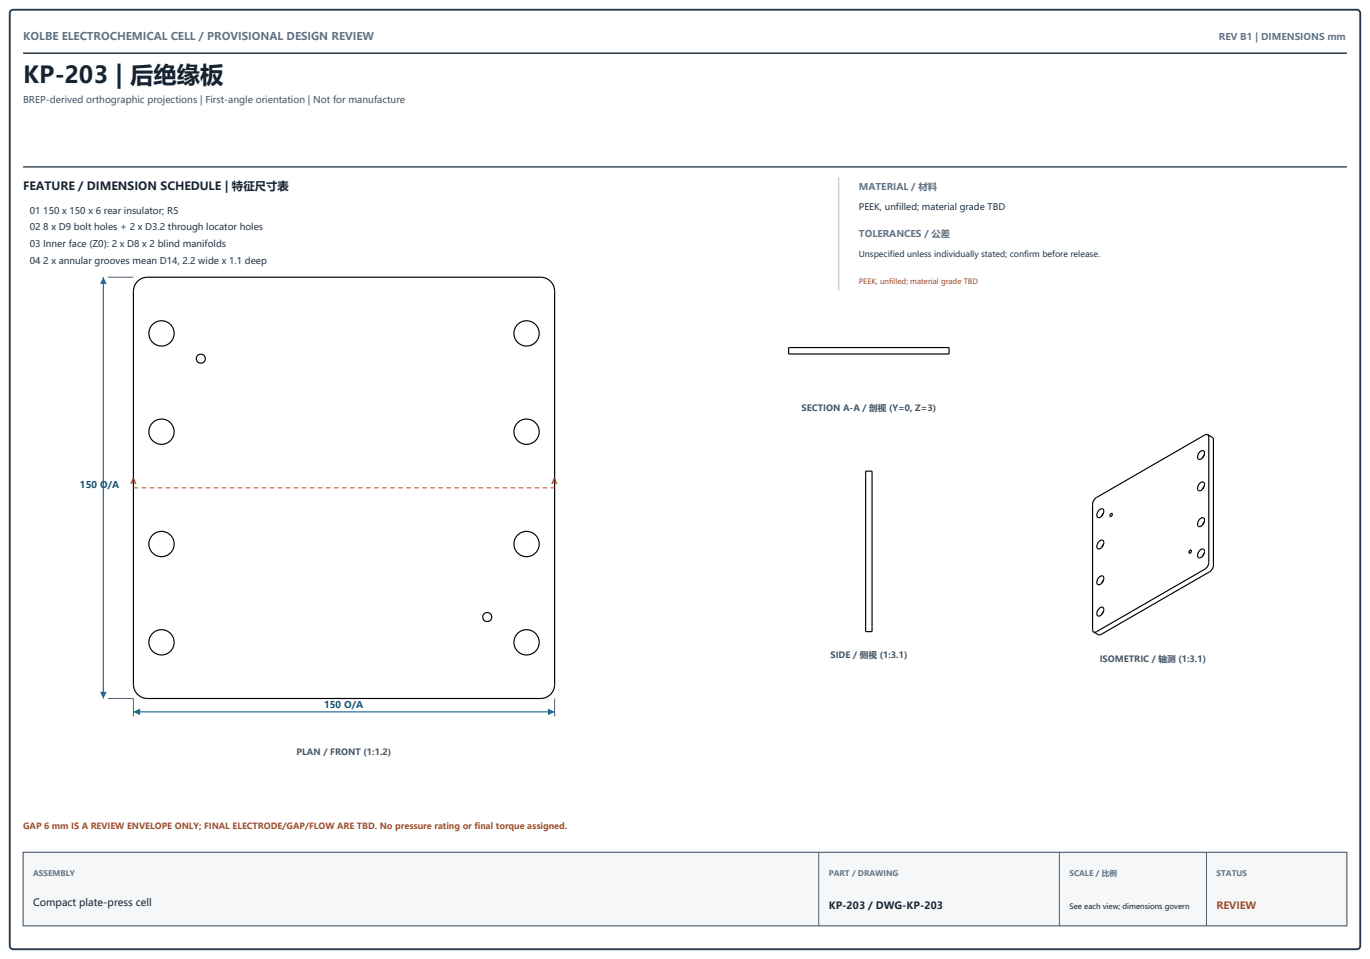
[picture p97: page 14]
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

BREP-derived orthographic projections | First-angle orientation | Not for manufacture

MATERIAL / 材料
PEEK, unfilled; material grade TBD

01 150 x 150 x 6 rear insulator; R5
02 8 x D9 bolt holes + 2 x D3.2 through locator holes
03 Inner face (Z0): 2 x D8 x 2 blind manifolds
04 2 x annular grooves mean D14, 2.2 wide x 1.1 deep

Unspecified unless individually stated; confirm before release.

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

KP-203 / DWG-KP-203

# KP-204 | 后端板

### FEATURE / DIMENSION SCHEDULE | 特征尺寸表

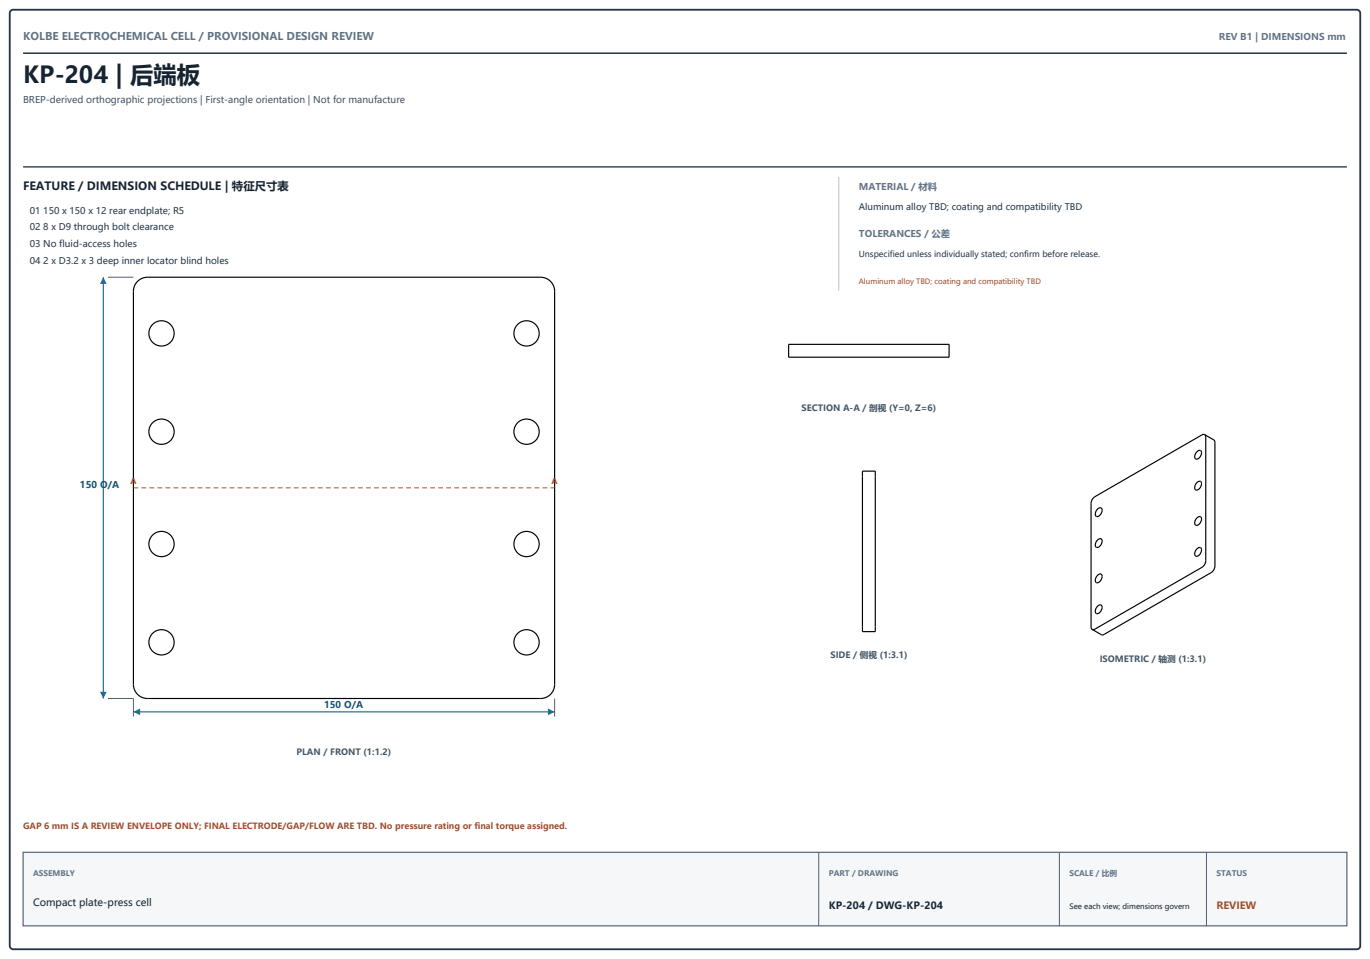
[picture p98: page 15]
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

BREP-derived orthographic projections | First-angle orientation | Not for manufacture

MATERIAL / 材料
Aluminum alloy TBD; coating and compatibility TBD

01 150 x 150 x 12 rear endplate; R5
02 8 x D9 through bolt clearance
03 No fluid-access holes
04 2 x D3.2 x 3 deep inner locator blind holes

Unspecified unless individually stated; confirm before release.

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

KP-204 / DWG-KP-204

# KP-601 | A侧电极载体膜

### FEATURE / DIMENSION SCHEDULE | 特征尺寸表

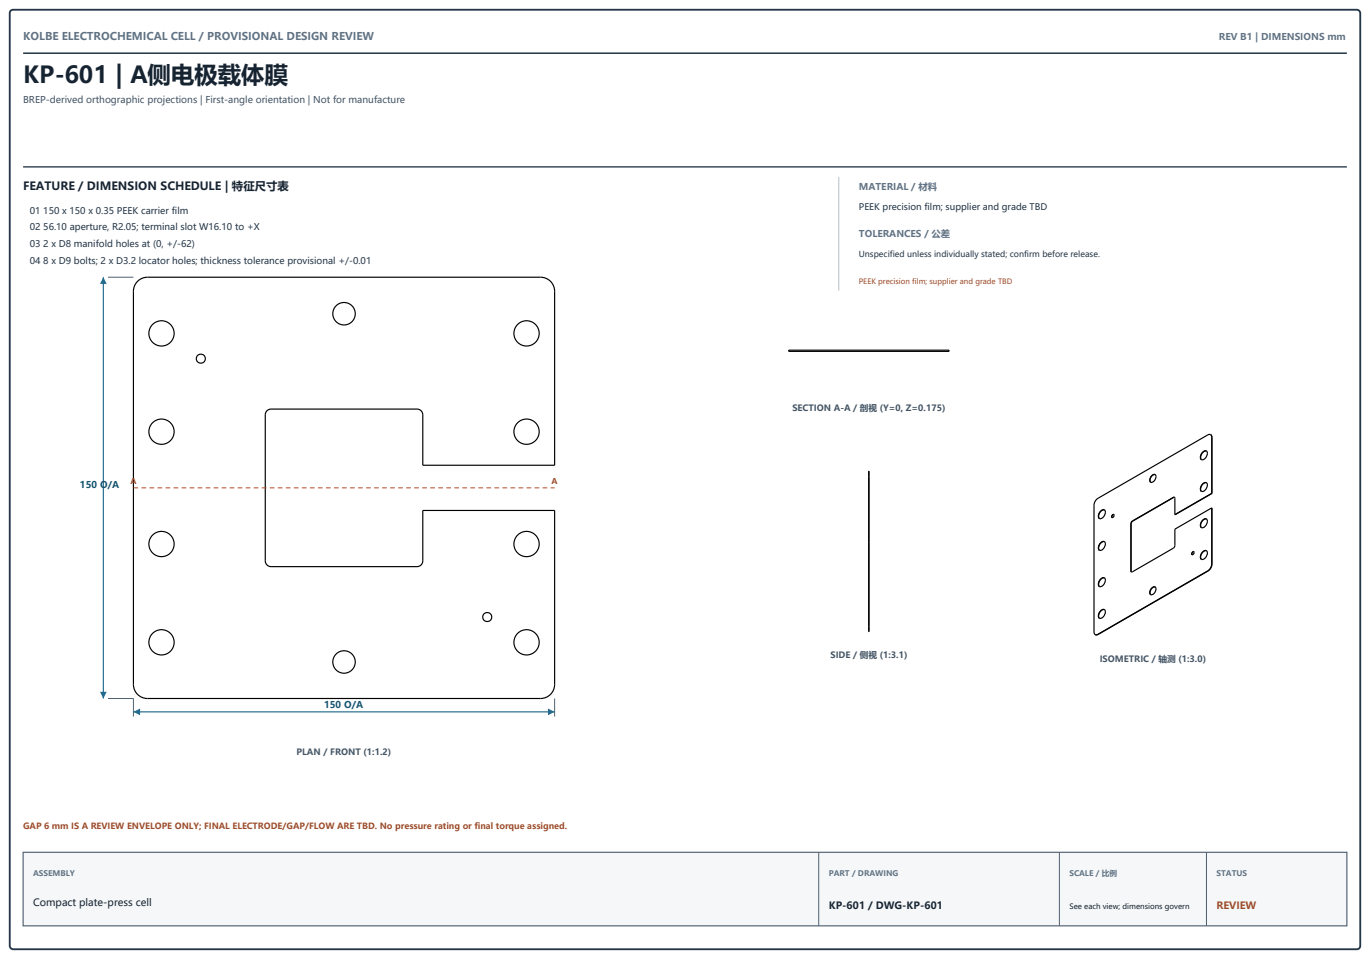
[picture p99: page 16]
PLAN / FRONT (1:1.2); SIDE / 侧视 (1:3.1); ISOMETRIC / 轴测 (1:3.0); SECTION A-A / 剖视 (Y=0, Z=0.175); TOLERANCES / 公差; ASSEMBLY; PART / DRAWING; SCALE / 比例; STATUS

BREP-derived orthographic projections | First-angle orientation | Not for manufacture

MATERIAL / 材料
PEEK precision film; supplier and grade TBD

01 150 x 150 x 0.35 PEEK carrier film
02 56.10 aperture, R2.05; terminal slot W16.10 to +X
03 2 x D8 manifold holes at (0, +/-62)
04 8 x D9 bolts; 2 x D3.2 locator holes; thickness tolerance provisional +/-0.01

Unspecified unless individually stated; confirm before release.

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

KP-601 / DWG-KP-601

# KP-602 | C侧电极载体膜

### FEATURE / DIMENSION SCHEDULE | 特征尺寸表

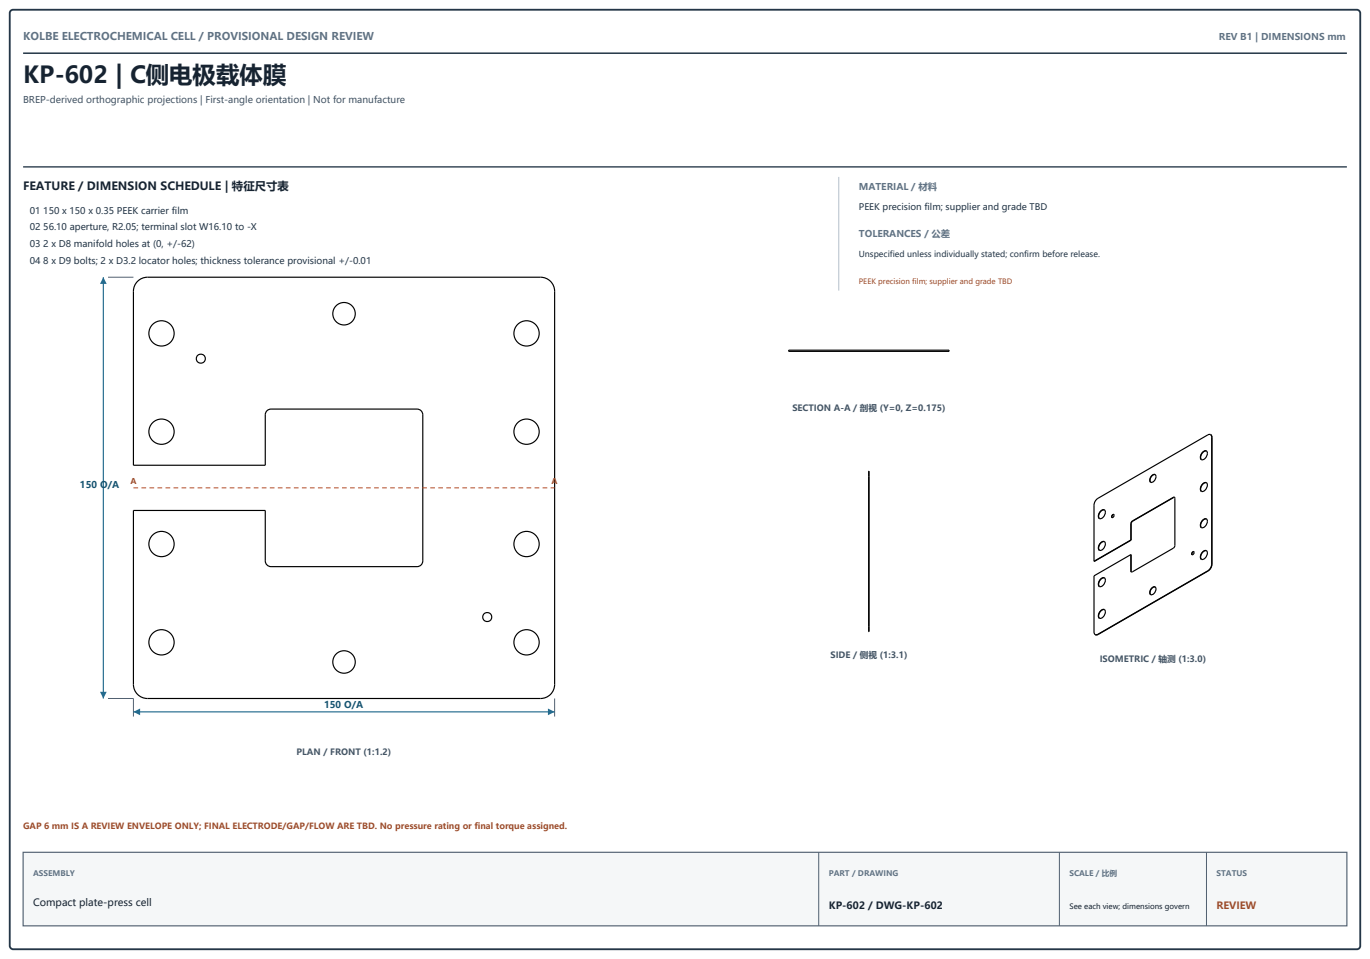
[picture p100: page 17]
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

BREP-derived orthographic projections | First-angle orientation | Not for manufacture

MATERIAL / 材料
PEEK precision film; supplier and grade TBD

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

Unspecified unless individually stated; confirm before release.

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

KP-602 / DWG-KP-602

# KP-301 | 夹紧爪

### FEATURE / DIMENSION SCHEDULE | 特征尺寸表

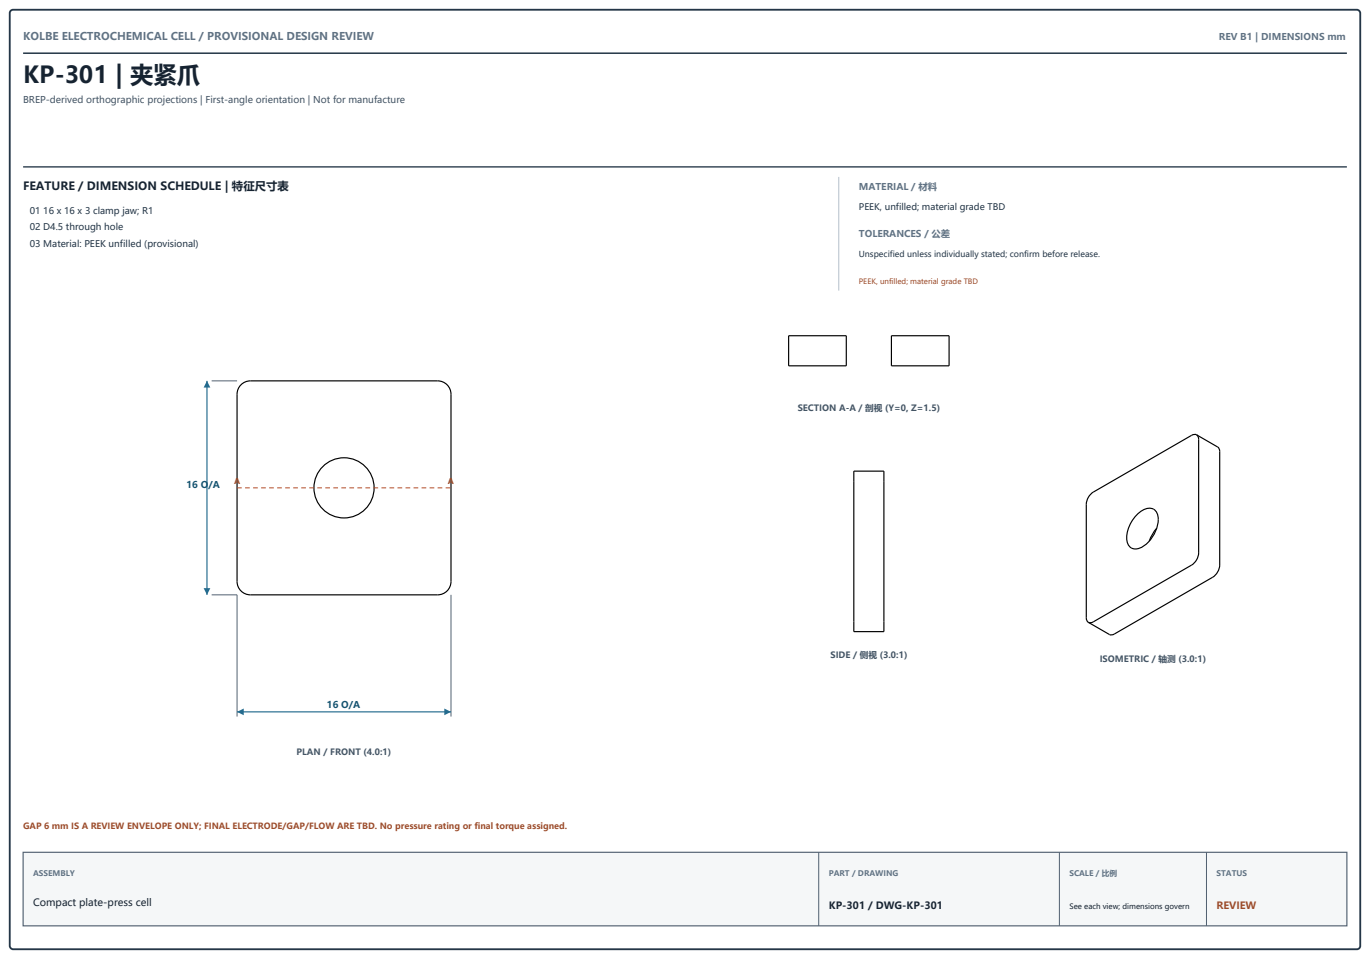
[picture p101: page 18]
PLAN / FRONT (4.0:1); SIDE / 侧视 (3.0:1); ISOMETRIC / 轴测 (3.0:1); SECTION A-A / 剖视 (Y=0, Z=1.5); TOLERANCES / 公差; ASSEMBLY; PART / DRAWING; SCALE / 比例; STATUS

BREP-derived orthographic projections | First-angle orientation | Not for manufacture

MATERIAL / 材料
PEEK, unfilled; material grade TBD

01 16 x 16 x 3 clamp jaw; R1
02 D4.5 through hole
03 Material: PEEK unfilled (provisional)

Unspecified unless individually stated; confirm before release.

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

KP-301 / DWG-KP-301

# KP-501 | 流体接头

### FEATURE / DIMENSION SCHEDULE | 特征尺寸表

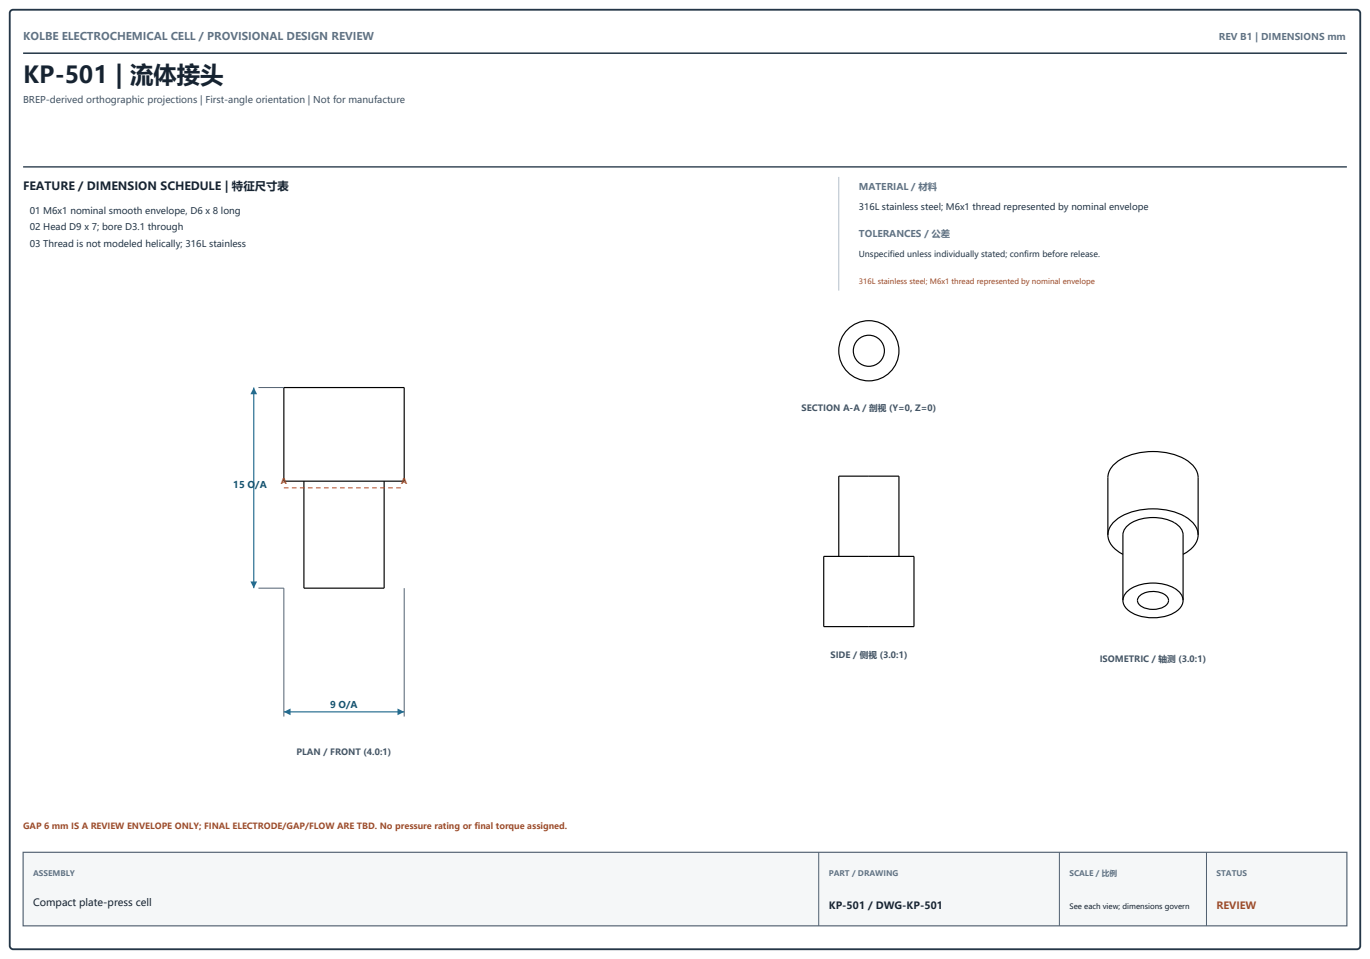
[picture p102: page 19]
PLAN / FRONT (4.0:1); SIDE / 侧视 (3.0:1); ISOMETRIC / 轴测 (3.0:1); SECTION A-A / 剖视 (Y=0, Z=0); TOLERANCES / 公差; ASSEMBLY; PART / DRAWING; SCALE / 比例; STATUS

BREP-derived orthographic projections | First-angle orientation | Not for manufacture

MATERIAL / 材料
316L stainless steel; M6x1 thread represented by nominal envelope

01 M6x1 nominal smooth envelope, D6 x 8 long
02 Head D9 x 7; bore D3.1 through
03 Thread is not modeled helically; 316L stainless

Unspecified unless individually stated; confirm before release.

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

KP-501 / DWG-KP-501

# KP-502 | 压缩密封圈

### FEATURE / DIMENSION SCHEDULE | 特征尺寸表

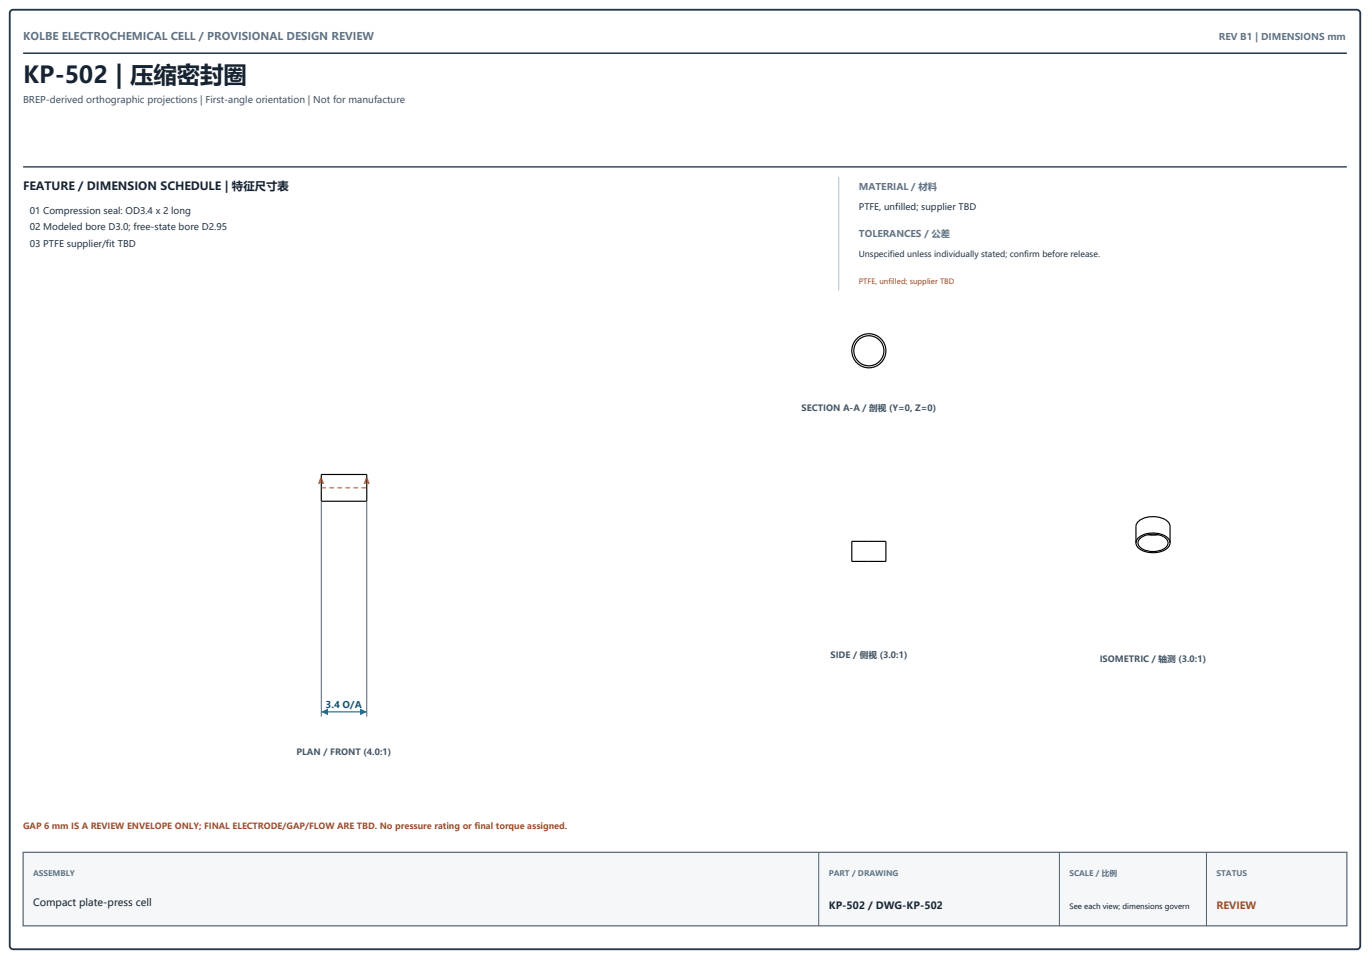
[picture p103: page 20]
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

BREP-derived orthographic projections | First-angle orientation | Not for manufacture

MATERIAL / 材料
PTFE, unfilled; supplier TBD

01 Compression seal: OD3.4 x 2 long
02 Modeled bore D3.0; free-state bore D2.95
03 PTFE supplier/fit TBD

Unspecified unless individually stated; confirm before release.

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

KP-502 / DWG-KP-502

# KP-503 | PTFE管

### FEATURE / DIMENSION SCHEDULE | 特征尺寸表

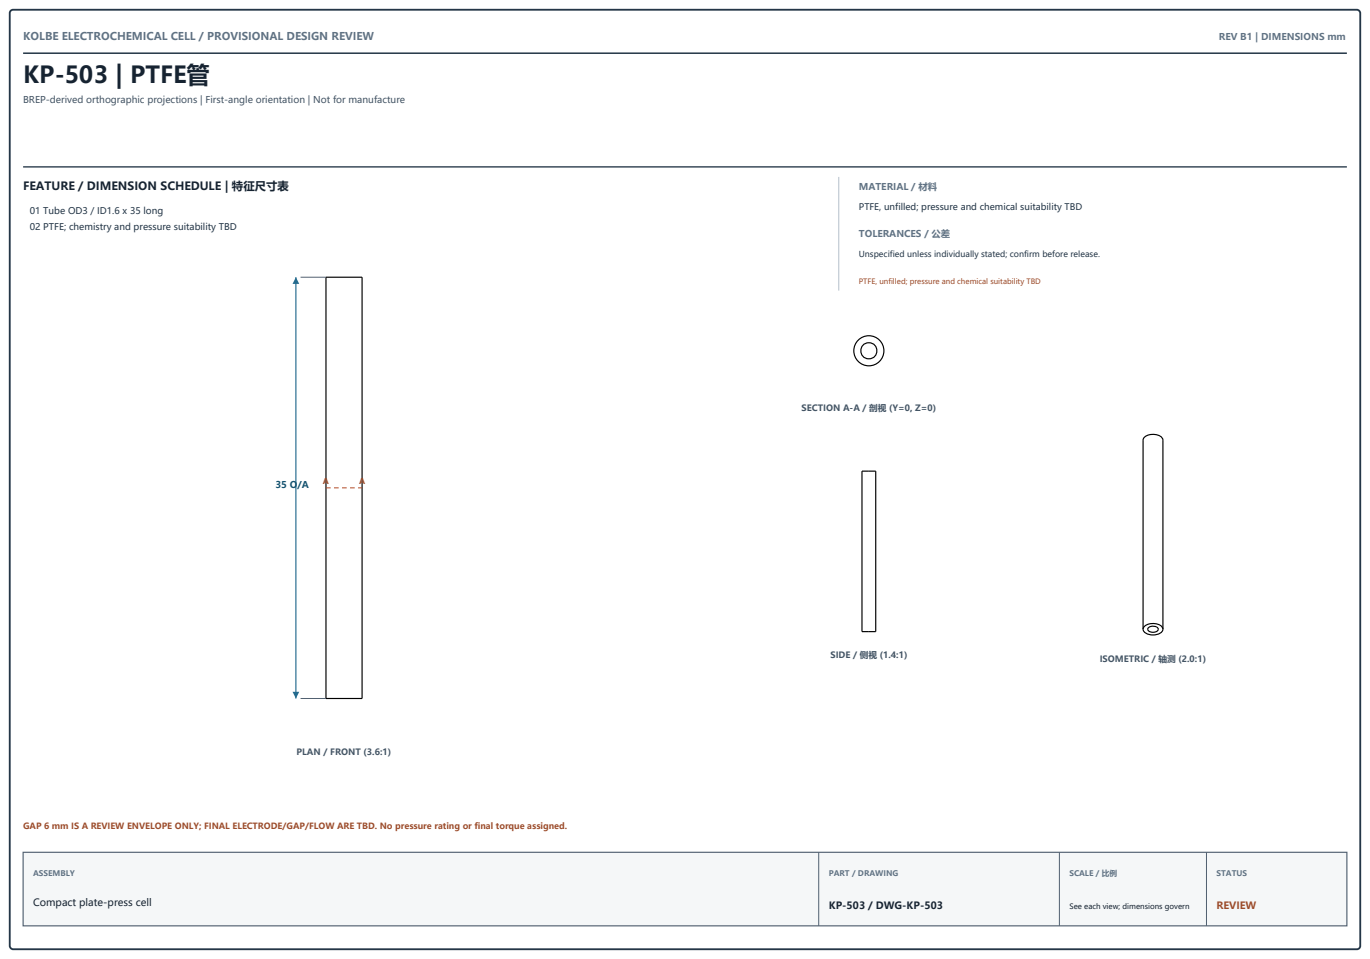
[picture p104: page 21]
PLAN / FRONT (3.6:1); SIDE / 侧视 (1.4:1); ISOMETRIC / 轴测 (2.0:1); SECTION A-A / 剖视 (Y=0, Z=0); TOLERANCES / 公差; ASSEMBLY; PART / DRAWING; SCALE / 比例; STATUS

BREP-derived orthographic projections | First-angle orientation | Not for manufacture

MATERIAL / 材料
PTFE, unfilled; pressure and chemical suitability TBD

01 Tube OD3 / ID1.6 x 35 long
02 PTFE; chemistry and pressure suitability TBD

Unspecified unless individually stated; confirm before release.

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

KP-503 / DWG-KP-503

# KB-A3 | A向三层铜梳排

### FEATURE / DIMENSION SCHEDULE | 特征尺寸表

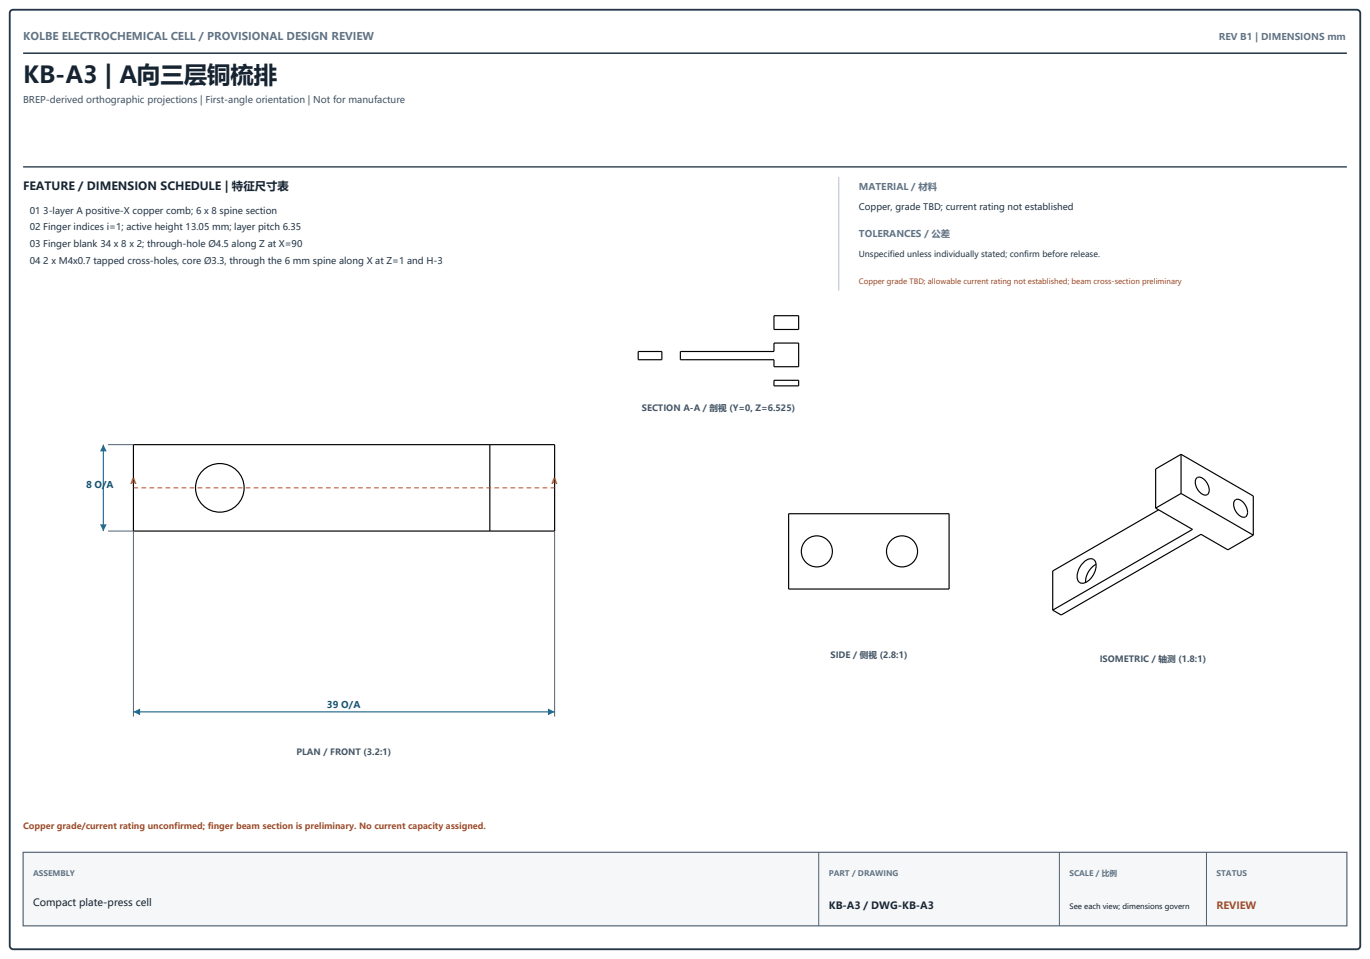
[picture p105: page 22]
PLAN / FRONT (3.2:1); SIDE / 侧视 (2.8:1); ISOMETRIC / 轴测 (1.8:1); SECTION A-A / 剖视 (Y=0, Z=6.525); TOLERANCES / 公差; ASSEMBLY; PART / DRAWING; SCALE / 比例; STATUS

BREP-derived orthographic projections | First-angle orientation | Not for manufacture

MATERIAL / 材料
Copper, grade TBD; current rating not established

01 3-layer A positive-X copper comb; 6 x 8 spine section
02 Finger indices i=1; active height 13.05 mm; layer pitch 6.35
03 Finger blank 34 x 8 x 2; through-hole Ø4.5 along Z at X=90
04 2 x M4x0.7 tapped cross-holes, core Ø3.3, through the 6 mm spine along X at Z=1 and H-3

Unspecified unless individually stated; confirm before release.

Copper grade TBD; allowable current rating not established; beam cross-section preliminary

Copper grade/current rating unconfirmed; finger beam section is preliminary. No current capacity assigned.

KB-A3 / DWG-KB-A3

# KB-C3 | C向三层铜梳排

### FEATURE / DIMENSION SCHEDULE | 特征尺寸表

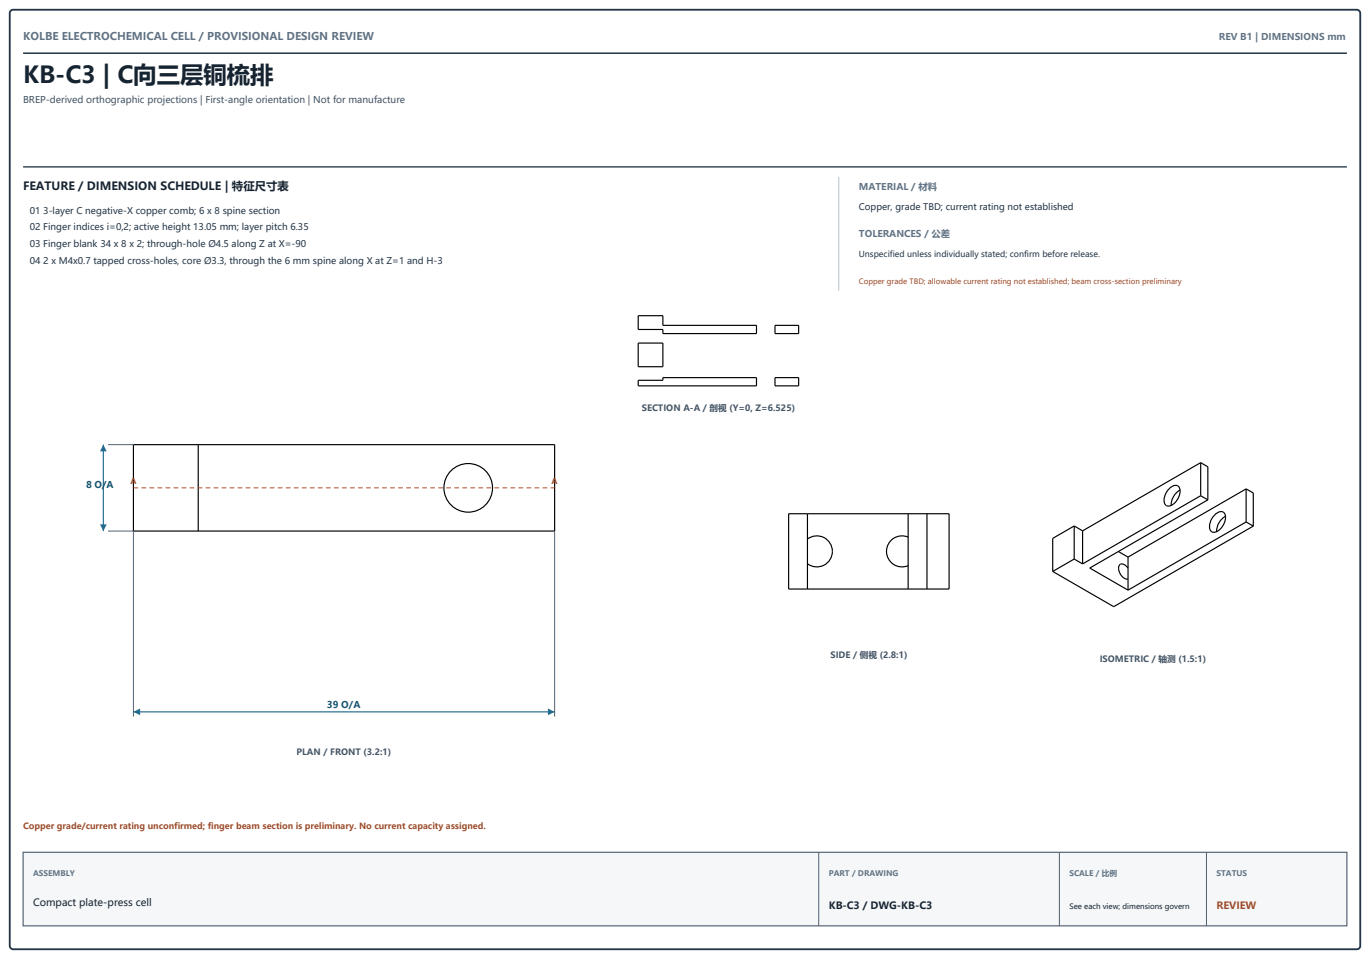
[picture p106: page 23]
PLAN / FRONT (3.2:1); SIDE / 侧视 (2.8:1); ISOMETRIC / 轴测 (1.5:1); SECTION A-A / 剖视 (Y=0, Z=6.525); TOLERANCES / 公差; ASSEMBLY; PART / DRAWING; SCALE / 比例; STATUS

BREP-derived orthographic projections | First-angle orientation | Not for manufacture

MATERIAL / 材料
Copper, grade TBD; current rating not established

01 3-layer C negative-X copper comb; 6 x 8 spine section
02 Finger indices i=0,2; active height 13.05 mm; layer pitch 6.35
03 Finger blank 34 x 8 x 2; through-hole Ø4.5 along Z at X=-90
04 2 x M4x0.7 tapped cross-holes, core Ø3.3, through the 6 mm spine along X at Z=1 and H-3

Unspecified unless individually stated; confirm before release.

Copper grade TBD; allowable current rating not established; beam cross-section preliminary

Copper grade/current rating unconfirmed; finger beam section is preliminary. No current capacity assigned.

KB-C3 / DWG-KB-C3

# KB-A5 | A向五层铜梳排

### FEATURE / DIMENSION SCHEDULE | 特征尺寸表

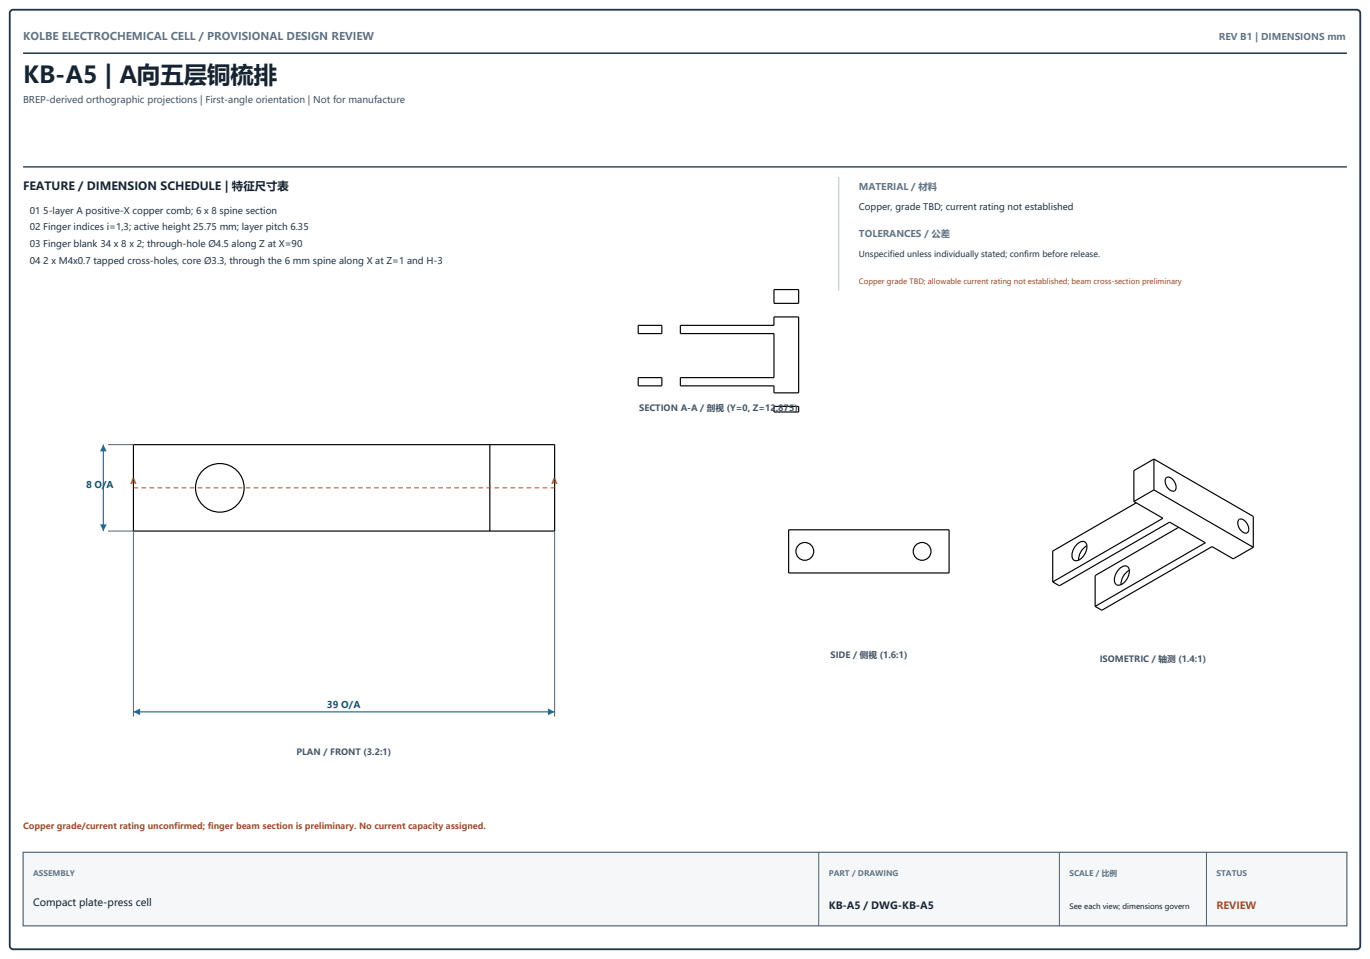
[picture p107: page 24]
PLAN / FRONT (3.2:1); SIDE / 侧视 (1.6:1); ISOMETRIC / 轴测 (1.4:1); SECTION A-A / 剖视 (Y=0, Z=12.875); TOLERANCES / 公差; ASSEMBLY; PART / DRAWING; SCALE / 比例; STATUS

BREP-derived orthographic projections | First-angle orientation | Not for manufacture

MATERIAL / 材料
Copper, grade TBD; current rating not established

01 5-layer A positive-X copper comb; 6 x 8 spine section
02 Finger indices i=1,3; active height 25.75 mm; layer pitch 6.35
03 Finger blank 34 x 8 x 2; through-hole Ø4.5 along Z at X=90
04 2 x M4x0.7 tapped cross-holes, core Ø3.3, through the 6 mm spine along X at Z=1 and H-3

Unspecified unless individually stated; confirm before release.

Copper grade TBD; allowable current rating not established; beam cross-section preliminary

Copper grade/current rating unconfirmed; finger beam section is preliminary. No current capacity assigned.

KB-A5 / DWG-KB-A5

# KB-C5 | C向五层铜梳排

### FEATURE / DIMENSION SCHEDULE | 特征尺寸表

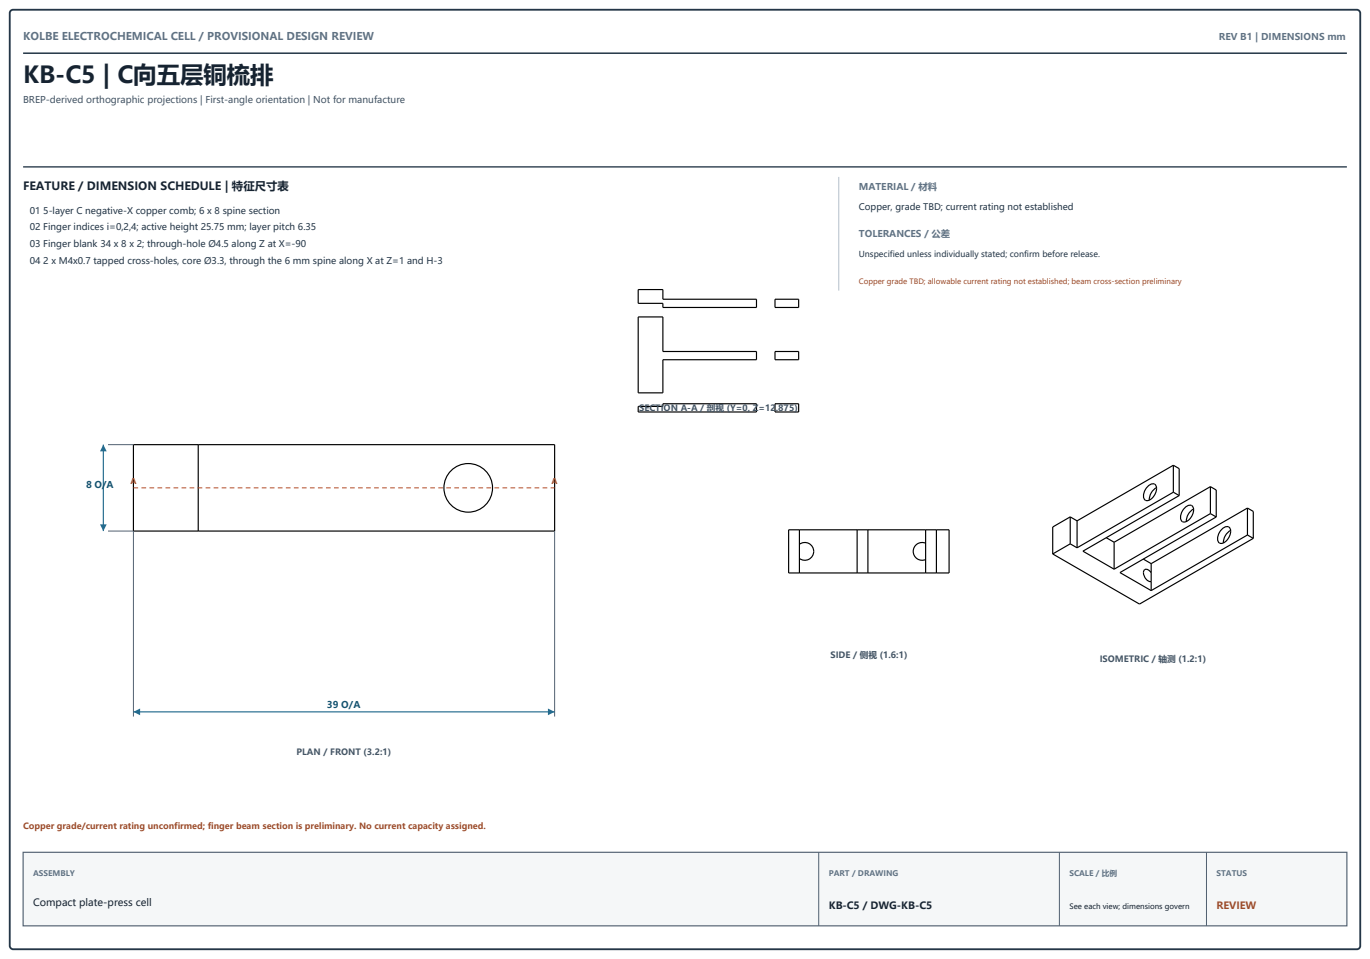
[picture p108: page 25]
PLAN / FRONT (3.2:1); SIDE / 侧视 (1.6:1); ISOMETRIC / 轴测 (1.2:1); SECTION A-A / 剖视 (Y=0, Z=12.875); TOLERANCES / 公差; ASSEMBLY; PART / DRAWING; SCALE / 比例; STATUS

BREP-derived orthographic projections | First-angle orientation | Not for manufacture

MATERIAL / 材料
Copper, grade TBD; current rating not established

01 5-layer C negative-X copper comb; 6 x 8 spine section
02 Finger indices i=0,2,4; active height 25.75 mm; layer pitch 6.35
03 Finger blank 34 x 8 x 2; through-hole Ø4.5 along Z at X=-90
04 2 x M4x0.7 tapped cross-holes, core Ø3.3, through the 6 mm spine along X at Z=1 and H-3

Unspecified unless individually stated; confirm before release.

Copper grade TBD; allowable current rating not established; beam cross-section preliminary

Copper grade/current rating unconfirmed; finger beam section is preliminary. No current capacity assigned.

KB-C5 / DWG-KB-C5

# KB-A7 | A向七层铜梳排

### FEATURE / DIMENSION SCHEDULE | 特征尺寸表

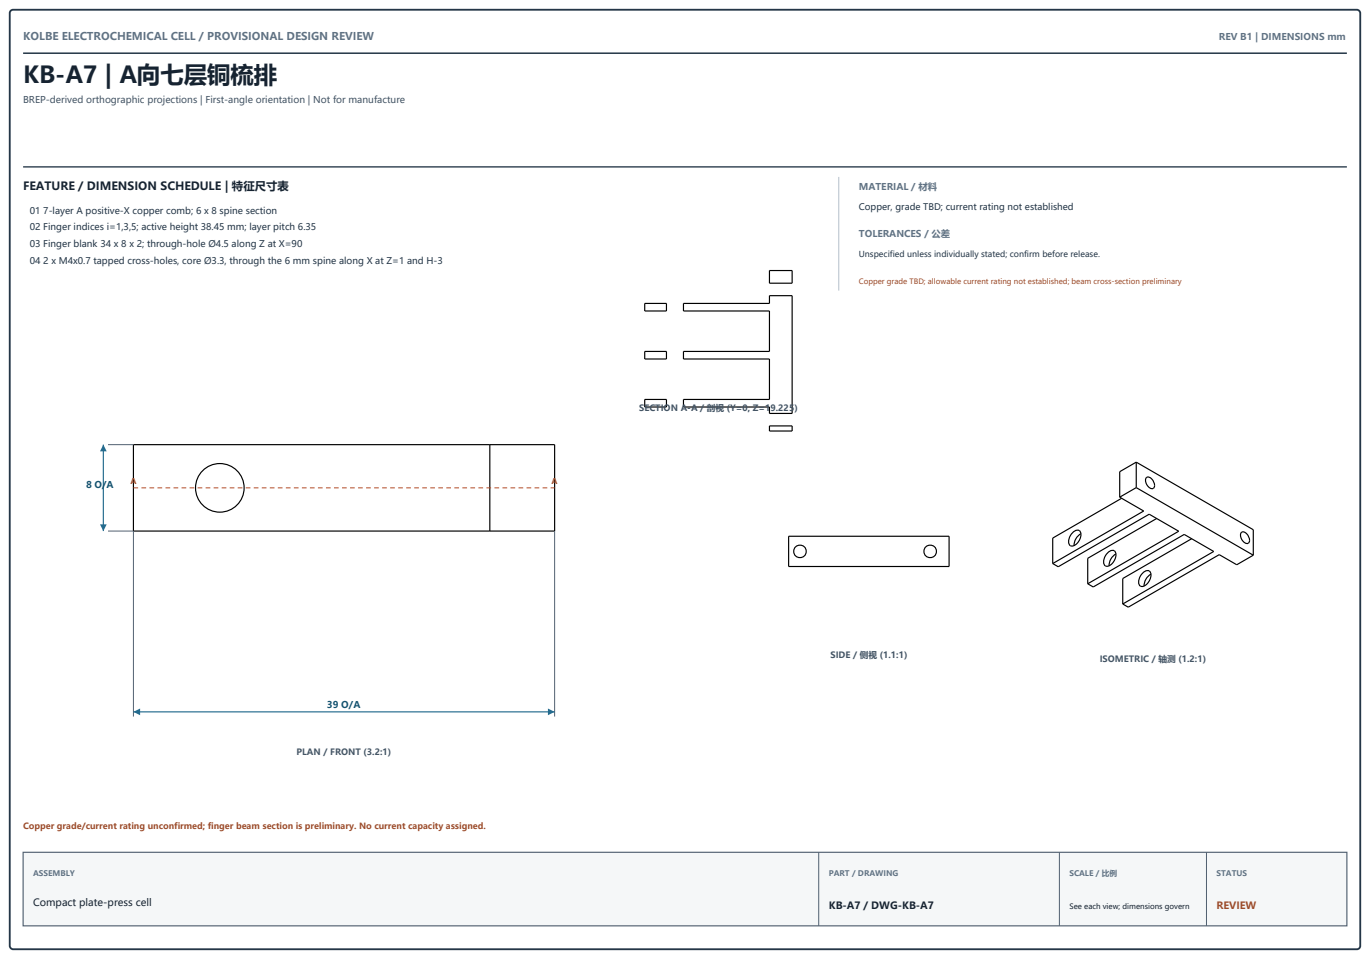
[picture p109: page 26]
PLAN / FRONT (3.2:1); SIDE / 侧视 (1.1:1); ISOMETRIC / 轴测 (1.2:1); SECTION A-A / 剖视 (Y=0, Z=19.225); TOLERANCES / 公差; ASSEMBLY; PART / DRAWING; SCALE / 比例; STATUS

BREP-derived orthographic projections | First-angle orientation | Not for manufacture

MATERIAL / 材料
Copper, grade TBD; current rating not established

01 7-layer A positive-X copper comb; 6 x 8 spine section
02 Finger indices i=1,3,5; active height 38.45 mm; layer pitch 6.35
03 Finger blank 34 x 8 x 2; through-hole Ø4.5 along Z at X=90
04 2 x M4x0.7 tapped cross-holes, core Ø3.3, through the 6 mm spine along X at Z=1 and H-3

Unspecified unless individually stated; confirm before release.

Copper grade TBD; allowable current rating not established; beam cross-section preliminary

Copper grade/current rating unconfirmed; finger beam section is preliminary. No current capacity assigned.

KB-A7 / DWG-KB-A7

# KB-C7 | C向七层铜梳排

### FEATURE / DIMENSION SCHEDULE | 特征尺寸表

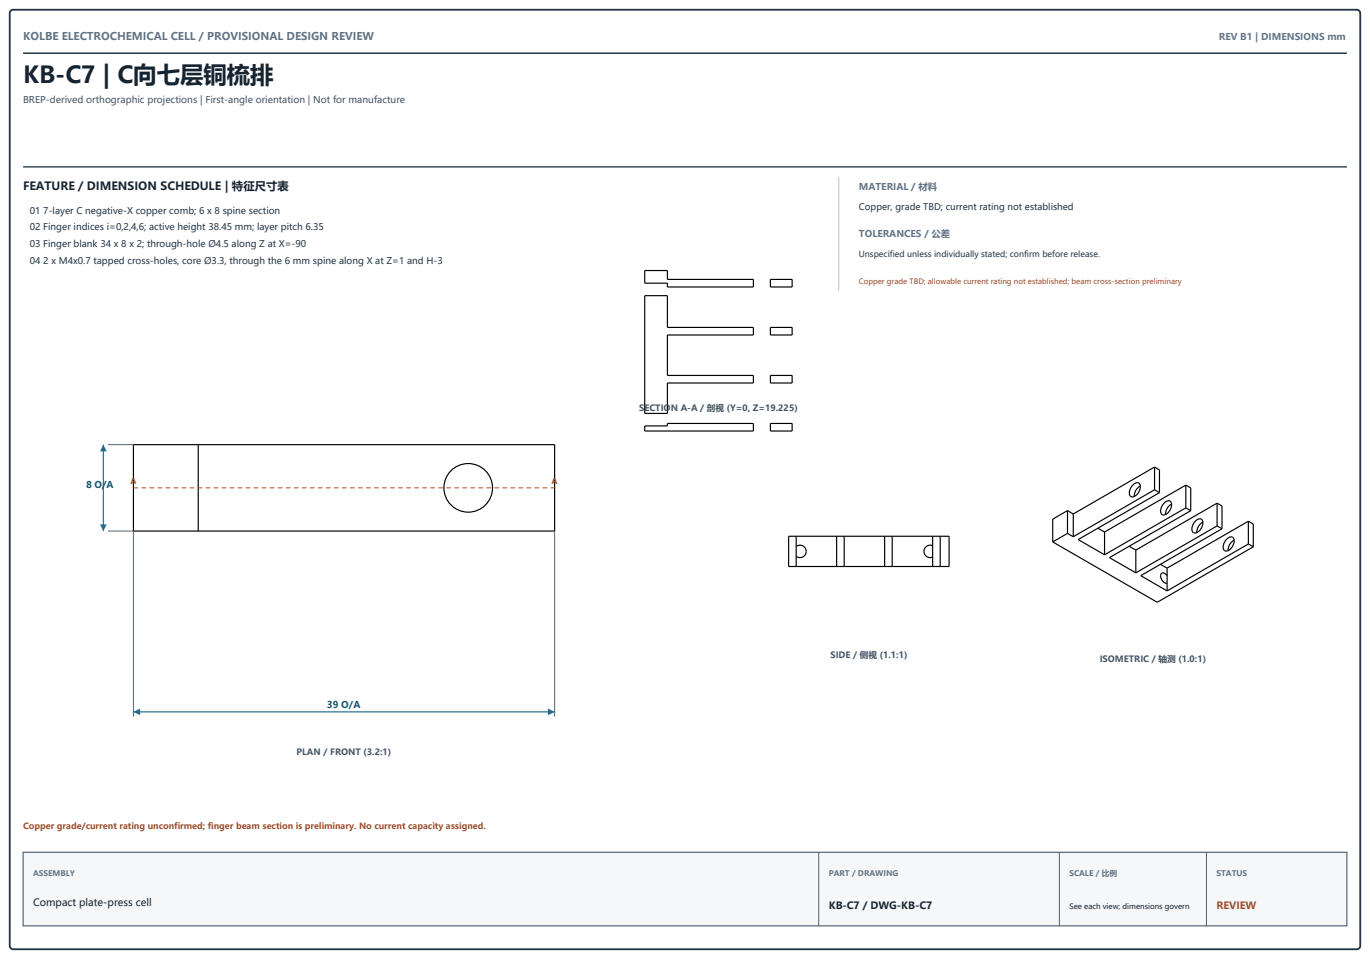
[picture p110: page 27]
PLAN / FRONT (3.2:1); SIDE / 侧视 (1.1:1); ISOMETRIC / 轴测 (1.0:1); SECTION A-A / 剖视 (Y=0, Z=19.225); TOLERANCES / 公差; ASSEMBLY; PART / DRAWING; SCALE / 比例; STATUS

BREP-derived orthographic projections | First-angle orientation | Not for manufacture

MATERIAL / 材料
Copper, grade TBD; current rating not established

01 7-layer C negative-X copper comb; 6 x 8 spine section
02 Finger indices i=0,2,4,6; active height 38.45 mm; layer pitch 6.35
03 Finger blank 34 x 8 x 2; through-hole Ø4.5 along Z at X=-90
04 2 x M4x0.7 tapped cross-holes, core Ø3.3, through the 6 mm spine along X at Z=1 and H-3

Unspecified unless individually stated; confirm before release.

Copper grade TBD; allowable current rating not established; beam cross-section preliminary

Copper grade/current rating unconfirmed; finger beam section is preliminary. No current capacity assigned.

KB-C7 / DWG-KB-C7

# KB-801 | 前PEEK支架

### FEATURE / DIMENSION SCHEDULE | 特征尺寸表

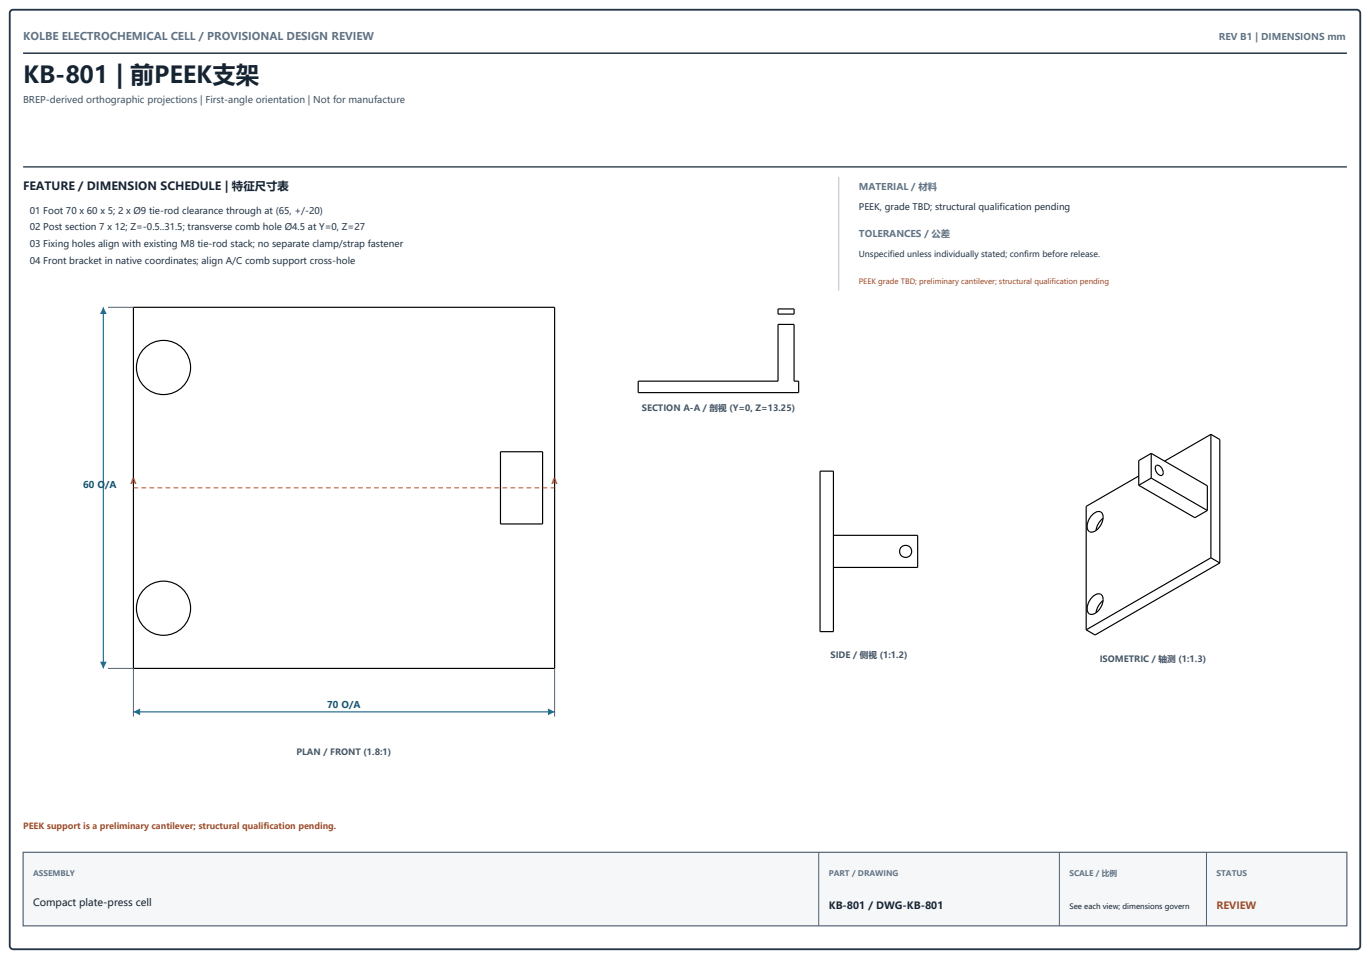
[picture p111: page 28]
PLAN / FRONT (1.8:1); SIDE / 侧视 (1:1.2); ISOMETRIC / 轴测 (1:1.3); SECTION A-A / 剖视 (Y=0, Z=13.25); TOLERANCES / 公差; ASSEMBLY; PART / DRAWING; SCALE / 比例; STATUS

BREP-derived orthographic projections | First-angle orientation | Not for manufacture

MATERIAL / 材料
PEEK, grade TBD; structural qualification pending

01 Foot 70 x 60 x 5; 2 x Ø9 tie-rod clearance through at (65, +/-20)
02 Post section 7 x 12; Z=-0.5..31.5; transverse comb hole Ø4.5 at Y=0, Z=27
03 Fixing holes align with existing M8 tie-rod stack; no separate clamp/strap fastener
04 Front bracket in native coordinates; align A/C comb support cross-hole

Unspecified unless individually stated; confirm before release.

PEEK grade TBD; preliminary cantilever; structural qualification pending

PEEK support is a preliminary cantilever; structural qualification pending.

KB-801 / DWG-KB-801

# KB-802 | 后PEEK支架

### FEATURE / DIMENSION SCHEDULE | 特征尺寸表

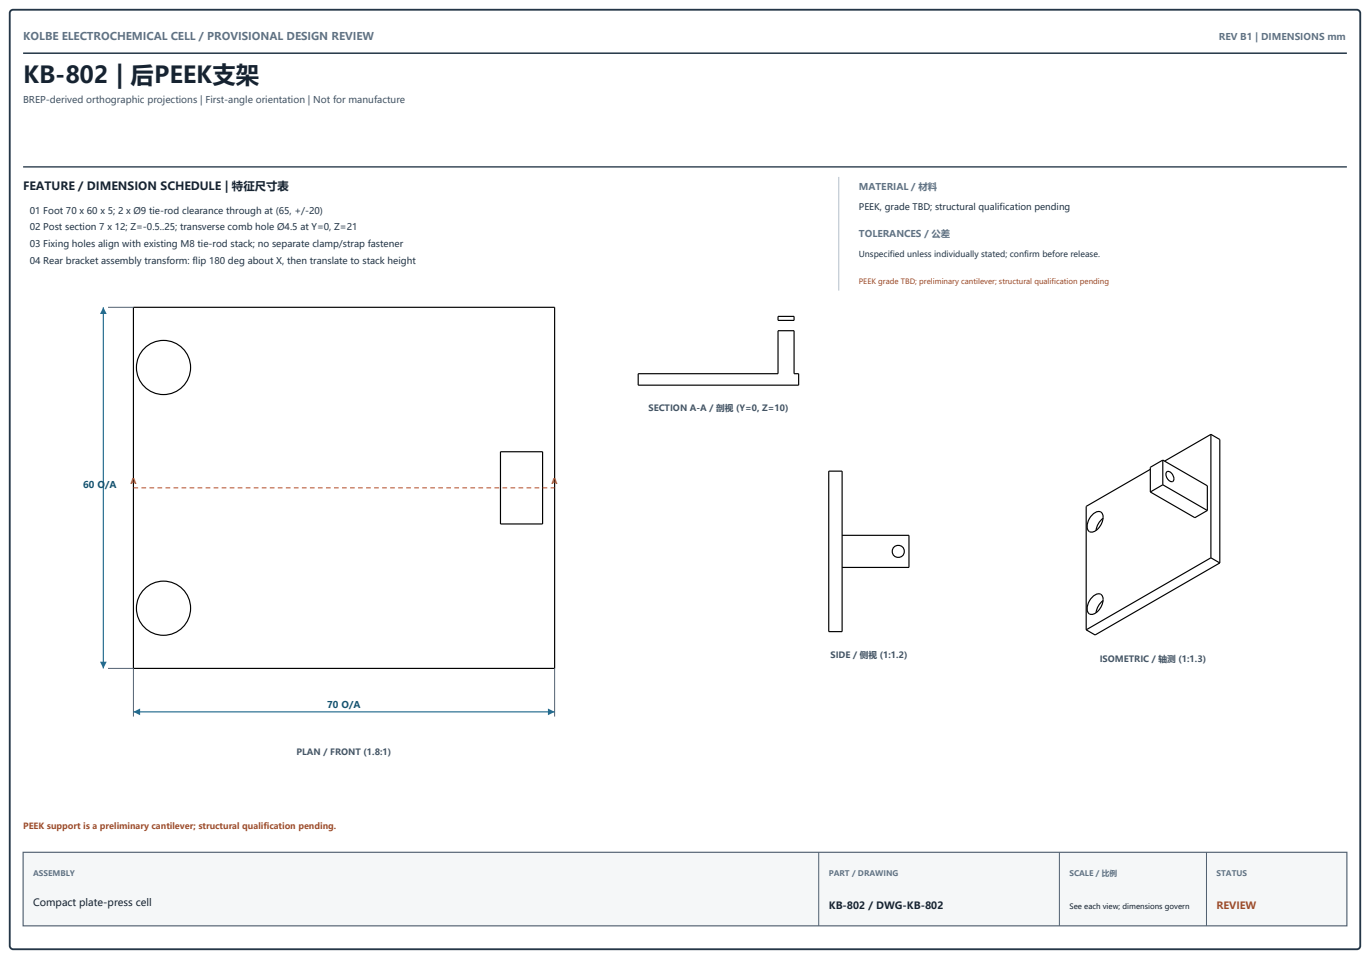
[picture p112: page 29]
PLAN / FRONT (1.8:1); SIDE / 侧视 (1:1.2); ISOMETRIC / 轴测 (1:1.3); SECTION A-A / 剖视 (Y=0, Z=10); TOLERANCES / 公差; ASSEMBLY; PART / DRAWING; SCALE / 比例; STATUS

BREP-derived orthographic projections | First-angle orientation | Not for manufacture

MATERIAL / 材料
PEEK, grade TBD; structural qualification pending

01 Foot 70 x 60 x 5; 2 x Ø9 tie-rod clearance through at (65, +/-20)
02 Post section 7 x 12; Z=-0.5..25; transverse comb hole Ø4.5 at Y=0, Z=21
03 Fixing holes align with existing M8 tie-rod stack; no separate clamp/strap fastener
04 Rear bracket assembly transform: flip 180 deg about X, then translate to stack height

Unspecified unless individually stated; confirm before release.

PEEK grade TBD; preliminary cantilever; structural qualification pending

PEEK support is a preliminary cantilever; structural qualification pending.

KB-802 / DWG-KB-802

# KH-901 | M4交叉孔堵头

### FEATURE / DIMENSION SCHEDULE | 特征尺寸表

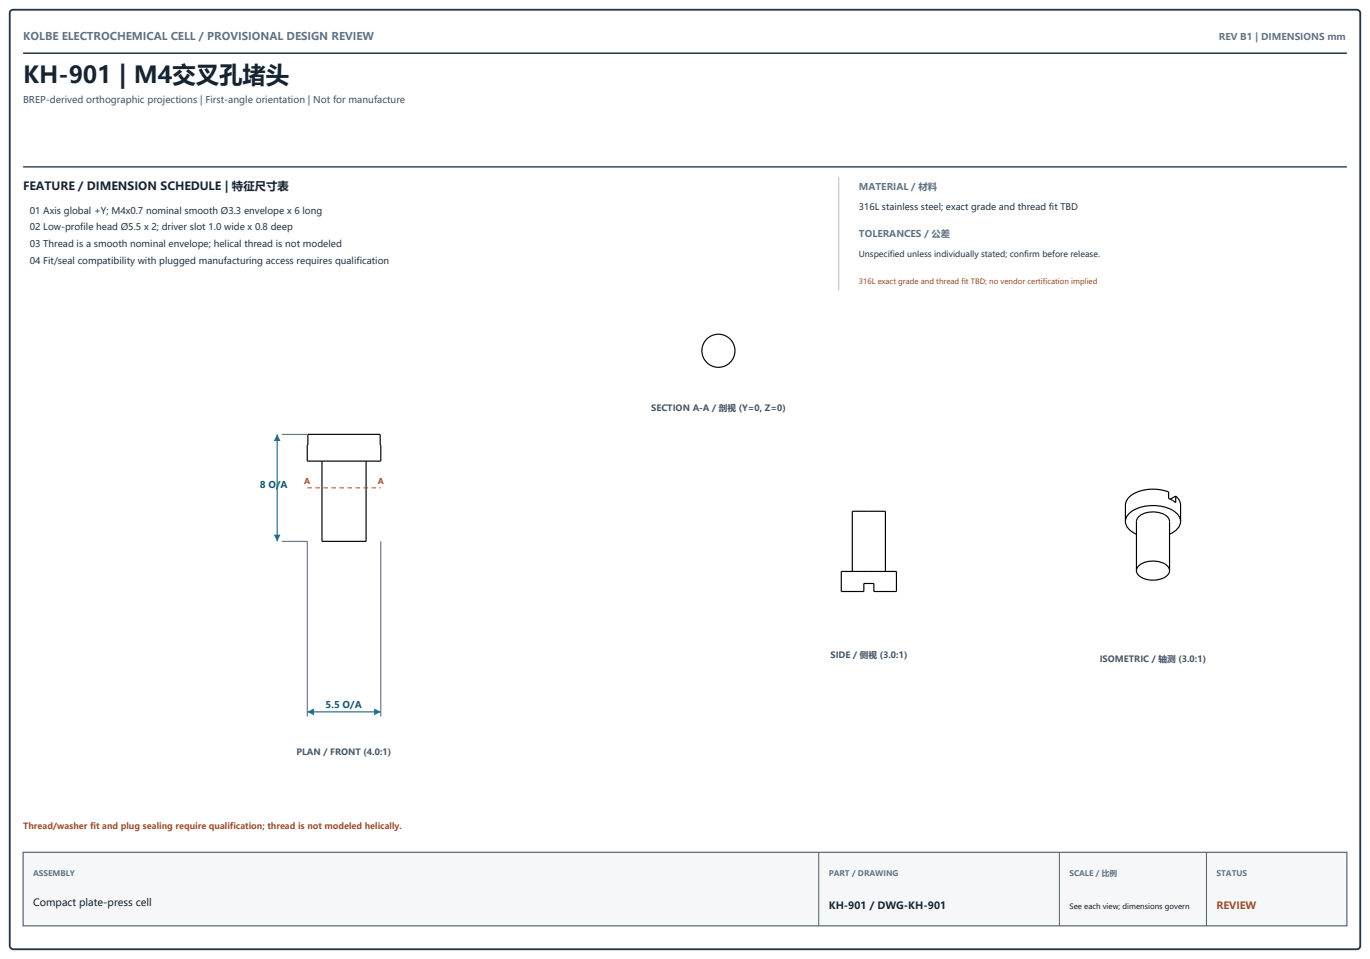
[picture p113: page 30]
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

BREP-derived orthographic projections | First-angle orientation | Not for manufacture

MATERIAL / 材料
316L stainless steel; exact grade and thread fit TBD

01 Axis global +Y; M4x0.7 nominal smooth Ø3.3 envelope x 6 long
02 Low-profile head Ø5.5 x 2; driver slot 1.0 wide x 0.8 deep
03 Thread is a smooth nominal envelope; helical thread is not modeled
04 Fit/seal compatibility with plugged manufacturing access requires qualification

Unspecified unless individually stated; confirm before release.

316L exact grade and thread fit TBD; no vendor certification implied

Thread/washer fit and plug sealing require qualification; thread is not modeled helically.

KH-901 / DWG-KH-901

# KH-902 | 堵头垫圈

### FEATURE / DIMENSION SCHEDULE | 特征尺寸表

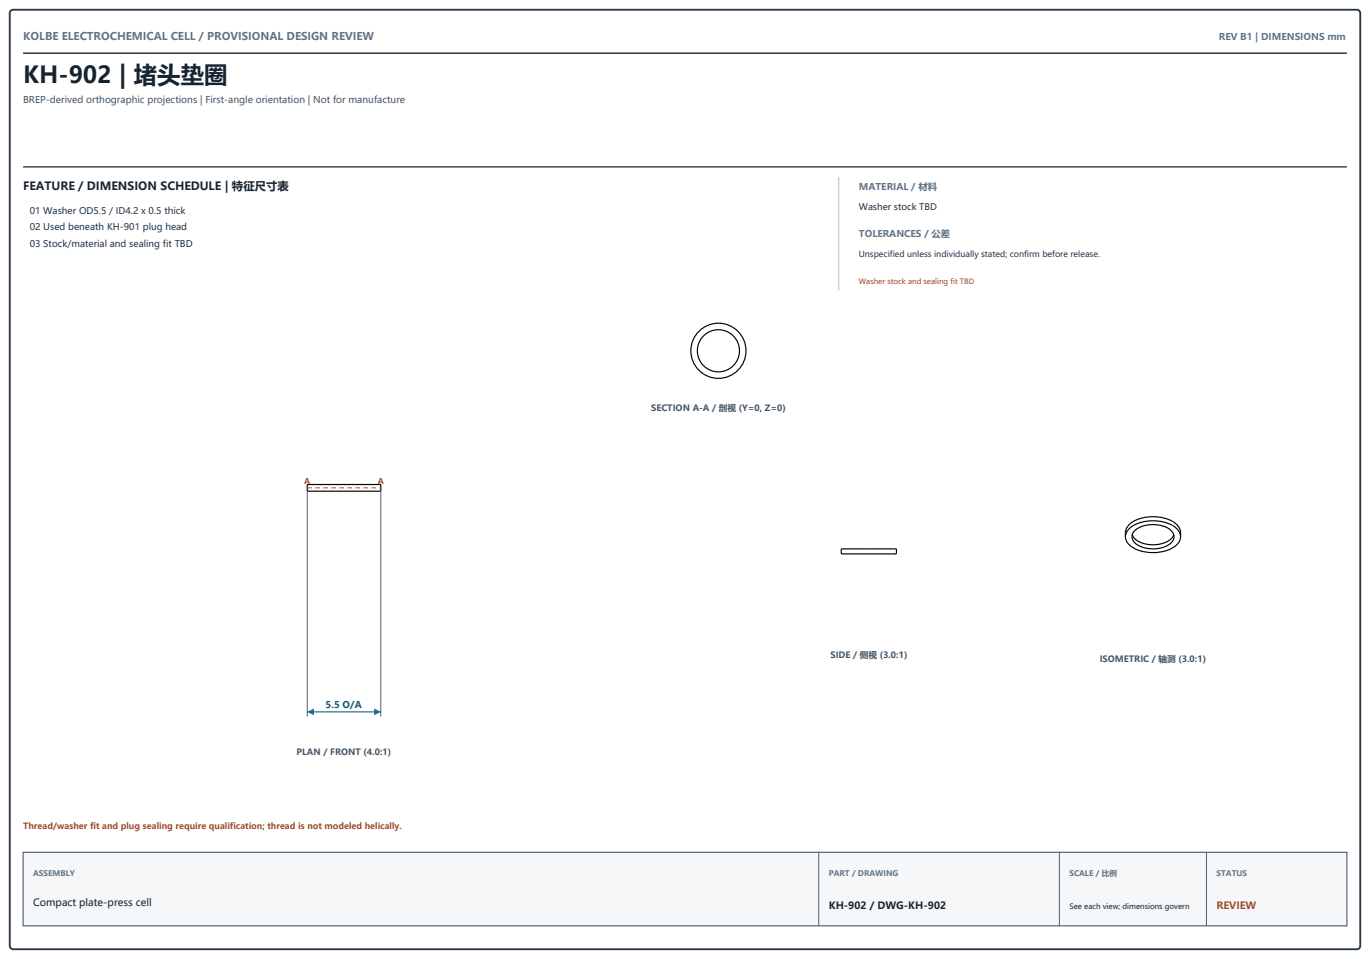
[picture p114: page 31]
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

BREP-derived orthographic projections | First-angle orientation | Not for manufacture

MATERIAL / 材料
Washer stock TBD

01 Washer OD5.5 / ID4.2 x 0.5 thick
02 Used beneath KH-901 plug head
03 Stock/material and sealing fit TBD

Unspecified unless individually stated; confirm before release.

Washer stock and sealing fit TBD

Thread/washer fit and plug sealing require qualification; thread is not modeled helically.

KH-902 / DWG-KH-902

# KS-101 | 主圆角方形密封圈

### FEATURE / DIMENSION SCHEDULE | 特征尺寸表

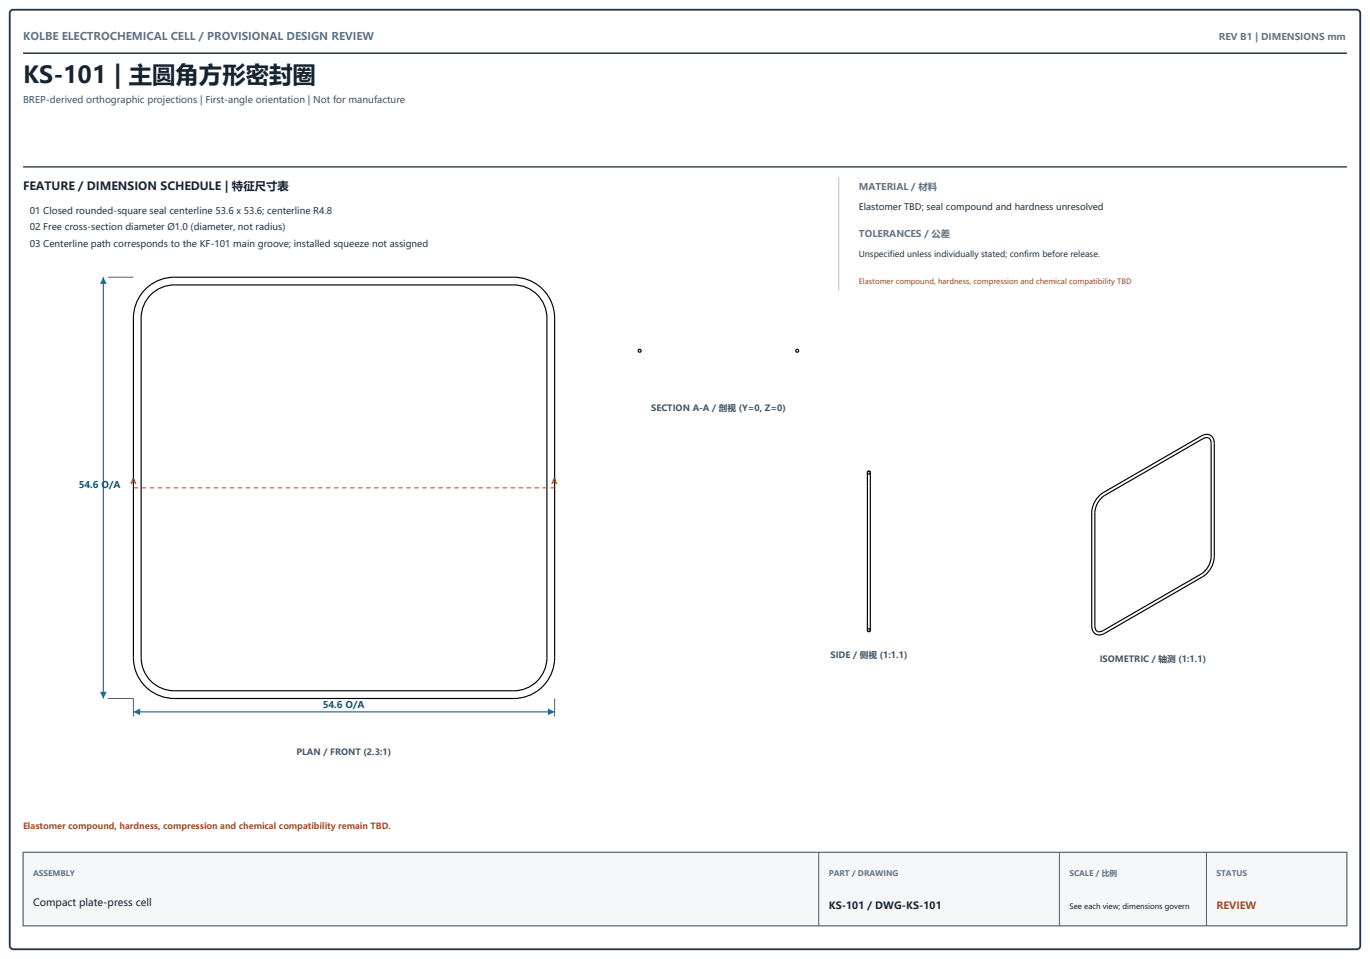
[picture p115: page 32]
PLAN / FRONT (2.3:1); SIDE / 侧视 (1:1.1); ISOMETRIC / 轴测 (1:1.1); SECTION A-A / 剖视 (Y=0, Z=0); TOLERANCES / 公差; ASSEMBLY; PART / DRAWING; SCALE / 比例; STATUS

BREP-derived orthographic projections | First-angle orientation | Not for manufacture

MATERIAL / 材料
Elastomer TBD; seal compound and hardness unresolved

01 Closed rounded-square seal centerline 53.6 x 53.6; centerline R4.8
02 Free cross-section diameter Ø1.0 (diameter, not radius)
03 Centerline path corresponds to the KF-101 main groove; installed squeeze not assigned

Unspecified unless individually stated; confirm before release.

Elastomer compound, hardness, compression and chemical compatibility TBD

Elastomer compound, hardness, compression and chemical compatibility remain TBD.

KS-101 / DWG-KS-101

# KS-102 | 歧管圆形密封圈

### FEATURE / DIMENSION SCHEDULE | 特征尺寸表

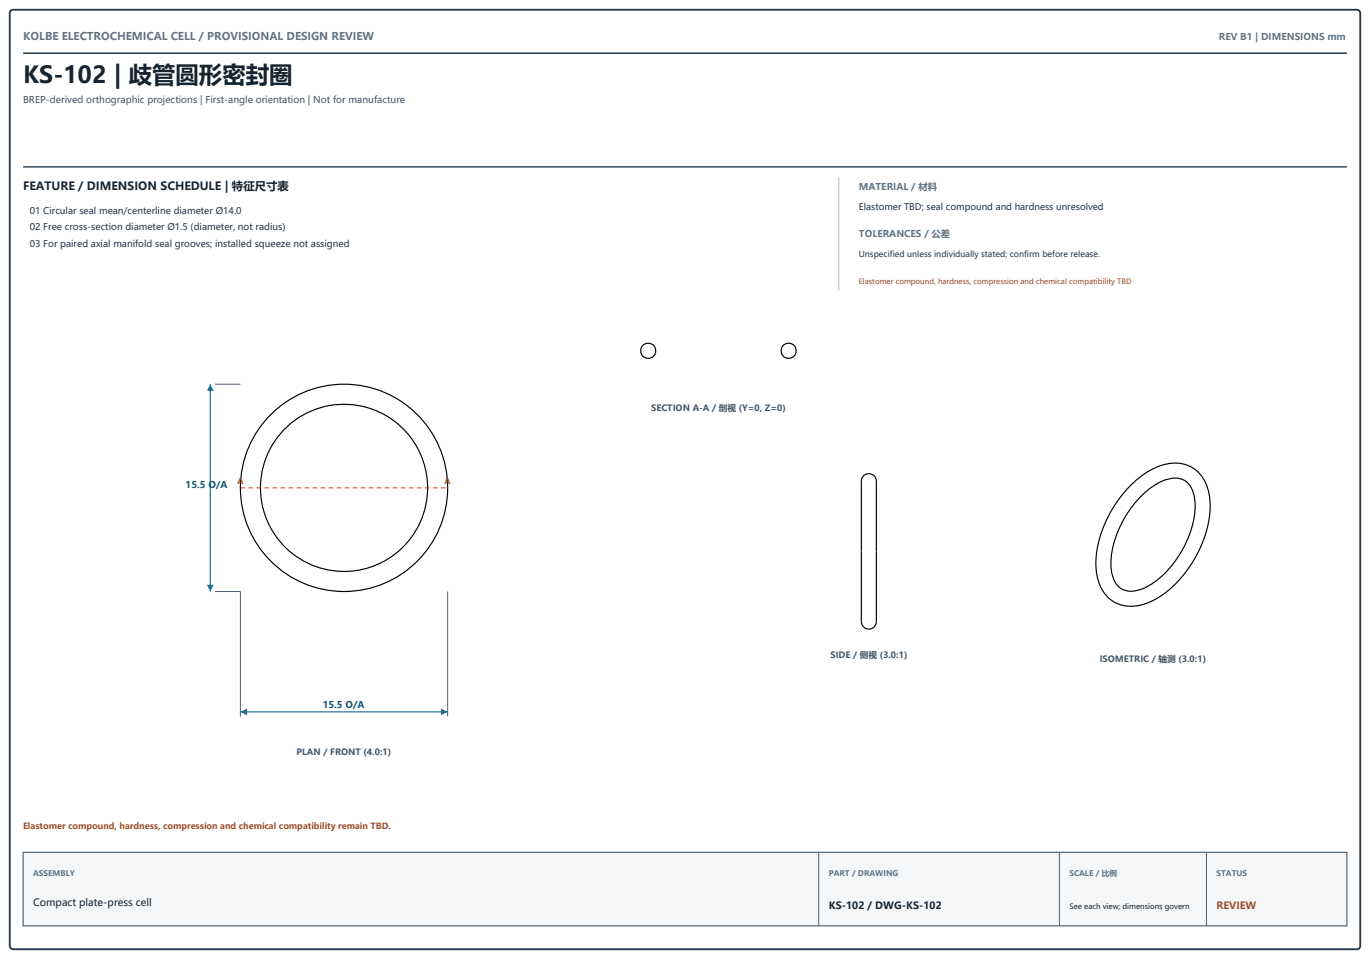
[picture p116: page 33]
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

BREP-derived orthographic projections | First-angle orientation | Not for manufacture

MATERIAL / 材料
Elastomer TBD; seal compound and hardness unresolved

01 Circular seal mean/centerline diameter Ø14.0
02 Free cross-section diameter Ø1.5 (diameter, not radius)
03 For paired axial manifold seal grooves; installed squeeze not assigned

Unspecified unless individually stated; confirm before release.

Elastomer compound, hardness, compression and chemical compatibility TBD

Elastomer compound, hardness, compression and chemical compatibility remain TBD.

KS-102 / DWG-KS-102
