1649472332-arch/Kolbe_Codex_handoff/CAD_v2/archive/before_no_busbars/drawings/Kolbe_CAD_B1_Chinese_dimensioned_review_book.pdf

## KOLBE ELECTROCHEMICAL CELL / REV B1

# 板式压紧电化学电池

# CAD尺寸评审图册

依据最终零件BREP生成正视、侧视、轴测投影；尺寸单位为mm。

湿窗投影占箔片实体：79.56% = 2492.274 / 3132.566 mm²（50 x 50 R3窗口 / 56 x 56 R2箔片本体；干端子排除）。

审查状态：压力、化学兼容性、材料牌号、制造公差及密封验证未完成。

6 mm间隙仅为机械评审包络；实际电极厚度、装配间隙和泵流量待确认。

不赋予额定压力或最终紧固扭矩。螺纹标注为名义光滑包络，不代表螺旋牙型。

图册包含零件功能、材料现状、主要尺寸、端口/密封/紧固特征和模型投影。

图纸编号：B1-CAD-REVIEW | 禁止用于制造放行

包含3/5/7层当前总成投影及全部在用自定义零件；已剔除未使用的旧端子、铜带和固定长度定位销。

# KOLBE-3 | 3-LAYER PLATE-PRESS STACK

### ASSEMBLY ENVELOPE / 总成参数

KOLBE ELECTROCHEMICAL CELL / ASSEMBLY REVIEW; REV B1 | DIMENSIONS mm; PLAN / FRONT (1:2.1); SIDE (1:3.1); ISOMETRIC (1:4.2); ASSEMBLY; DRAWING; KOLBE-3 / ASM-3; SOURCE; STATUS; REVIEW

Actual assembled BREP projection | See component sheets for manufacturing dimensions

01 BREP envelope: 260.4 x 154.6 x 87.25 mm (X x Y x Z)
02 Validated body stack height: 57.05 mm; active layer-stack height: 13.05 mm
03 Assembly BREP contains 103 component instances; view shows actual model placements
04 Geometry/model volume reported by assembly Stack: 1363161.9 mm³; not a pressure or strength rating
05 6 mm inter-electrode gap is a provisional envelope; pump flow, materials and sealing remain unresolved

SECTION A-A (Y=0; Z MID-STACK)

REVIEW GEOMETRY ONLY; do not infer pressure, torque, current capacity or final gap from this assembly view.

3-layer compact plate-press

Kolbe_3.FCStd Stack.Shape

# KOLBE-5 | 5-LAYER PLATE-PRESS STACK

### ASSEMBLY ENVELOPE / 总成参数

KOLBE ELECTROCHEMICAL CELL / ASSEMBLY REVIEW; REV B1 | DIMENSIONS mm; PLAN / FRONT (1:2.1); SIDE (1:3.1); ISOMETRIC (1:4.2); ASSEMBLY; DRAWING; KOLBE-5 / ASM-5; SOURCE; STATUS

Actual assembled BREP projection | See component sheets for manufacturing dimensions

01 BREP envelope: 260.4 x 154.6 x 99.95 mm (X x Y x Z)
02 Validated body stack height: 69.75 mm; active layer-stack height: 25.75 mm
03 Assembly BREP contains 135 component instances; view shows actual model placements
04 Geometry/model volume reported by assembly Stack: 1619713.1 mm³; not a pressure or strength rating
05 6 mm inter-electrode gap is a provisional envelope; pump flow, materials and sealing remain unresolved

SECTION A-A (Y=0; Z MID-STACK)

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

5-layer compact plate-press

Kolbe_5.FCStd Stack.Shape

# KOLBE-7 | 7-LAYER PLATE-PRESS STACK

### ASSEMBLY ENVELOPE / 总成参数

KOLBE ELECTROCHEMICAL CELL / ASSEMBLY REVIEW; REV B1 | DIMENSIONS mm; PLAN / FRONT (1:2.1); SIDE (1:3.1); ISOMETRIC (1:4.2); ASSEMBLY; DRAWING; KOLBE-7 / ASM-7; SOURCE; STATUS

Actual assembled BREP projection | See component sheets for manufacturing dimensions

01 BREP envelope: 260.4 x 154.6 x 112.65 mm (X x Y x Z)
02 Validated body stack height: 82.45 mm; active layer-stack height: 38.45 mm
03 Assembly BREP contains 167 component instances; view shows actual model placements
04 Geometry/model volume reported by assembly Stack: 1876264.2 mm³; not a pressure or strength rating
05 6 mm inter-electrode gap is a provisional envelope; pump flow, materials and sealing remain unresolved

SECTION A-A (Y=0; Z MID-STACK)

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

7-layer compact plate-press

Kolbe_7.FCStd Stack.Shape

# KF-101 | 流道框架

### FEATURE / DIMENSION SCHEDULE | 特征尺寸表

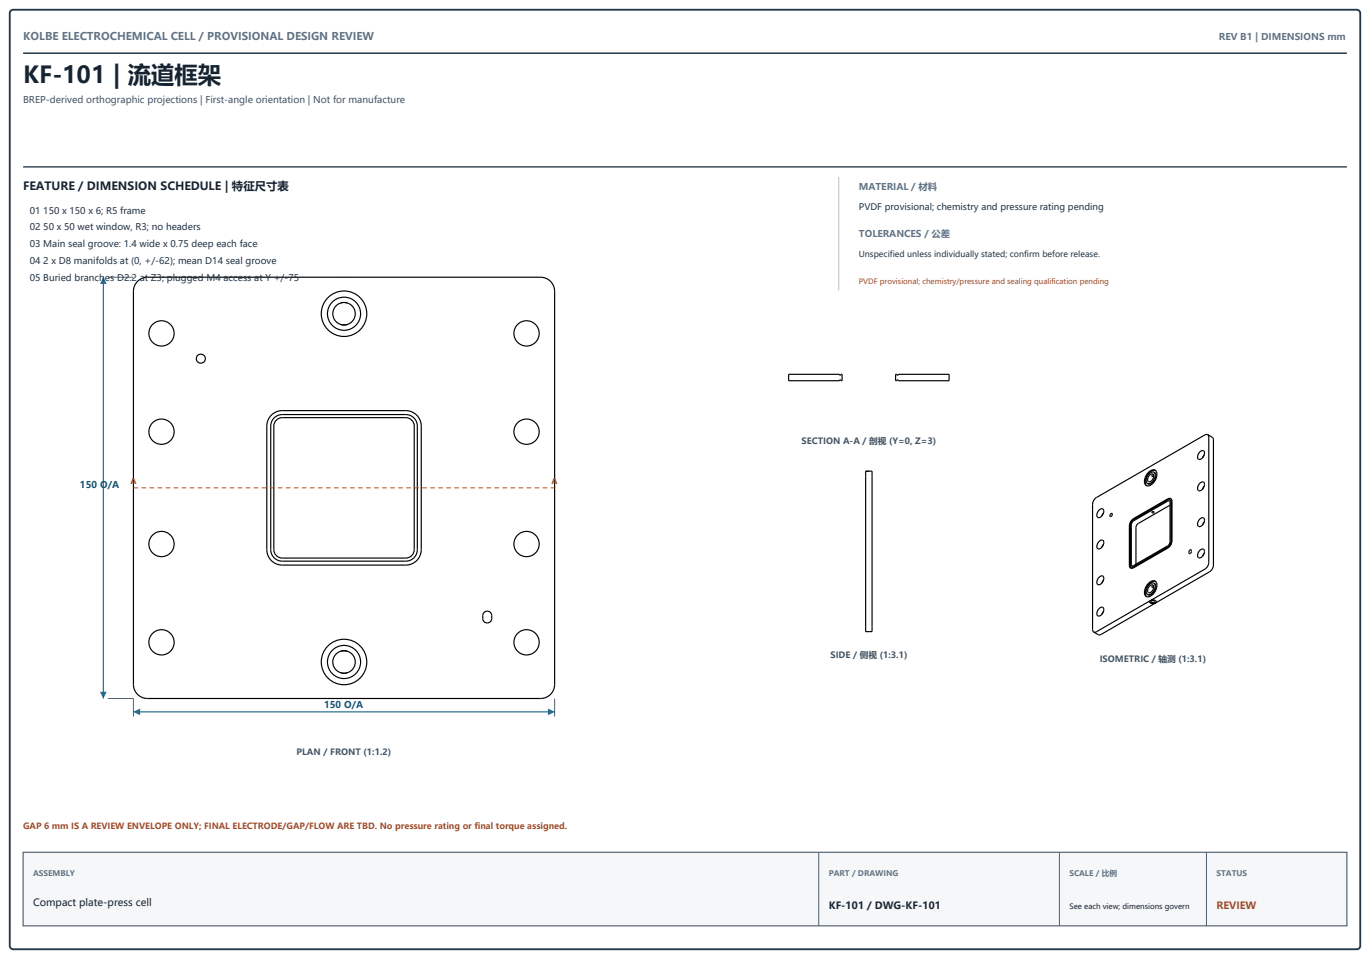
[picture p117: page 5]
KOLBE ELECTROCHEMICAL CELL / PROVISIONAL DESIGN REVIEW; REV B1 | DIMENSIONS mm; PLAN / FRONT (1:1.2); SIDE / 侧视 (1:3.1); ISOMETRIC / 轴测 (1:3.1); SECTION A-A / 剖视 (Y=0, Z=3); TOLERANCES / 公差; ASSEMBLY; PART / DRAWING; SCALE / 比例; STATUS

BREP-derived orthographic projections | First-angle orientation | Not for manufacture

MATERIAL / 材料
PVDF provisional; chemistry and pressure rating pending

01 150 x 150 x 6; R5 frame
02 50 x 50 wet window, R3; no headers
03 Main seal groove: 1.4 wide x 0.75 deep each face
04 2 x D8 manifolds at (0, +/-62); mean D14 seal groove
05 Buried branches D2.2 at Z3; plugged M4 access at Y +/-75

Unspecified unless individually stated; confirm before release.

PVDF provisional; chemistry/pressure and sealing qualification pending

GAP 6 mm IS A REVIEW ENVELOPE ONLY; FINAL ELECTRODE/GAP/FLOW ARE TBD. No pressure rating or final torque assigned.

Compact plate-press cell

KF-101 / DWG-KF-101

See each view; dimensions govern

# KP-101 | A向正极箔片

### FEATURE / DIMENSION SCHEDULE | 特征尺寸表

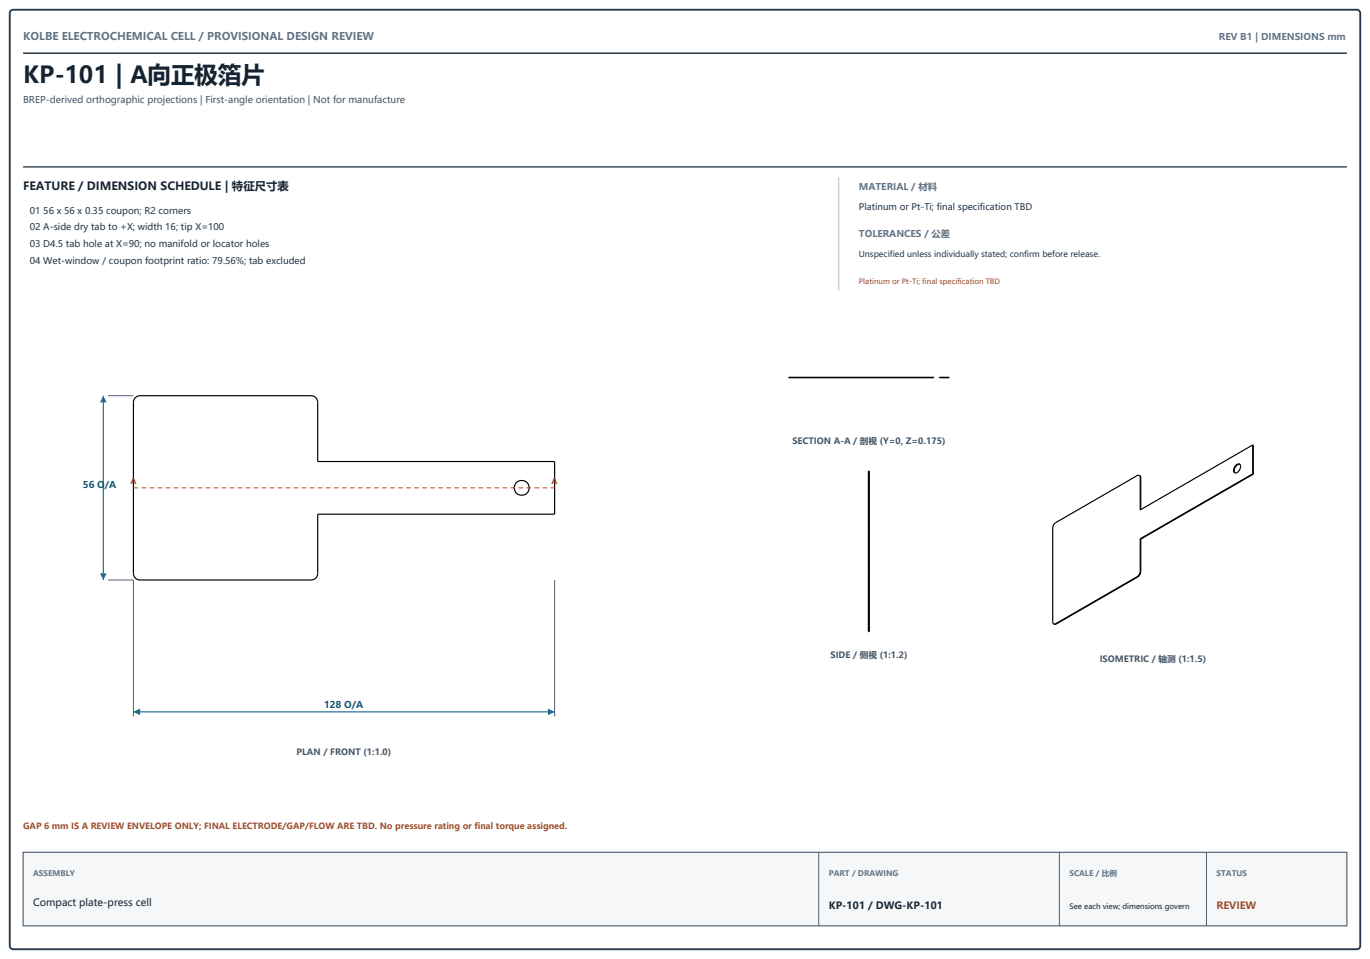
[picture p118: page 6]
PLAN / FRONT (1:1.0); SIDE / 侧视 (1:1.2); ISOMETRIC / 轴测 (1:1.5); SECTION A-A / 剖视 (Y=0, Z=0.175); TOLERANCES / 公差; ASSEMBLY; PART / DRAWING; SCALE / 比例; STATUS

BREP-derived orthographic projections | First-angle orientation | Not for manufacture

MATERIAL / 材料
Platinum or Pt-Ti; final specification TBD

01 56 x 56 x 0.35 coupon; R2 corners
02 A-side dry tab to +X; width 16; tip X=100
03 D4.5 tab hole at X=90; no manifold or locator holes
04 Wet-window / coupon footprint ratio: 79.56%; tab excluded

Unspecified unless individually stated; confirm before release.

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

KP-101 / DWG-KP-101

# KP-102 | C向负极箔片

### FEATURE / DIMENSION SCHEDULE | 特征尺寸表

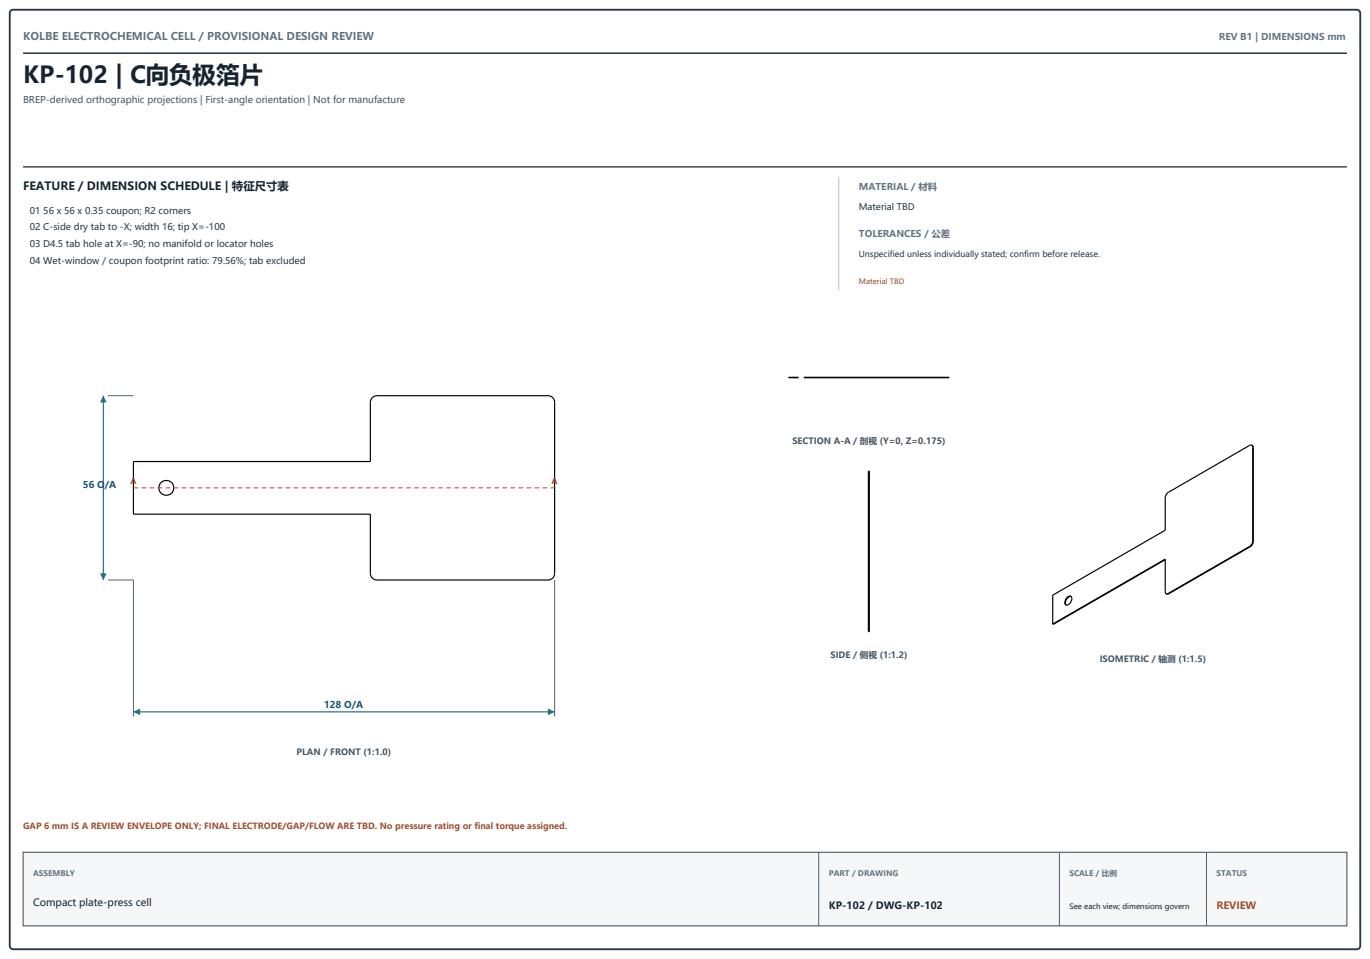
[picture p119: page 7]
PLAN / FRONT (1:1.0); SIDE / 侧视 (1:1.2); ISOMETRIC / 轴测 (1:1.5); SECTION A-A / 剖视 (Y=0, Z=0.175); MATERIAL / 材料; Material TBD; TOLERANCES / 公差; ASSEMBLY; PART / DRAWING; SCALE / 比例; STATUS

BREP-derived orthographic projections | First-angle orientation | Not for manufacture

01 56 x 56 x 0.35 coupon; R2 corners
02 C-side dry tab to -X; width 16; tip X=-100
03 D4.5 tab hole at X=-90; no manifold or locator holes
04 Wet-window / coupon footprint ratio: 79.56%; tab excluded

Unspecified unless individually stated; confirm before release.

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

KP-102 / DWG-KP-102

# KP-201 | 前端板

### FEATURE / DIMENSION SCHEDULE | 特征尺寸表

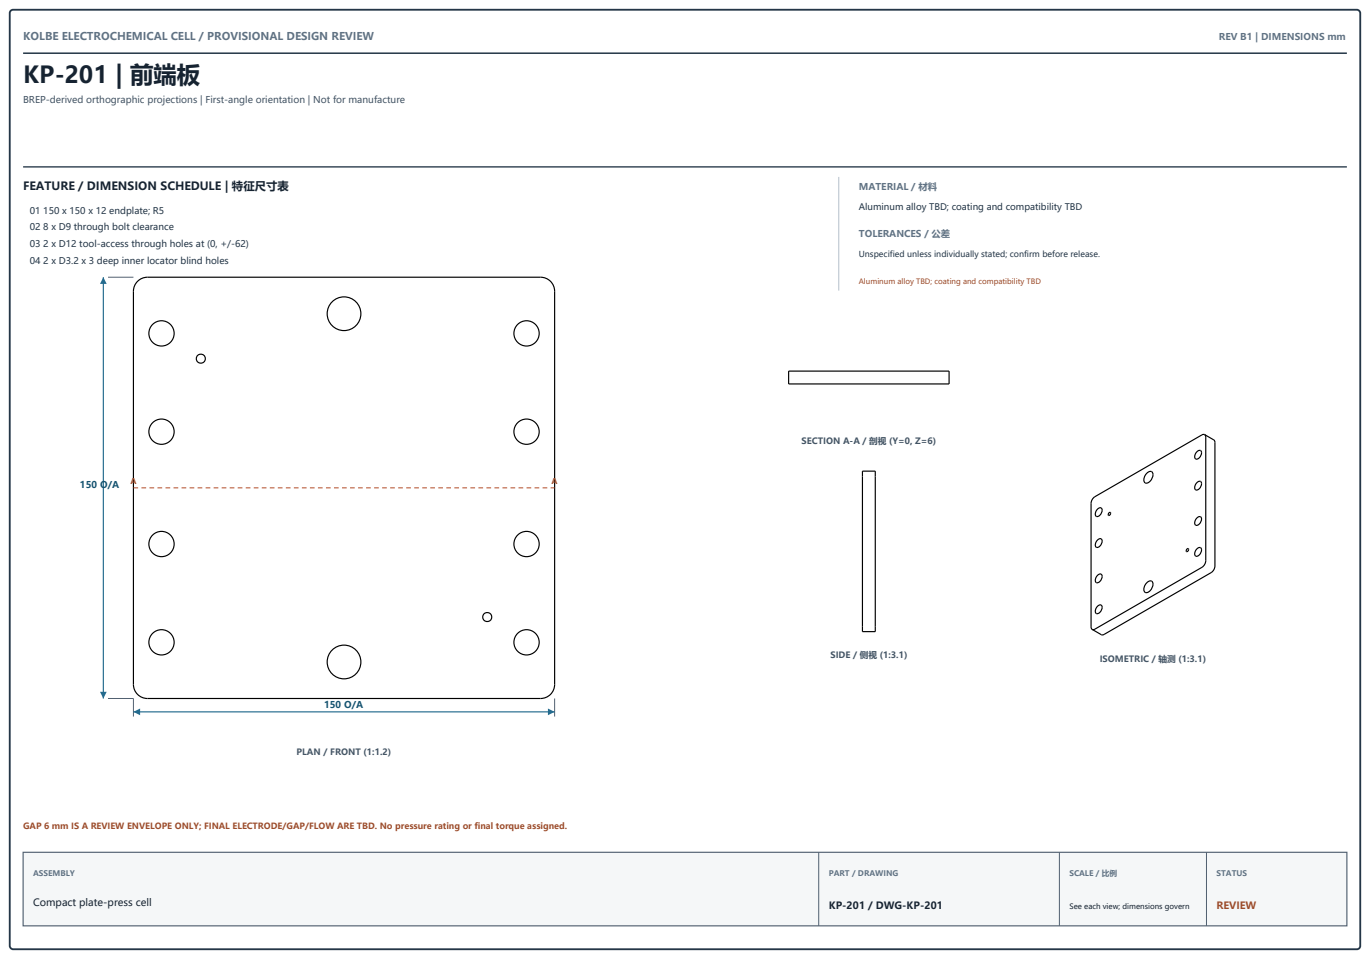
[picture p120: page 8]
PLAN / FRONT (1:1.2); SIDE / 侧视 (1:3.1); ISOMETRIC / 轴测 (1:3.1); SECTION A-A / 剖视 (Y=0, Z=6); TOLERANCES / 公差; ASSEMBLY; PART / DRAWING; SCALE / 比例; STATUS

BREP-derived orthographic projections | First-angle orientation | Not for manufacture

MATERIAL / 材料
Aluminum alloy TBD; coating and compatibility TBD

01 150 x 150 x 12 endplate; R5
02 8 x D9 through bolt clearance
03 2 x D12 tool-access through holes at (0, +/-62)
04 2 x D3.2 x 3 deep inner locator blind holes

Unspecified unless individually stated; confirm before release.

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

KP-201 / DWG-KP-201

# KP-202 | 前绝缘板

### FEATURE / DIMENSION SCHEDULE | 特征尺寸表

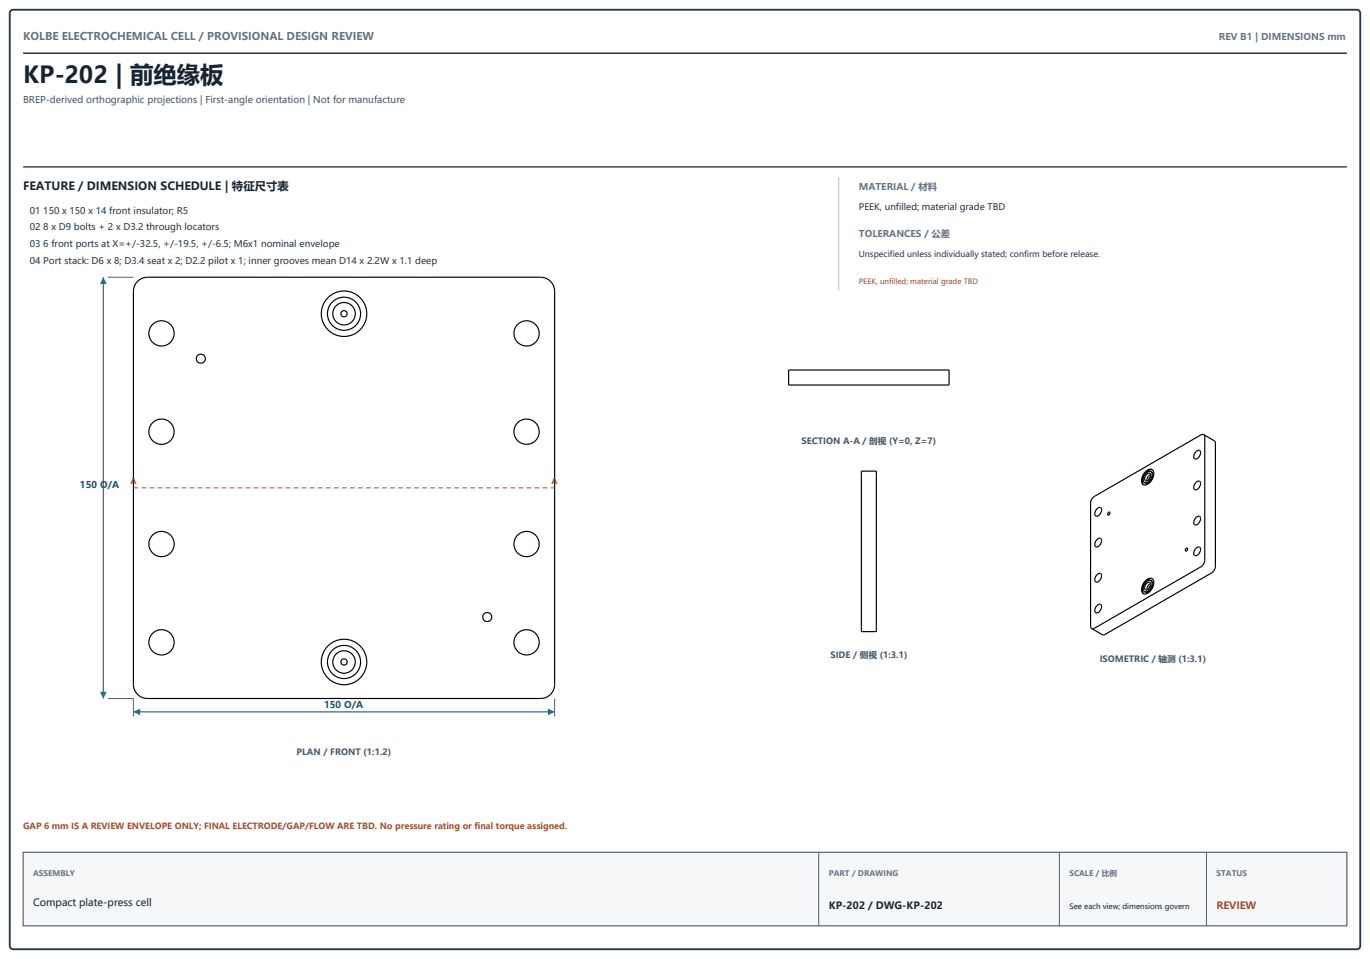
[picture p121: page 9]
PLAN / FRONT (1:1.2); SIDE / 侧视 (1:3.1); ISOMETRIC / 轴测 (1:3.1); SECTION A-A / 剖视 (Y=0, Z=7); TOLERANCES / 公差; ASSEMBLY; PART / DRAWING; SCALE / 比例; STATUS

BREP-derived orthographic projections | First-angle orientation | Not for manufacture

MATERIAL / 材料
PEEK, unfilled; material grade TBD

01 150 x 150 x 14 front insulator; R5
02 8 x D9 bolts + 2 x D3.2 through locators
03 6 front ports at X=+/-32.5, +/-19.5, +/-6.5; M6x1 nominal envelope
04 Port stack: D6 x 8; D3.4 seat x 2; D2.2 pilot x 1; inner grooves mean D14 x 2.2W x 1.1 deep

Unspecified unless individually stated; confirm before release.

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

KP-202 / DWG-KP-202

# KP-203 | 后绝缘板

### FEATURE / DIMENSION SCHEDULE | 特征尺寸表

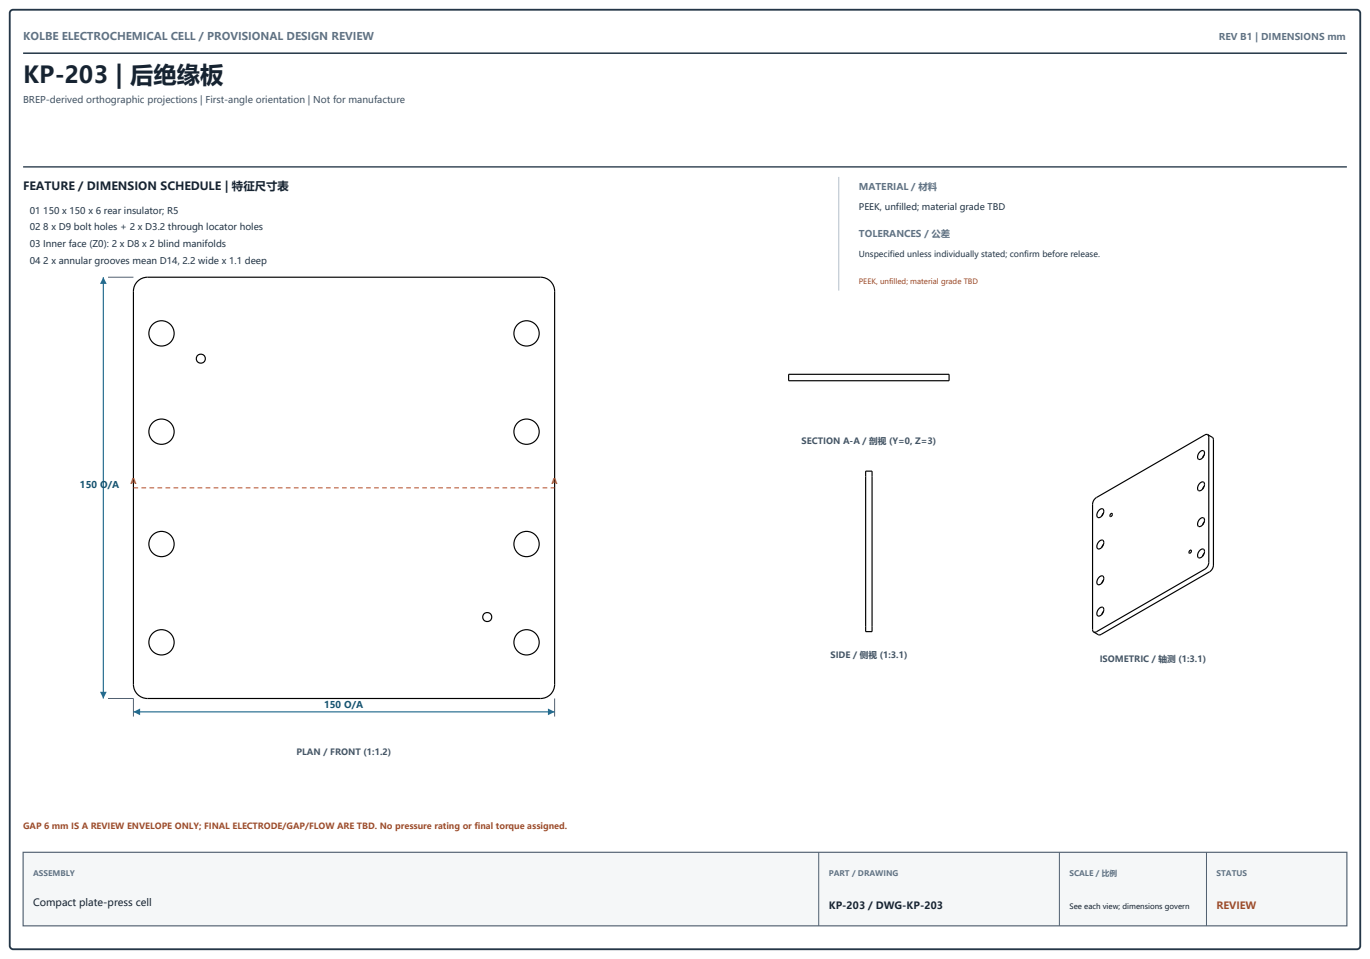
[picture p122: page 10]
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

BREP-derived orthographic projections | First-angle orientation | Not for manufacture

MATERIAL / 材料
PEEK, unfilled; material grade TBD

01 150 x 150 x 6 rear insulator; R5
02 8 x D9 bolt holes + 2 x D3.2 through locator holes
03 Inner face (Z0): 2 x D8 x 2 blind manifolds
04 2 x annular grooves mean D14, 2.2 wide x 1.1 deep

Unspecified unless individually stated; confirm before release.

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

KP-203 / DWG-KP-203

# KP-204 | 后端板

### FEATURE / DIMENSION SCHEDULE | 特征尺寸表

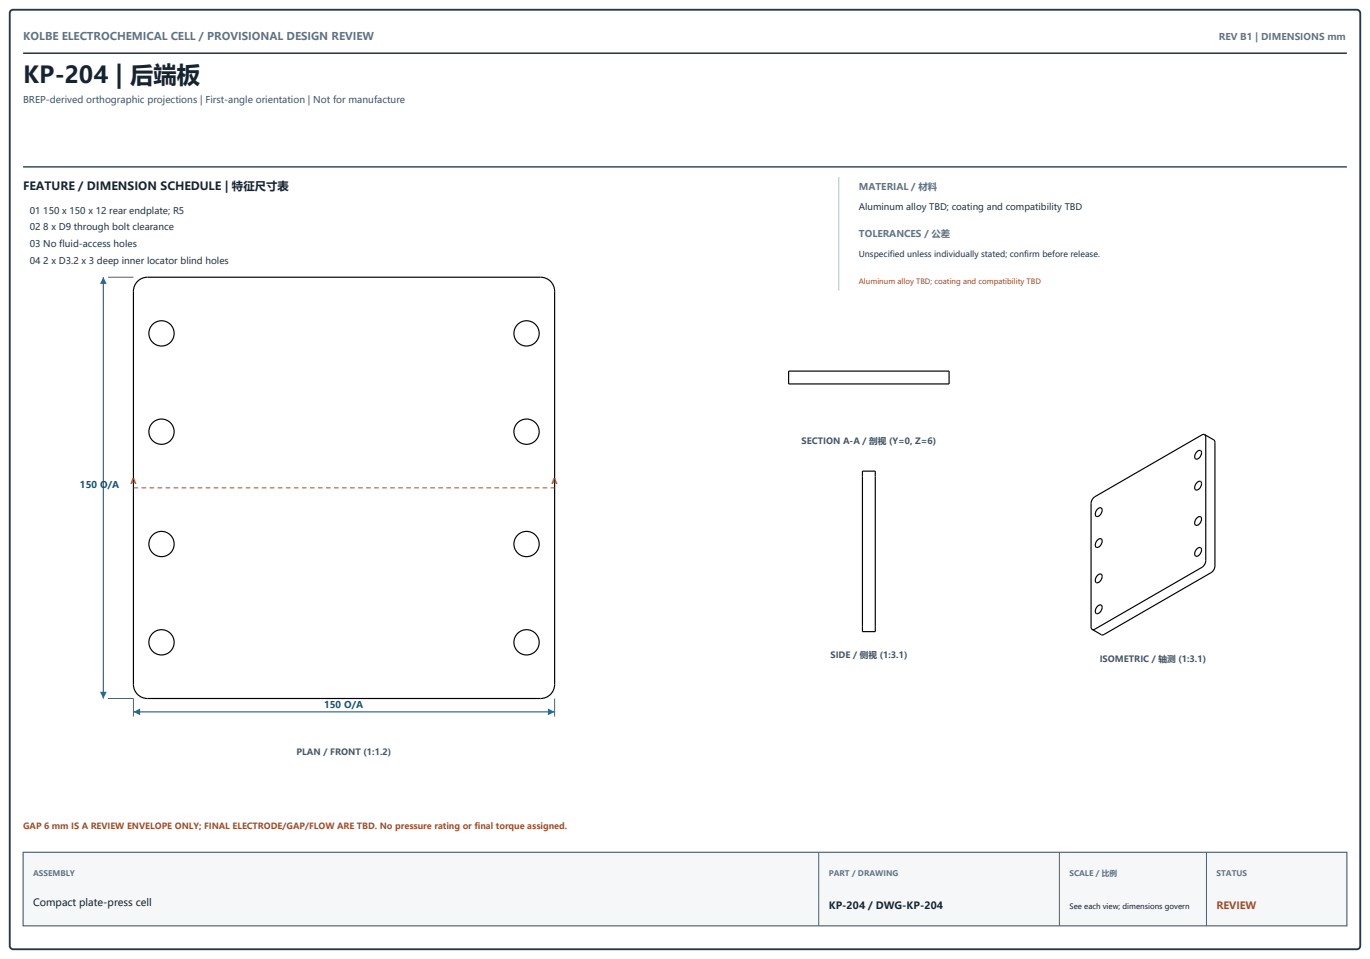
[picture p123: page 11]
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

BREP-derived orthographic projections | First-angle orientation | Not for manufacture

MATERIAL / 材料
Aluminum alloy TBD; coating and compatibility TBD

01 150 x 150 x 12 rear endplate; R5
02 8 x D9 through bolt clearance
03 No fluid-access holes
04 2 x D3.2 x 3 deep inner locator blind holes

Unspecified unless individually stated; confirm before release.

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

KP-204 / DWG-KP-204

# KP-601 | A侧电极载体膜

### FEATURE / DIMENSION SCHEDULE | 特征尺寸表

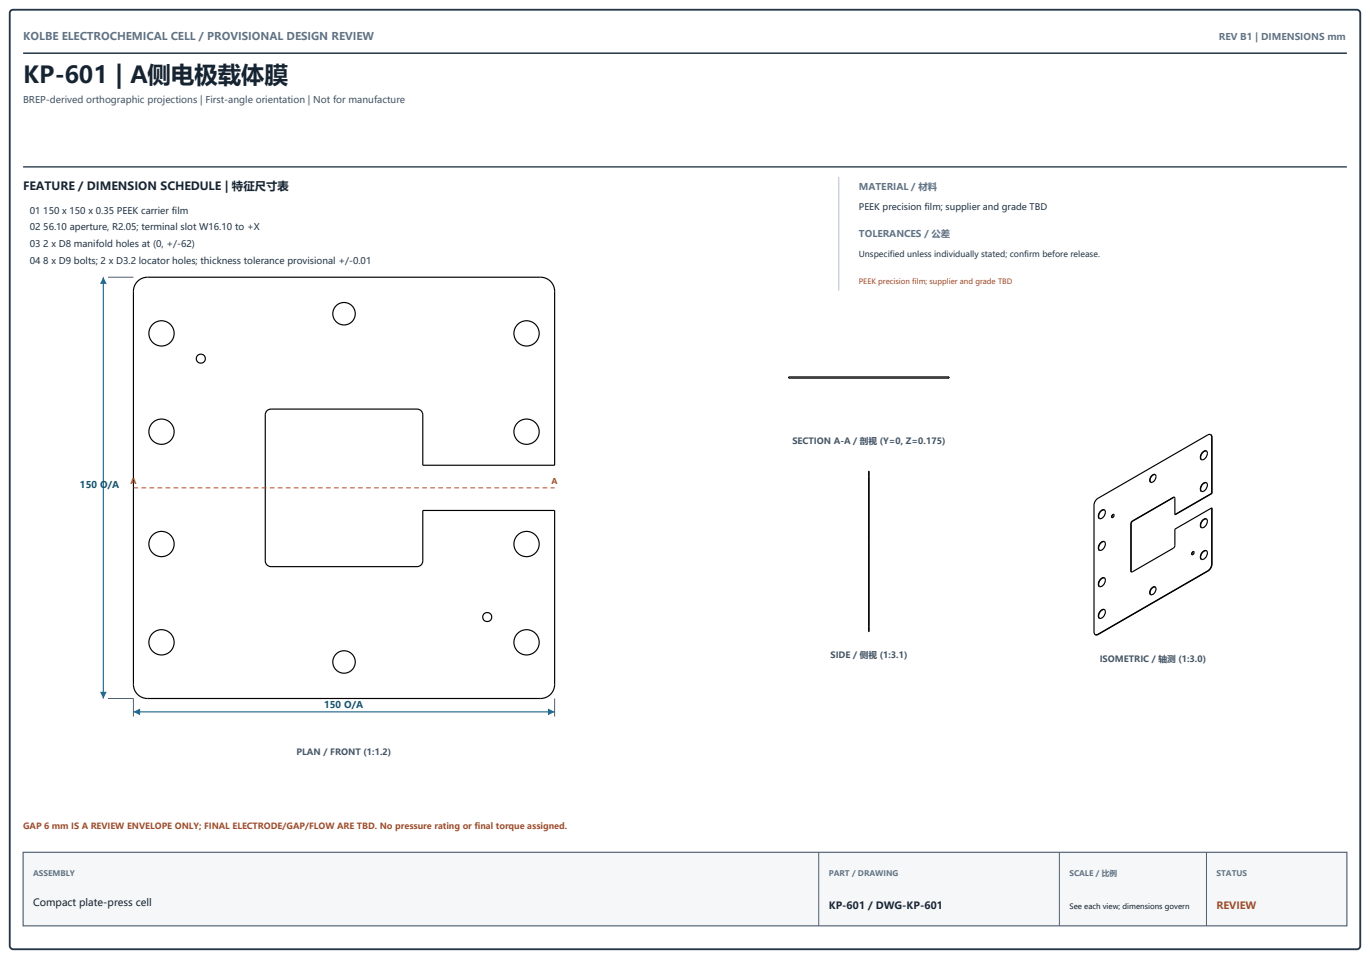
[picture p124: page 12]
PLAN / FRONT (1:1.2); SIDE / 侧视 (1:3.1); ISOMETRIC / 轴测 (1:3.0); SECTION A-A / 剖视 (Y=0, Z=0.175); TOLERANCES / 公差; ASSEMBLY; PART / DRAWING; SCALE / 比例; STATUS

BREP-derived orthographic projections | First-angle orientation | Not for manufacture

MATERIAL / 材料
PEEK precision film; supplier and grade TBD

01 150 x 150 x 0.35 PEEK carrier film
02 56.10 aperture, R2.05; terminal slot W16.10 to +X
03 2 x D8 manifold holes at (0, +/-62)
04 8 x D9 bolts; 2 x D3.2 locator holes; thickness tolerance provisional +/-0.01

Unspecified unless individually stated; confirm before release.

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

KP-601 / DWG-KP-601

# KP-602 | C侧电极载体膜

### FEATURE / DIMENSION SCHEDULE | 特征尺寸表

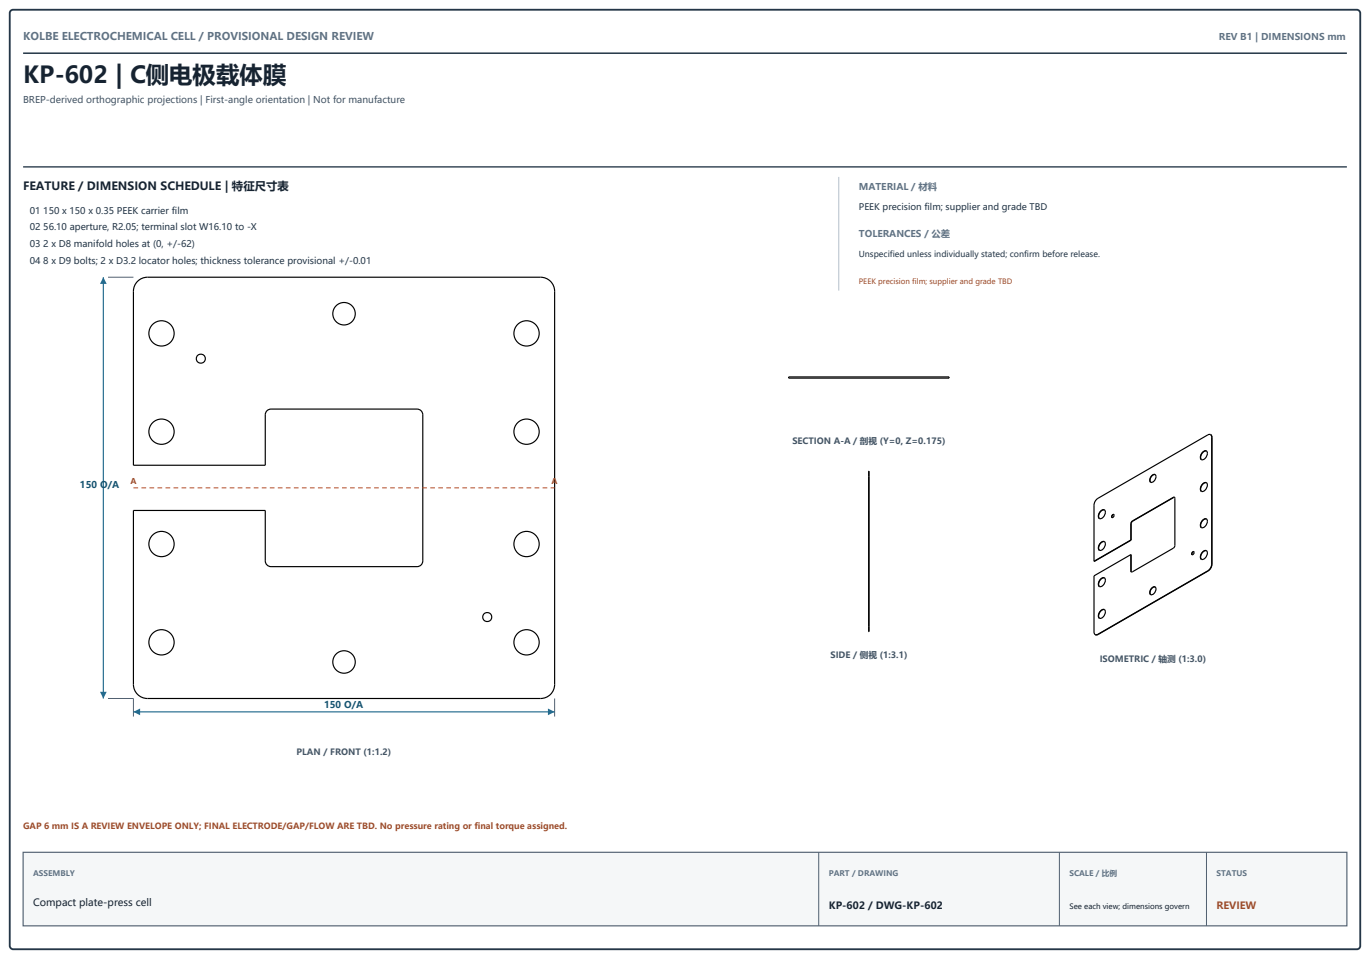
[picture p125: page 13]
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

BREP-derived orthographic projections | First-angle orientation | Not for manufacture

MATERIAL / 材料
PEEK precision film; supplier and grade TBD

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

Unspecified unless individually stated; confirm before release.

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

KP-602 / DWG-KP-602

# KP-301 | 夹紧爪

### FEATURE / DIMENSION SCHEDULE | 特征尺寸表

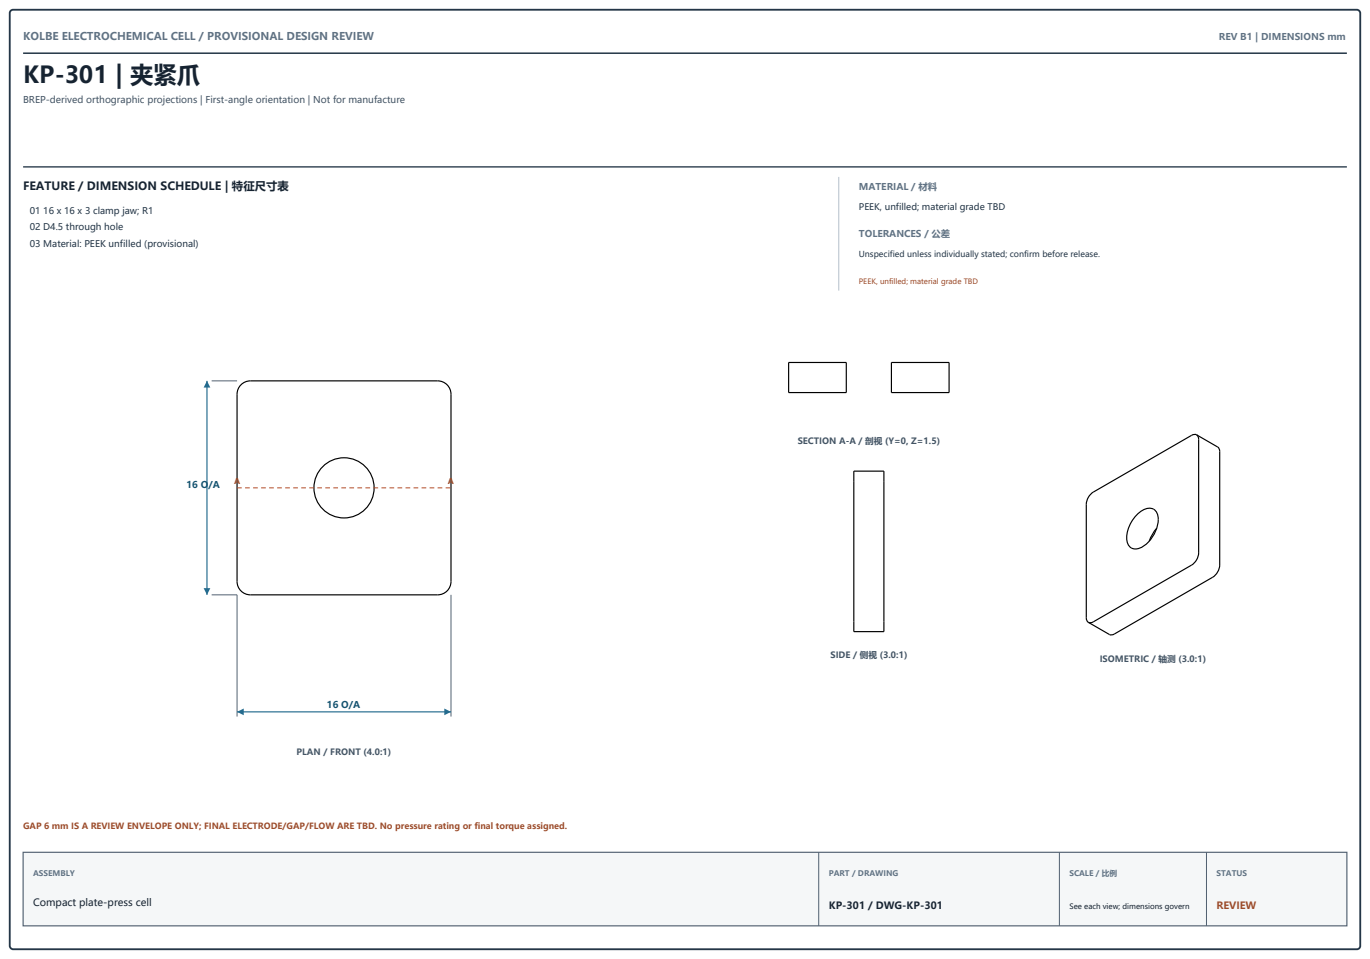
[picture p126: page 14]
PLAN / FRONT (4.0:1); SIDE / 侧视 (3.0:1); ISOMETRIC / 轴测 (3.0:1); SECTION A-A / 剖视 (Y=0, Z=1.5); TOLERANCES / 公差; ASSEMBLY; PART / DRAWING; SCALE / 比例; STATUS

BREP-derived orthographic projections | First-angle orientation | Not for manufacture

MATERIAL / 材料
PEEK, unfilled; material grade TBD

01 16 x 16 x 3 clamp jaw; R1
02 D4.5 through hole
03 Material: PEEK unfilled (provisional)

Unspecified unless individually stated; confirm before release.

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

KP-301 / DWG-KP-301

# KP-501 | 流体接头

### FEATURE / DIMENSION SCHEDULE | 特征尺寸表

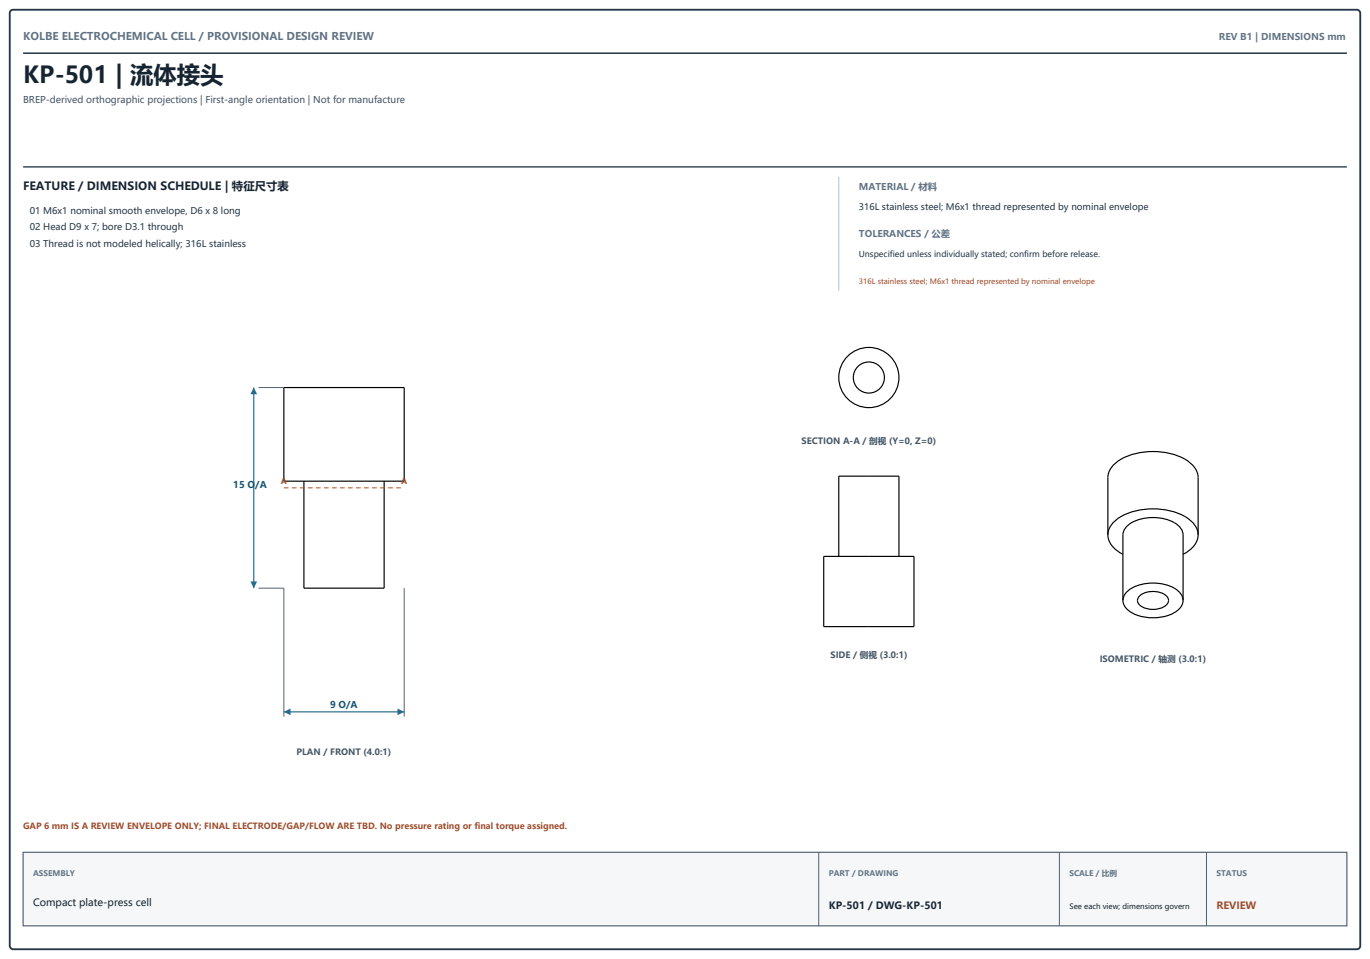
[picture p127: page 15]
PLAN / FRONT (4.0:1); SIDE / 侧视 (3.0:1); ISOMETRIC / 轴测 (3.0:1); SECTION A-A / 剖视 (Y=0, Z=0); TOLERANCES / 公差; ASSEMBLY; PART / DRAWING; SCALE / 比例; STATUS

BREP-derived orthographic projections | First-angle orientation | Not for manufacture

MATERIAL / 材料
316L stainless steel; M6x1 thread represented by nominal envelope

01 M6x1 nominal smooth envelope, D6 x 8 long
02 Head D9 x 7; bore D3.1 through
03 Thread is not modeled helically; 316L stainless

Unspecified unless individually stated; confirm before release.

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

KP-501 / DWG-KP-501

# KP-502 | 压缩密封圈

### FEATURE / DIMENSION SCHEDULE | 特征尺寸表

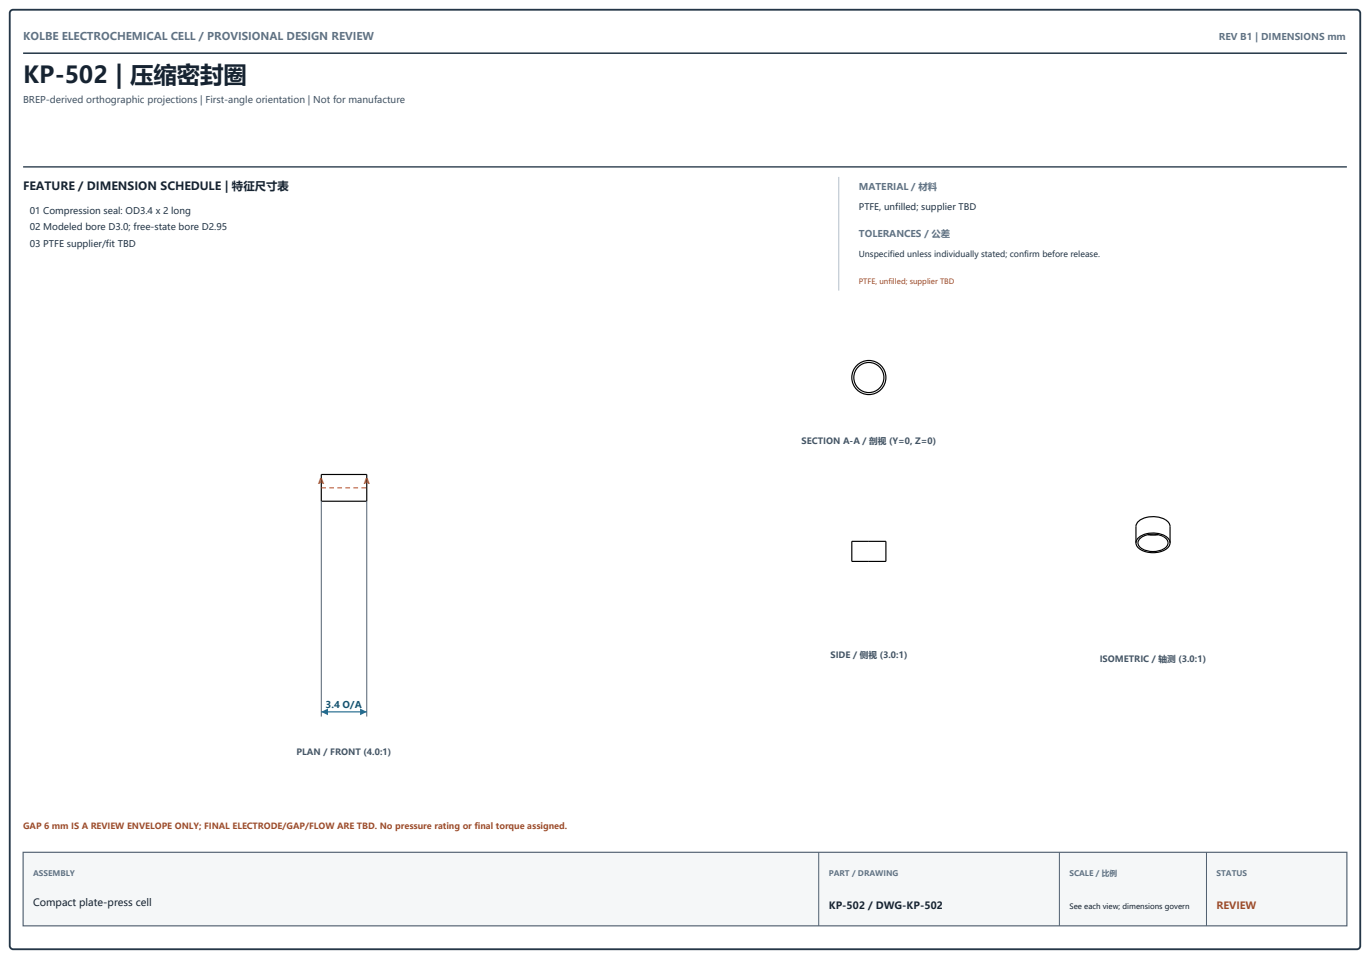
[picture p128: page 16]
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

BREP-derived orthographic projections | First-angle orientation | Not for manufacture

MATERIAL / 材料
PTFE, unfilled; supplier TBD

01 Compression seal: OD3.4 x 2 long
02 Modeled bore D3.0; free-state bore D2.95
03 PTFE supplier/fit TBD

Unspecified unless individually stated; confirm before release.

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

KP-502 / DWG-KP-502

# KP-503 | PTFE管

### FEATURE / DIMENSION SCHEDULE | 特征尺寸表

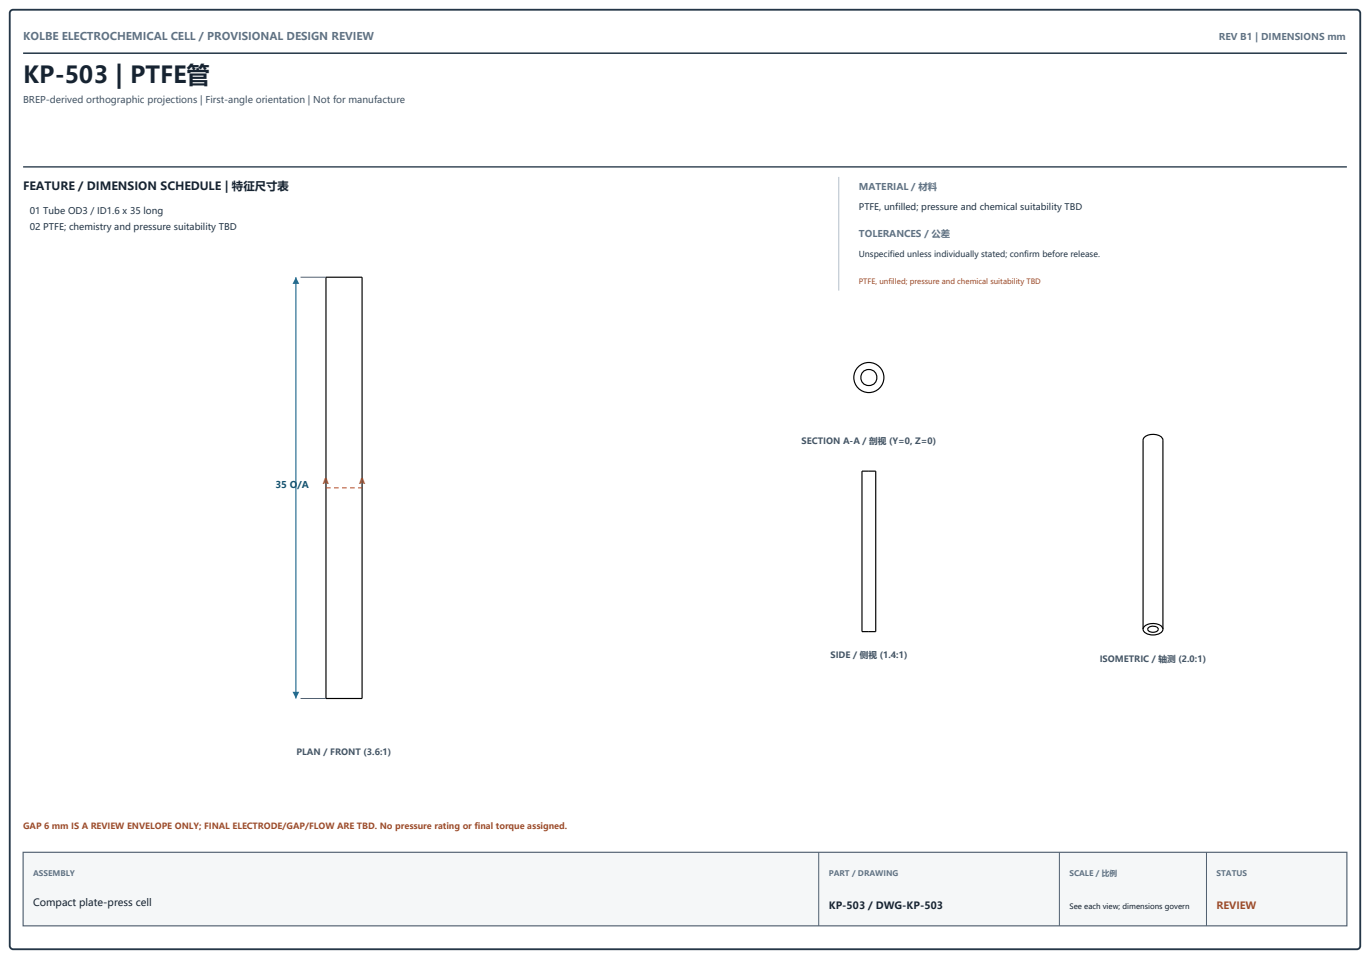
[picture p129: page 17]
PLAN / FRONT (3.6:1); SIDE / 侧视 (1.4:1); ISOMETRIC / 轴测 (2.0:1); SECTION A-A / 剖视 (Y=0, Z=0); TOLERANCES / 公差; ASSEMBLY; PART / DRAWING; SCALE / 比例; STATUS

BREP-derived orthographic projections | First-angle orientation | Not for manufacture

MATERIAL / 材料
PTFE, unfilled; pressure and chemical suitability TBD

01 Tube OD3 / ID1.6 x 35 long
02 PTFE; chemistry and pressure suitability TBD

Unspecified unless individually stated; confirm before release.

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

KP-503 / DWG-KP-503

# KB-A3 | A向三层铜梳排

### FEATURE / DIMENSION SCHEDULE | 特征尺寸表

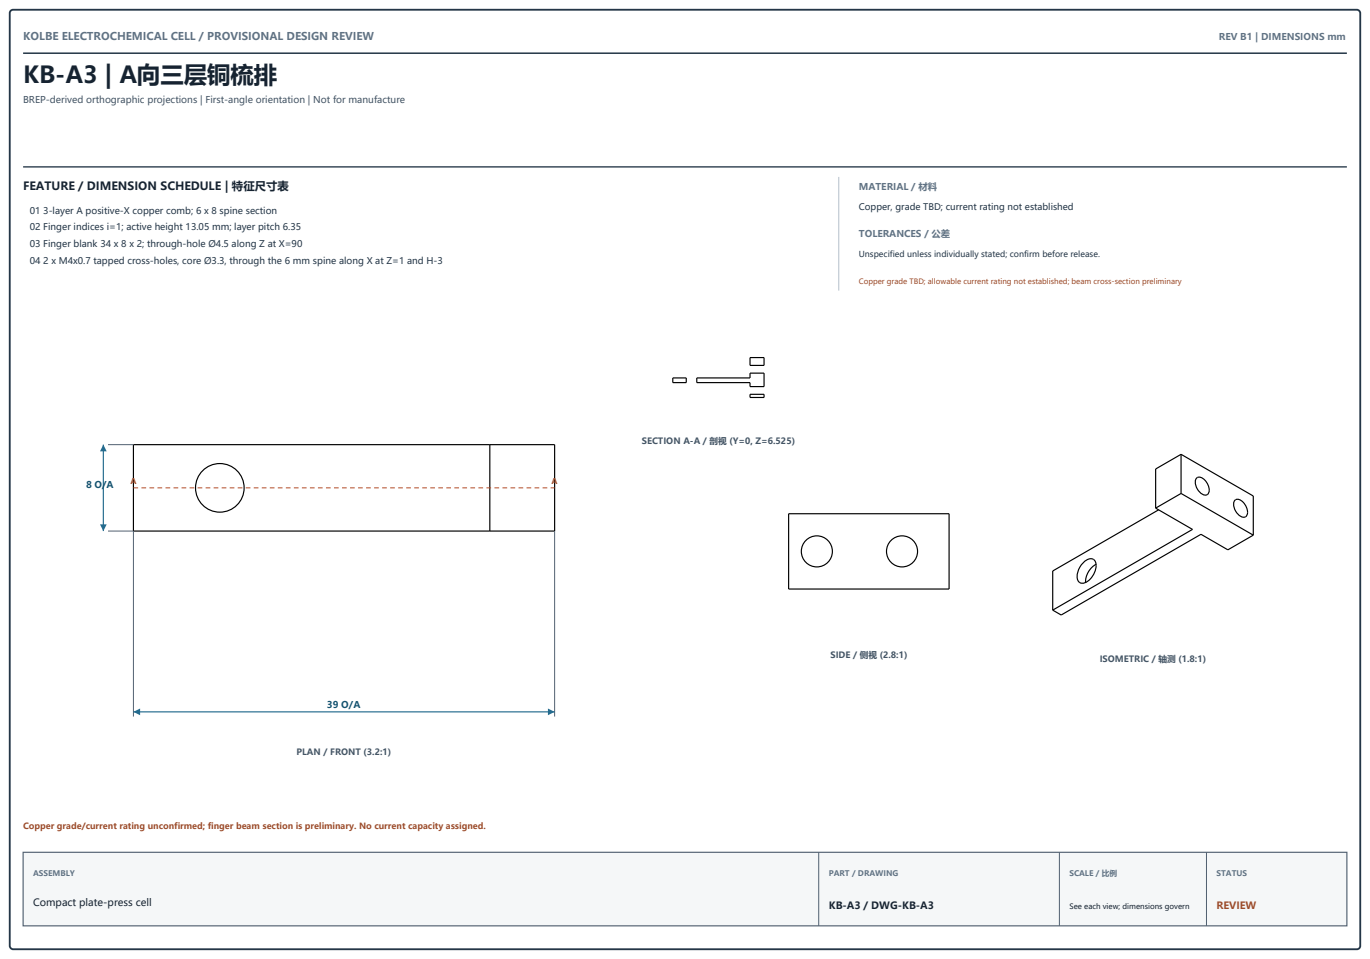
[picture p130: page 18]
PLAN / FRONT (3.2:1); SIDE / 侧视 (2.8:1); ISOMETRIC / 轴测 (1.8:1); SECTION A-A / 剖视 (Y=0, Z=6.525); TOLERANCES / 公差; ASSEMBLY; PART / DRAWING; SCALE / 比例; STATUS

BREP-derived orthographic projections | First-angle orientation | Not for manufacture

MATERIAL / 材料
Copper, grade TBD; current rating not established

01 3-layer A positive-X copper comb; 6 x 8 spine section
02 Finger indices i=1; active height 13.05 mm; layer pitch 6.35
03 Finger blank 34 x 8 x 2; through-hole Ø4.5 along Z at X=90
04 2 x M4x0.7 tapped cross-holes, core Ø3.3, through the 6 mm spine along X at Z=1 and H-3

Unspecified unless individually stated; confirm before release.

Copper grade TBD; allowable current rating not established; beam cross-section preliminary

Copper grade/current rating unconfirmed; finger beam section is preliminary. No current capacity assigned.

KB-A3 / DWG-KB-A3

# KB-C3 | C向三层铜梳排

### FEATURE / DIMENSION SCHEDULE | 特征尺寸表

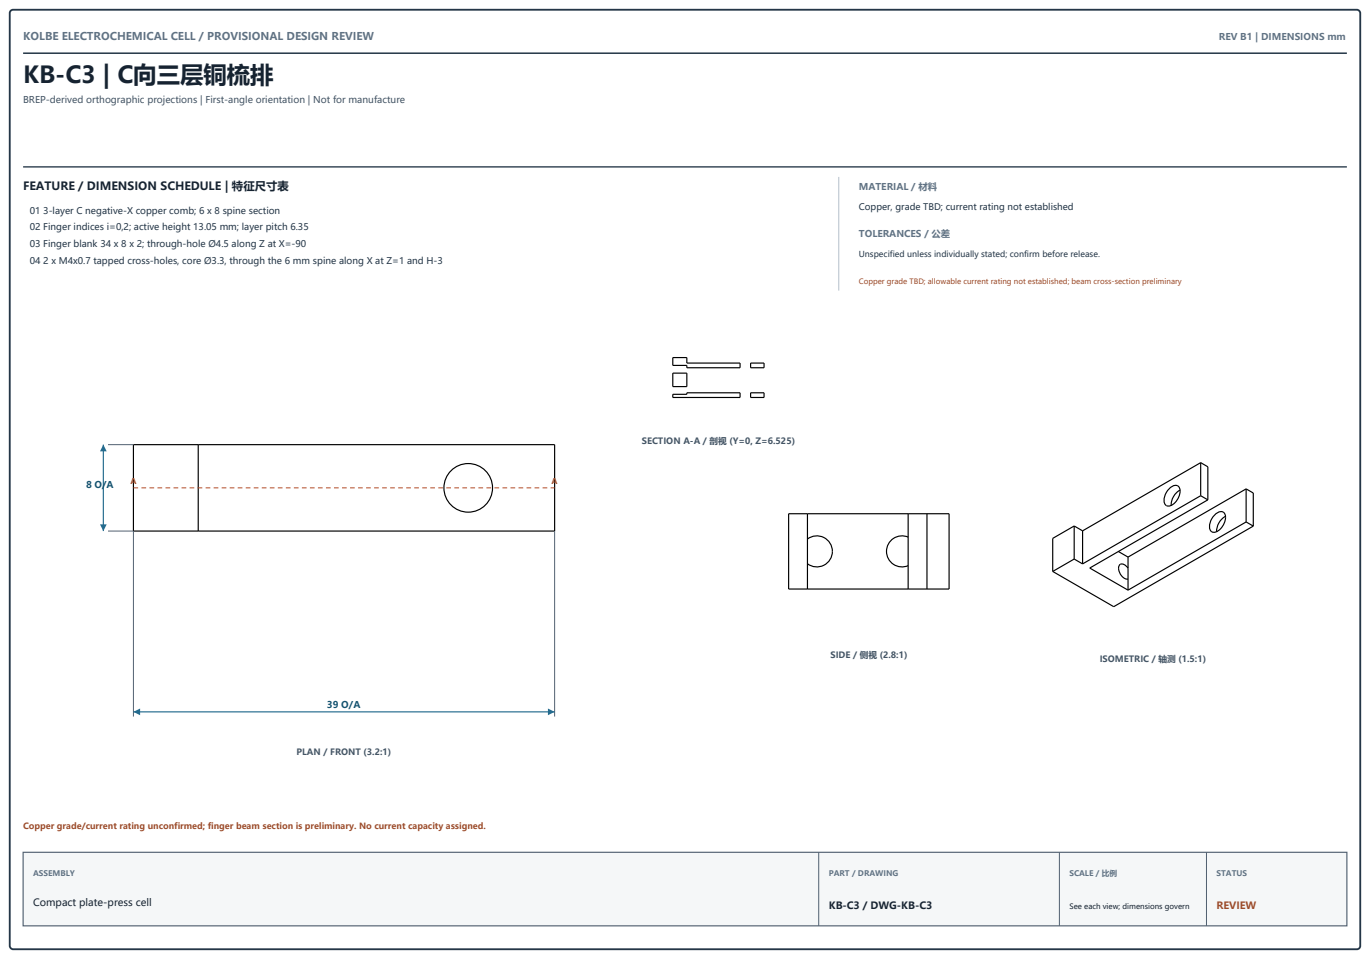
[picture p131: page 19]
PLAN / FRONT (3.2:1); SIDE / 侧视 (2.8:1); ISOMETRIC / 轴测 (1.5:1); SECTION A-A / 剖视 (Y=0, Z=6.525); TOLERANCES / 公差; ASSEMBLY; PART / DRAWING; SCALE / 比例; STATUS

BREP-derived orthographic projections | First-angle orientation | Not for manufacture

MATERIAL / 材料
Copper, grade TBD; current rating not established

01 3-layer C negative-X copper comb; 6 x 8 spine section
02 Finger indices i=0,2; active height 13.05 mm; layer pitch 6.35
03 Finger blank 34 x 8 x 2; through-hole Ø4.5 along Z at X=-90
04 2 x M4x0.7 tapped cross-holes, core Ø3.3, through the 6 mm spine along X at Z=1 and H-3

Unspecified unless individually stated; confirm before release.

Copper grade TBD; allowable current rating not established; beam cross-section preliminary

Copper grade/current rating unconfirmed; finger beam section is preliminary. No current capacity assigned.

KB-C3 / DWG-KB-C3

# KB-A5 | A向五层铜梳排

### FEATURE / DIMENSION SCHEDULE | 特征尺寸表

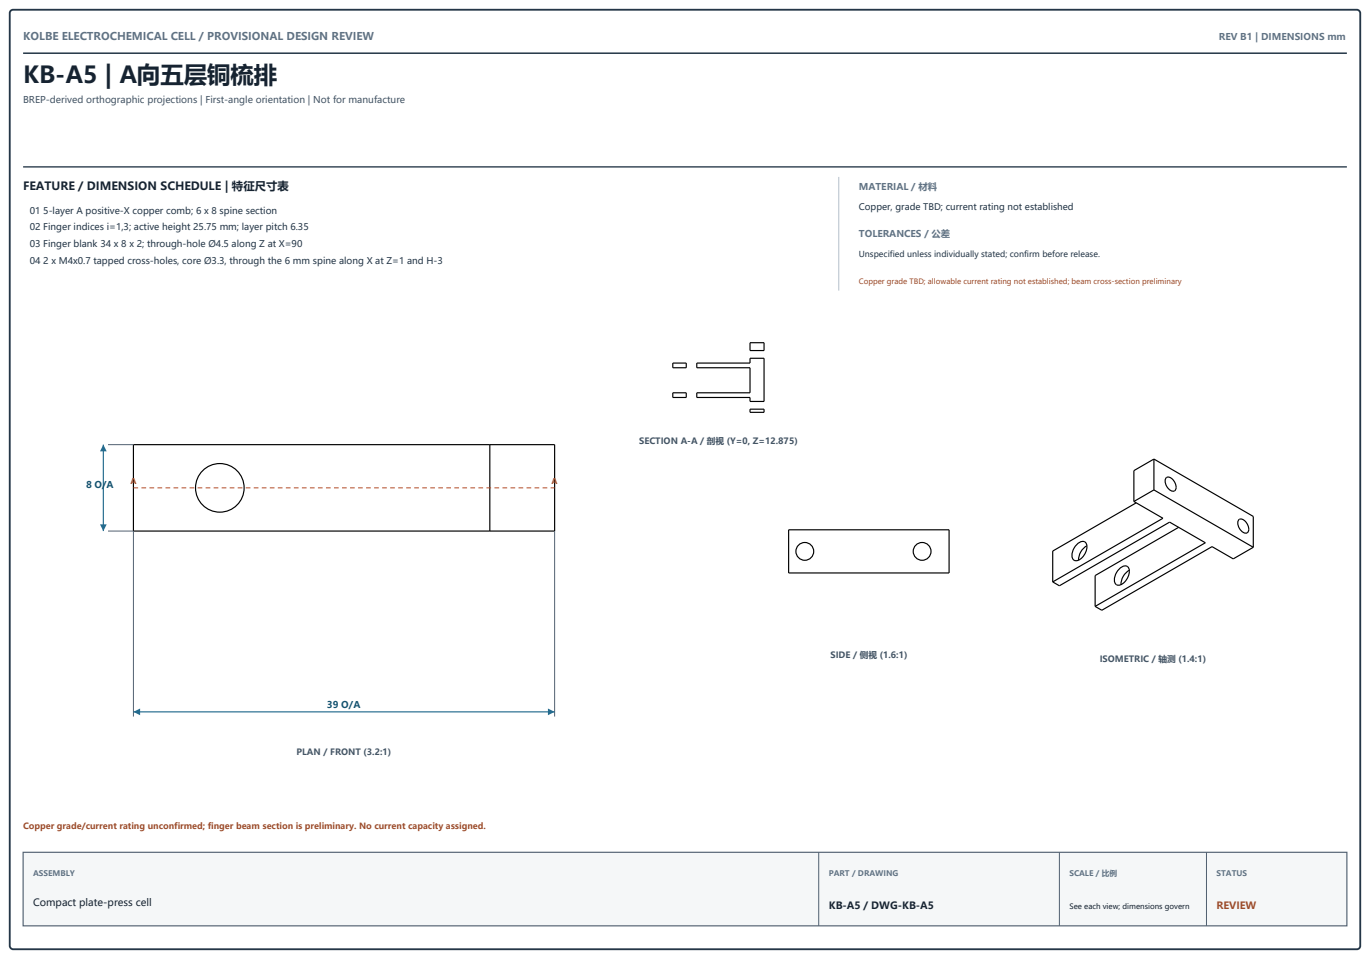
[picture p132: page 20]
PLAN / FRONT (3.2:1); SIDE / 侧视 (1.6:1); ISOMETRIC / 轴测 (1.4:1); SECTION A-A / 剖视 (Y=0, Z=12.875); TOLERANCES / 公差; ASSEMBLY; PART / DRAWING; SCALE / 比例; STATUS

BREP-derived orthographic projections | First-angle orientation | Not for manufacture

MATERIAL / 材料
Copper, grade TBD; current rating not established

01 5-layer A positive-X copper comb; 6 x 8 spine section
02 Finger indices i=1,3; active height 25.75 mm; layer pitch 6.35
03 Finger blank 34 x 8 x 2; through-hole Ø4.5 along Z at X=90
04 2 x M4x0.7 tapped cross-holes, core Ø3.3, through the 6 mm spine along X at Z=1 and H-3

Unspecified unless individually stated; confirm before release.

Copper grade TBD; allowable current rating not established; beam cross-section preliminary

Copper grade/current rating unconfirmed; finger beam section is preliminary. No current capacity assigned.

KB-A5 / DWG-KB-A5

# KB-C5 | C向五层铜梳排

### FEATURE / DIMENSION SCHEDULE | 特征尺寸表

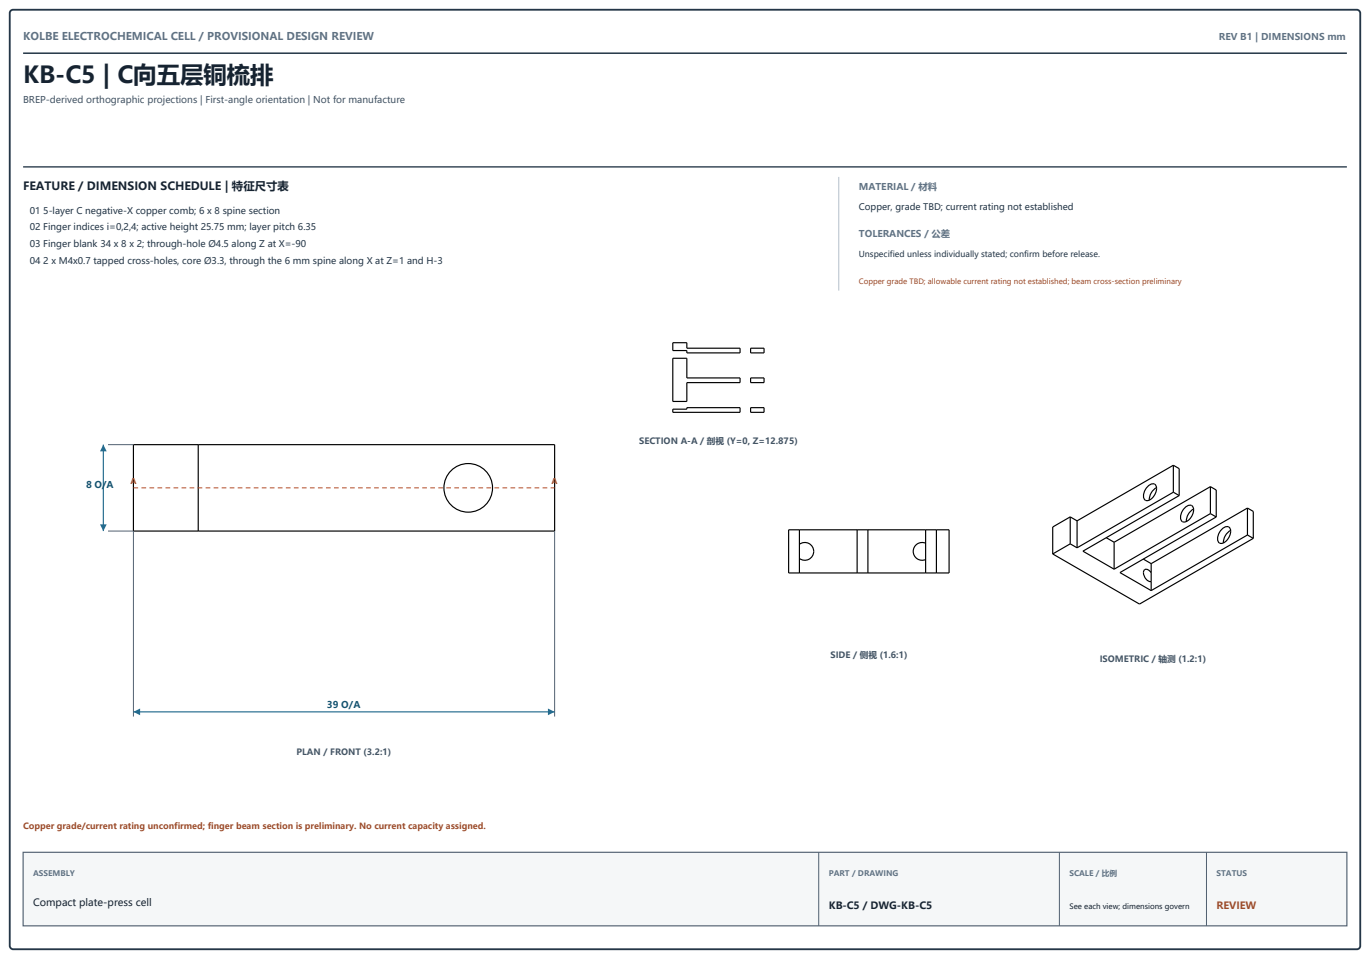
[picture p133: page 21]
PLAN / FRONT (3.2:1); SIDE / 侧视 (1.6:1); ISOMETRIC / 轴测 (1.2:1); SECTION A-A / 剖视 (Y=0, Z=12.875); TOLERANCES / 公差; ASSEMBLY; PART / DRAWING; SCALE / 比例; STATUS

BREP-derived orthographic projections | First-angle orientation | Not for manufacture

MATERIAL / 材料
Copper, grade TBD; current rating not established

01 5-layer C negative-X copper comb; 6 x 8 spine section
02 Finger indices i=0,2,4; active height 25.75 mm; layer pitch 6.35
03 Finger blank 34 x 8 x 2; through-hole Ø4.5 along Z at X=-90
04 2 x M4x0.7 tapped cross-holes, core Ø3.3, through the 6 mm spine along X at Z=1 and H-3

Unspecified unless individually stated; confirm before release.

Copper grade TBD; allowable current rating not established; beam cross-section preliminary

Copper grade/current rating unconfirmed; finger beam section is preliminary. No current capacity assigned.

KB-C5 / DWG-KB-C5

# KB-A7 | A向七层铜梳排

### FEATURE / DIMENSION SCHEDULE | 特征尺寸表

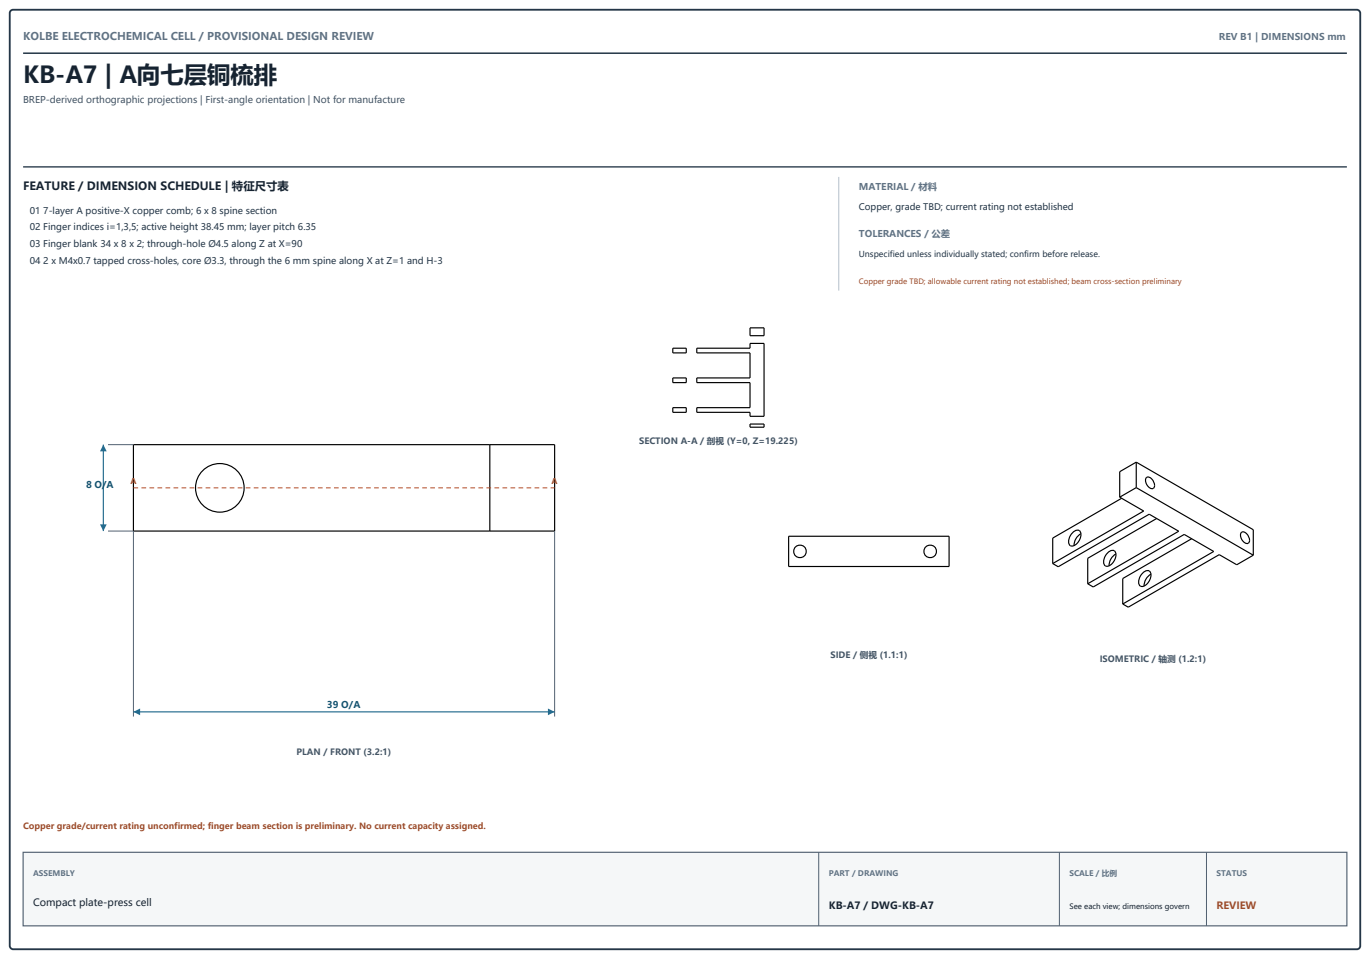
[picture p134: page 22]
PLAN / FRONT (3.2:1); SIDE / 侧视 (1.1:1); ISOMETRIC / 轴测 (1.2:1); SECTION A-A / 剖视 (Y=0, Z=19.225); TOLERANCES / 公差; ASSEMBLY; PART / DRAWING; SCALE / 比例; STATUS

BREP-derived orthographic projections | First-angle orientation | Not for manufacture

MATERIAL / 材料
Copper, grade TBD; current rating not established

01 7-layer A positive-X copper comb; 6 x 8 spine section
02 Finger indices i=1,3,5; active height 38.45 mm; layer pitch 6.35
03 Finger blank 34 x 8 x 2; through-hole Ø4.5 along Z at X=90
04 2 x M4x0.7 tapped cross-holes, core Ø3.3, through the 6 mm spine along X at Z=1 and H-3

Unspecified unless individually stated; confirm before release.

Copper grade TBD; allowable current rating not established; beam cross-section preliminary

Copper grade/current rating unconfirmed; finger beam section is preliminary. No current capacity assigned.

KB-A7 / DWG-KB-A7

# KB-C7 | C向七层铜梳排

### FEATURE / DIMENSION SCHEDULE | 特征尺寸表

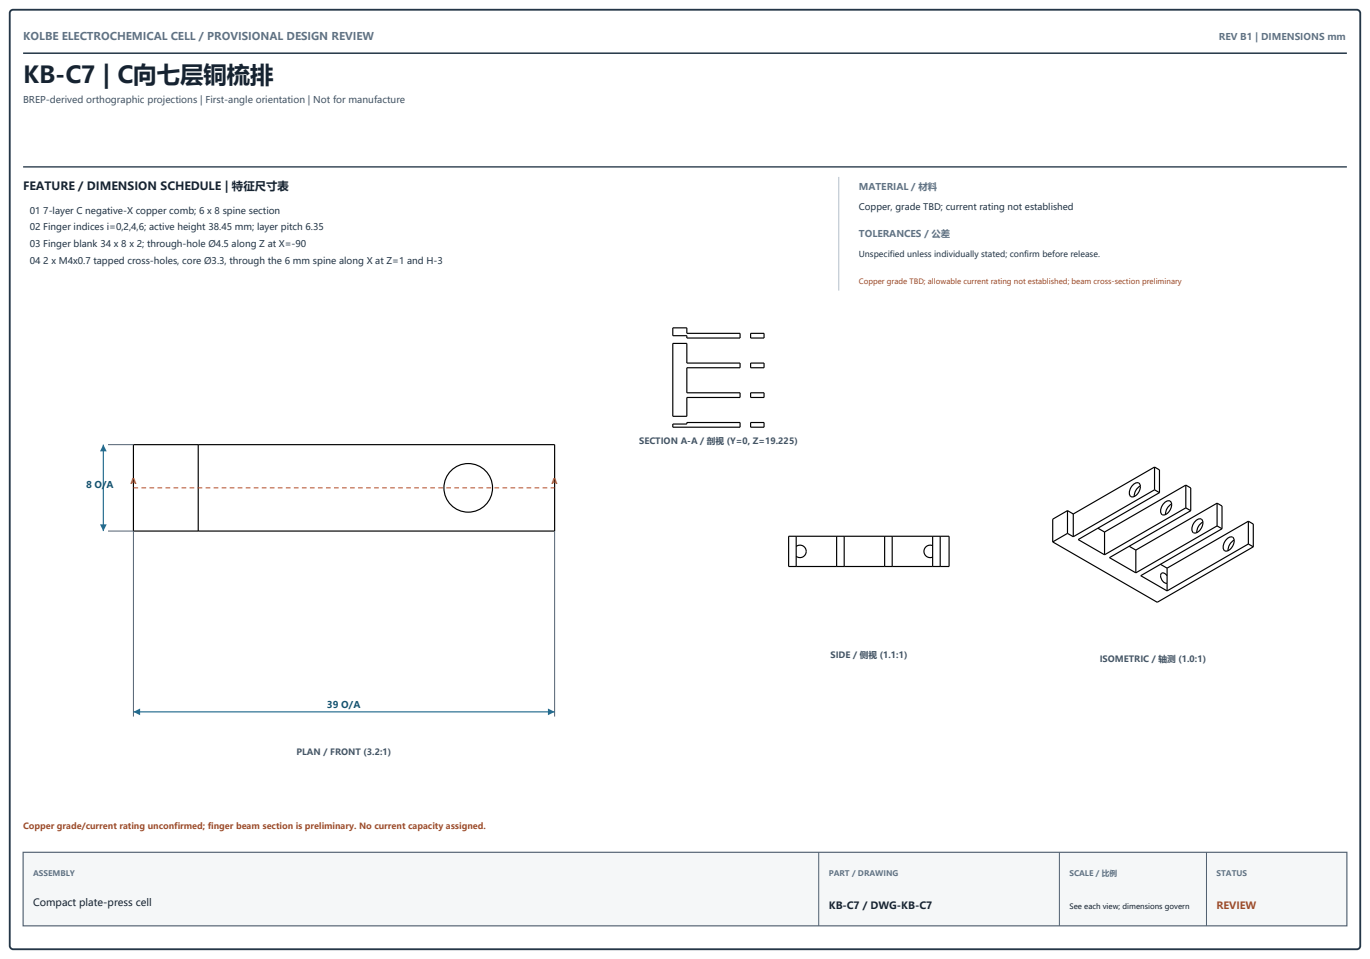
[picture p135: page 23]
PLAN / FRONT (3.2:1); SIDE / 侧视 (1.1:1); ISOMETRIC / 轴测 (1.0:1); SECTION A-A / 剖视 (Y=0, Z=19.225); TOLERANCES / 公差; ASSEMBLY; PART / DRAWING; SCALE / 比例; STATUS

BREP-derived orthographic projections | First-angle orientation | Not for manufacture

MATERIAL / 材料
Copper, grade TBD; current rating not established

01 7-layer C negative-X copper comb; 6 x 8 spine section
02 Finger indices i=0,2,4,6; active height 38.45 mm; layer pitch 6.35
03 Finger blank 34 x 8 x 2; through-hole Ø4.5 along Z at X=-90
04 2 x M4x0.7 tapped cross-holes, core Ø3.3, through the 6 mm spine along X at Z=1 and H-3

Unspecified unless individually stated; confirm before release.

Copper grade TBD; allowable current rating not established; beam cross-section preliminary

Copper grade/current rating unconfirmed; finger beam section is preliminary. No current capacity assigned.

KB-C7 / DWG-KB-C7

# KB-801 | 前PEEK支架

### FEATURE / DIMENSION SCHEDULE | 特征尺寸表

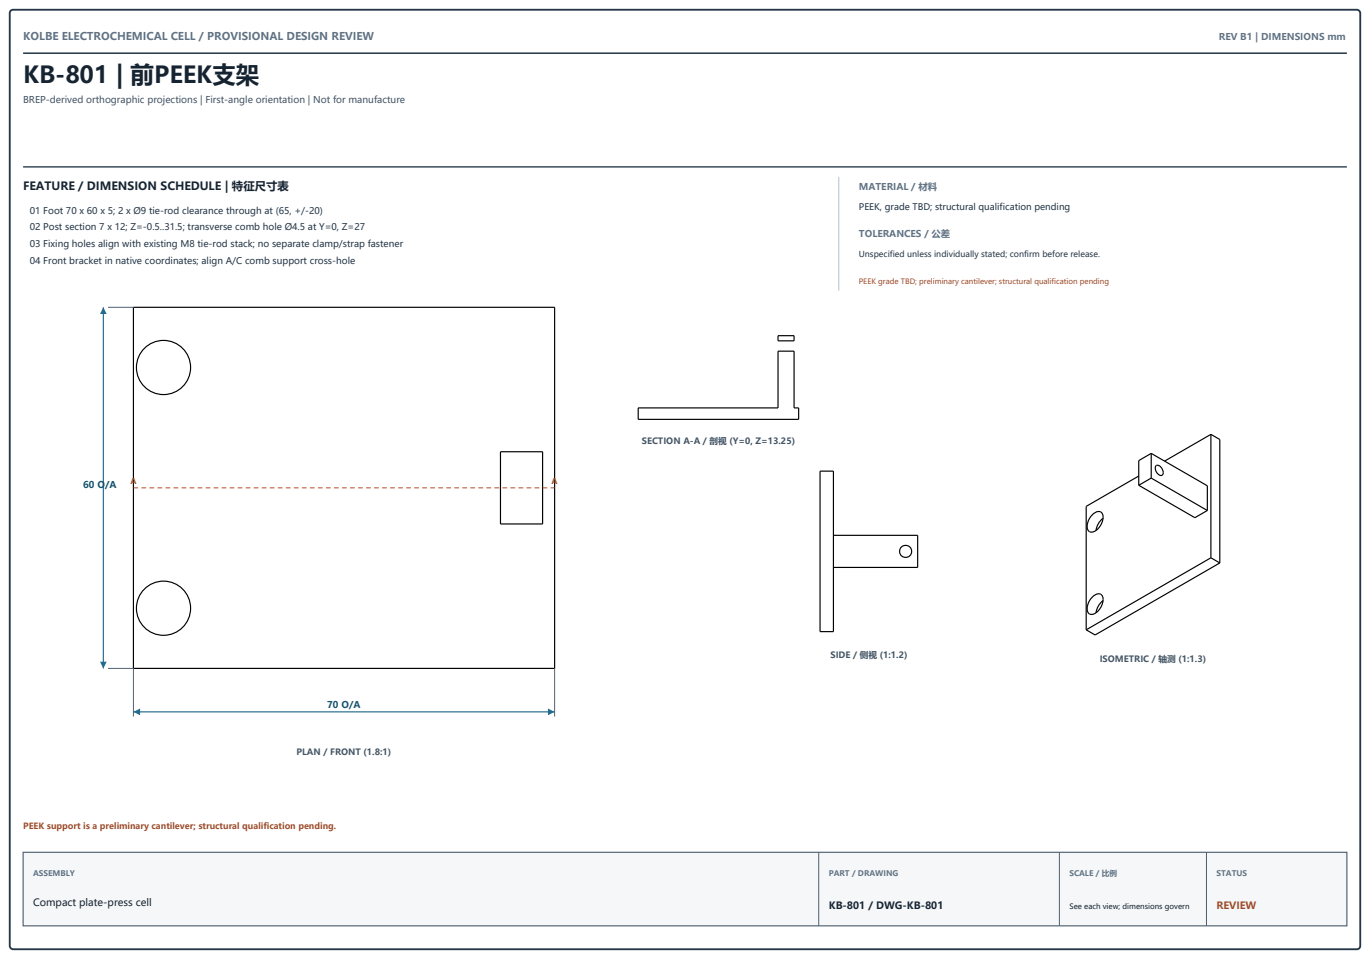
[picture p136: page 24]
PLAN / FRONT (1.8:1); SIDE / 侧视 (1:1.2); ISOMETRIC / 轴测 (1:1.3); SECTION A-A / 剖视 (Y=0, Z=13.25); TOLERANCES / 公差; ASSEMBLY; PART / DRAWING; SCALE / 比例; STATUS

BREP-derived orthographic projections | First-angle orientation | Not for manufacture

MATERIAL / 材料
PEEK, grade TBD; structural qualification pending

01 Foot 70 x 60 x 5; 2 x Ø9 tie-rod clearance through at (65, +/-20)
02 Post section 7 x 12; Z=-0.5..31.5; transverse comb hole Ø4.5 at Y=0, Z=27
03 Fixing holes align with existing M8 tie-rod stack; no separate clamp/strap fastener
04 Front bracket in native coordinates; align A/C comb support cross-hole

Unspecified unless individually stated; confirm before release.

PEEK grade TBD; preliminary cantilever; structural qualification pending

PEEK support is a preliminary cantilever; structural qualification pending.

KB-801 / DWG-KB-801

# KB-802 | 后PEEK支架

### FEATURE / DIMENSION SCHEDULE | 特征尺寸表

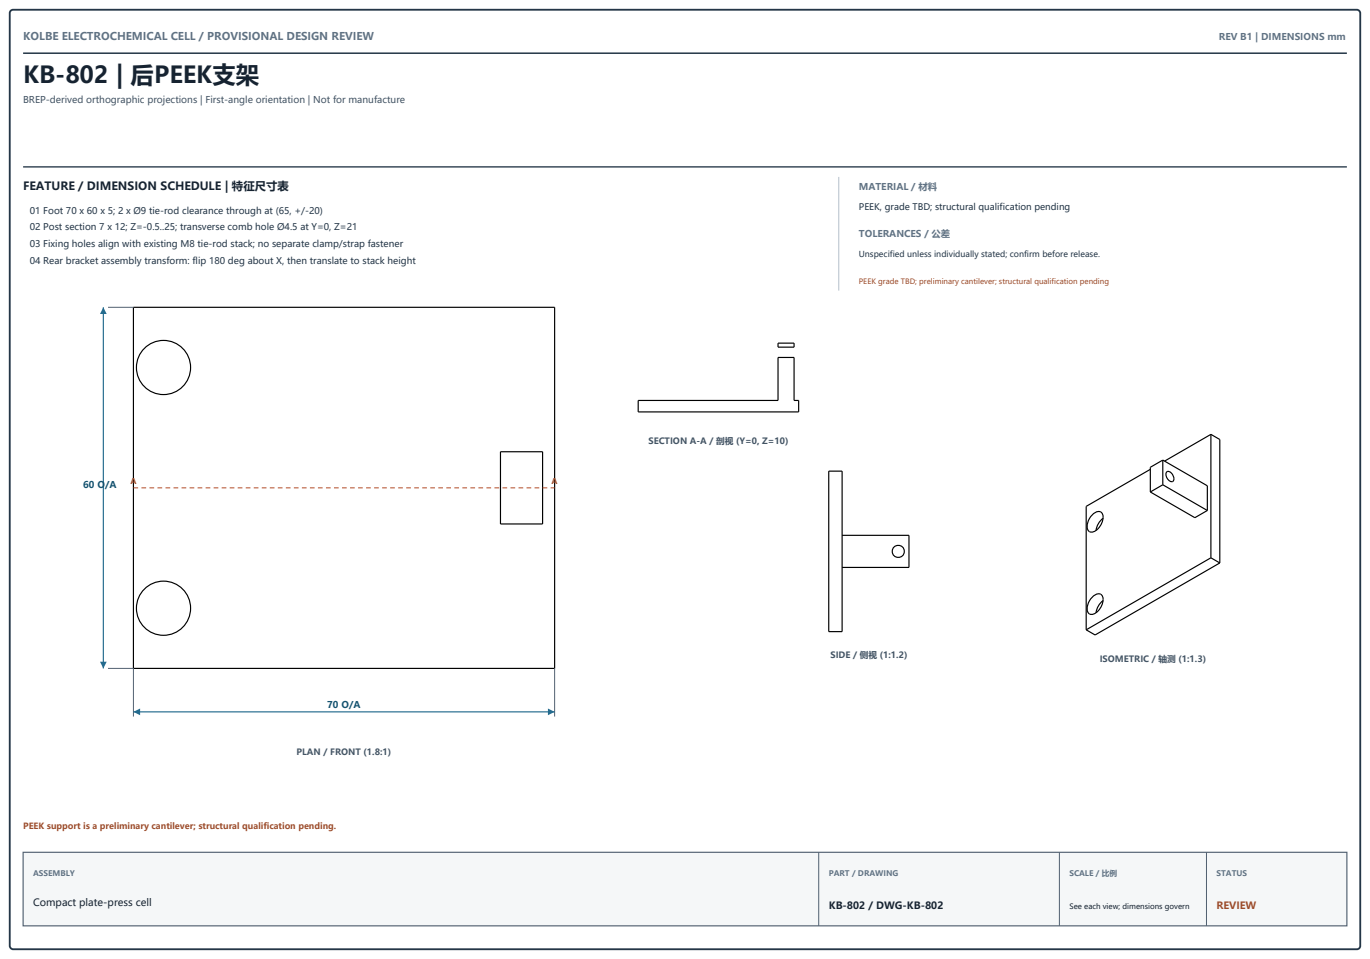
[picture p137: page 25]
PLAN / FRONT (1.8:1); SIDE / 侧视 (1:1.2); ISOMETRIC / 轴测 (1:1.3); SECTION A-A / 剖视 (Y=0, Z=10); TOLERANCES / 公差; ASSEMBLY; PART / DRAWING; SCALE / 比例; STATUS

BREP-derived orthographic projections | First-angle orientation | Not for manufacture

MATERIAL / 材料
PEEK, grade TBD; structural qualification pending

01 Foot 70 x 60 x 5; 2 x Ø9 tie-rod clearance through at (65, +/-20)
02 Post section 7 x 12; Z=-0.5..25; transverse comb hole Ø4.5 at Y=0, Z=21
03 Fixing holes align with existing M8 tie-rod stack; no separate clamp/strap fastener
04 Rear bracket assembly transform: flip 180 deg about X, then translate to stack height

Unspecified unless individually stated; confirm before release.

PEEK grade TBD; preliminary cantilever; structural qualification pending

PEEK support is a preliminary cantilever; structural qualification pending.

KB-802 / DWG-KB-802

# KH-901 | M4交叉孔堵头

### FEATURE / DIMENSION SCHEDULE | 特征尺寸表

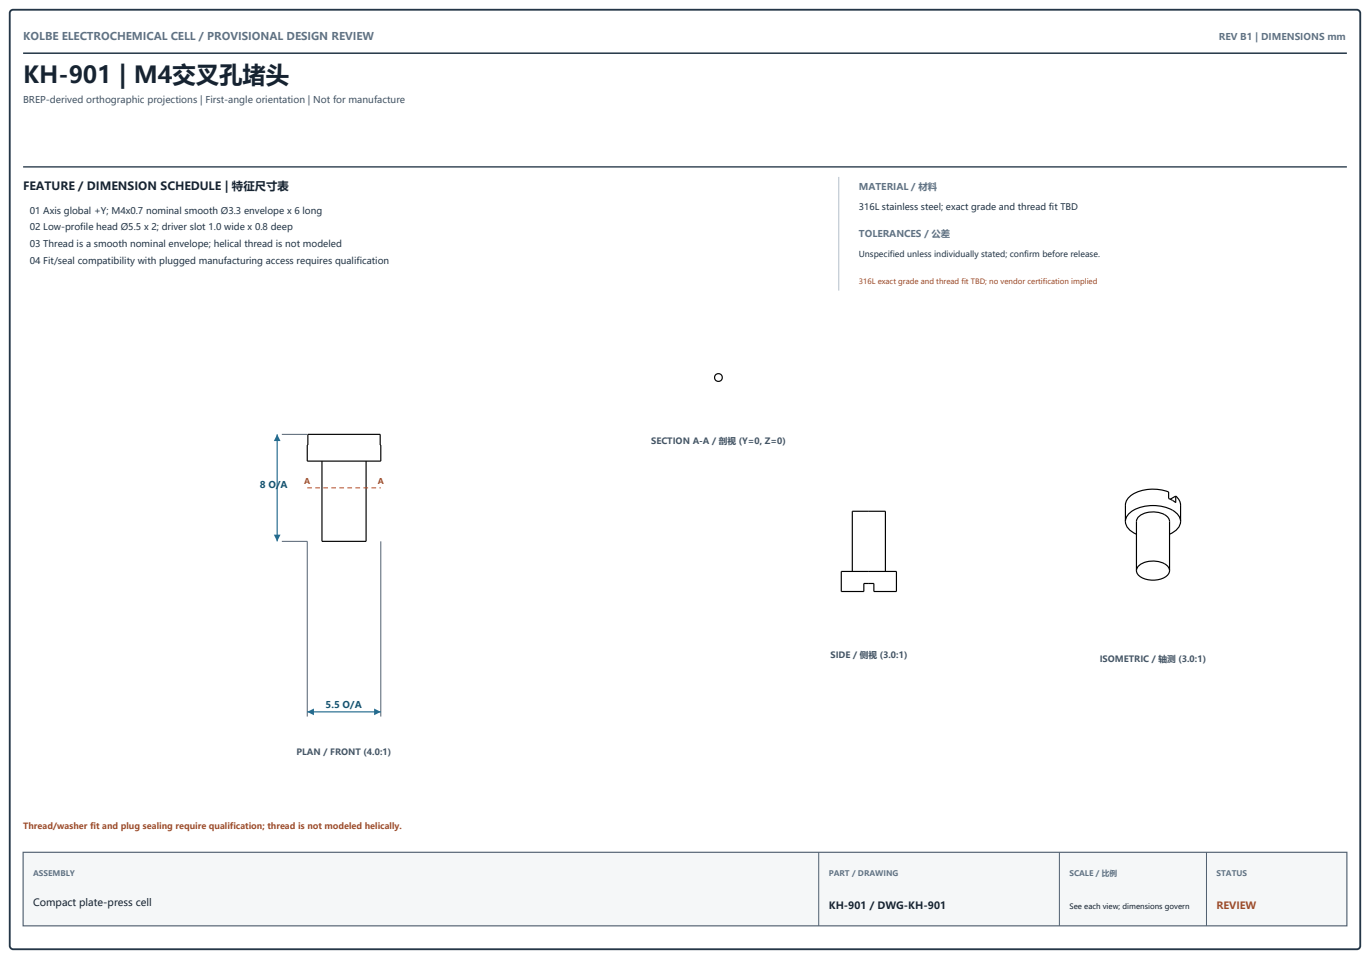
[picture p138: page 26]
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

BREP-derived orthographic projections | First-angle orientation | Not for manufacture

MATERIAL / 材料
316L stainless steel; exact grade and thread fit TBD

01 Axis global +Y; M4x0.7 nominal smooth Ø3.3 envelope x 6 long
02 Low-profile head Ø5.5 x 2; driver slot 1.0 wide x 0.8 deep
03 Thread is a smooth nominal envelope; helical thread is not modeled
04 Fit/seal compatibility with plugged manufacturing access requires qualification

Unspecified unless individually stated; confirm before release.

316L exact grade and thread fit TBD; no vendor certification implied

Thread/washer fit and plug sealing require qualification; thread is not modeled helically.

KH-901 / DWG-KH-901

# KH-902 | 堵头垫圈

### FEATURE / DIMENSION SCHEDULE | 特征尺寸表

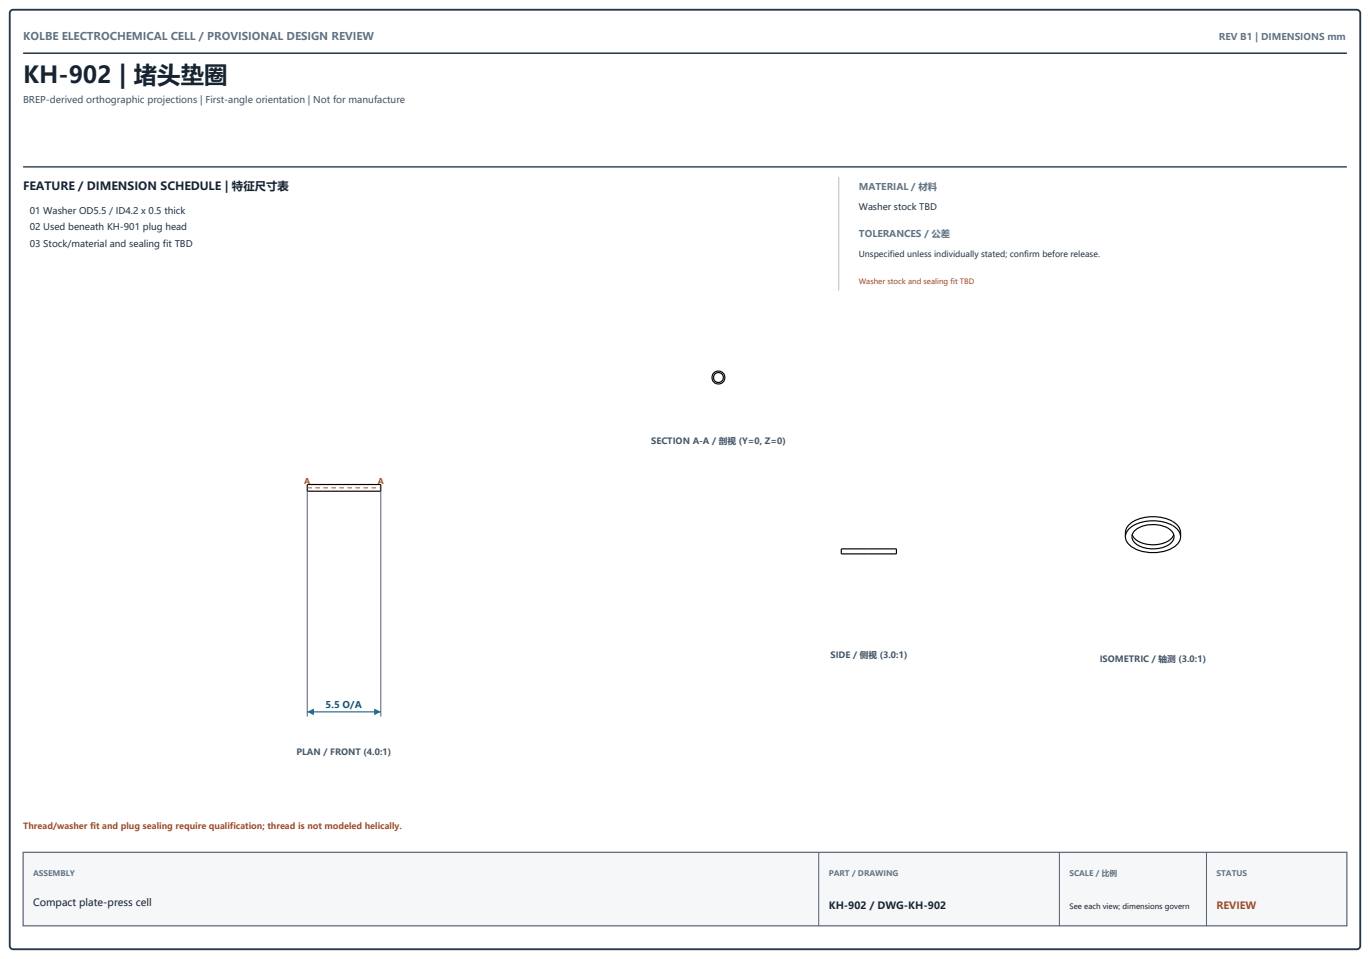
[picture p139: page 27]
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

BREP-derived orthographic projections | First-angle orientation | Not for manufacture

MATERIAL / 材料
Washer stock TBD

01 Washer OD5.5 / ID4.2 x 0.5 thick
02 Used beneath KH-901 plug head
03 Stock/material and sealing fit TBD

Unspecified unless individually stated; confirm before release.

Washer stock and sealing fit TBD

Thread/washer fit and plug sealing require qualification; thread is not modeled helically.

KH-902 / DWG-KH-902

# KS-101 | 主圆角方形密封圈

### FEATURE / DIMENSION SCHEDULE | 特征尺寸表

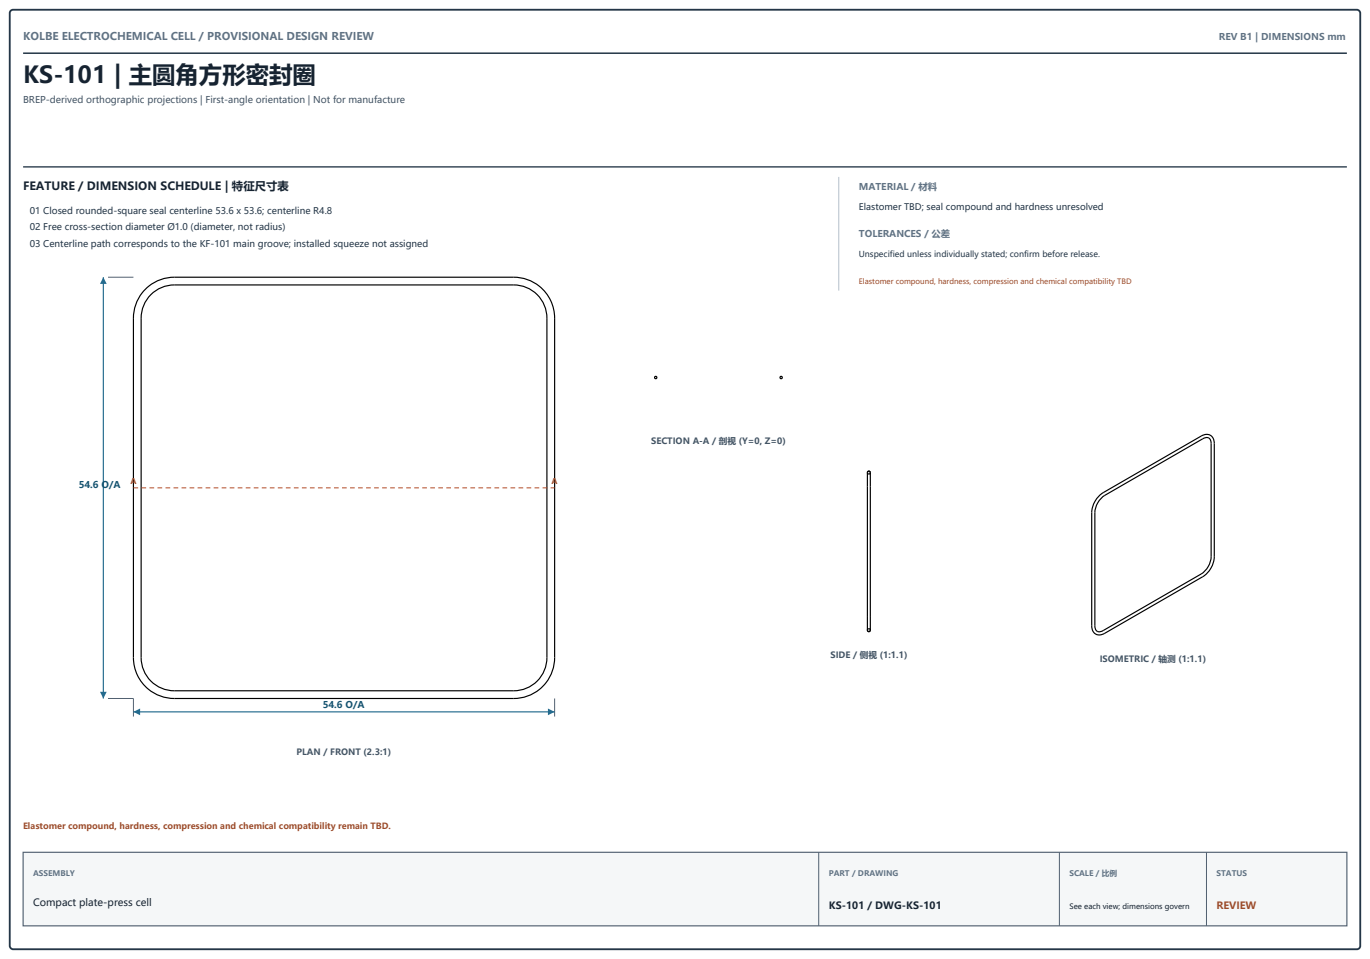
[picture p140: page 28]
PLAN / FRONT (2.3:1); SIDE / 侧视 (1:1.1); ISOMETRIC / 轴测 (1:1.1); SECTION A-A / 剖视 (Y=0, Z=0); TOLERANCES / 公差; ASSEMBLY; PART / DRAWING; SCALE / 比例; STATUS

BREP-derived orthographic projections | First-angle orientation | Not for manufacture

MATERIAL / 材料
Elastomer TBD; seal compound and hardness unresolved

01 Closed rounded-square seal centerline 53.6 x 53.6; centerline R4.8
02 Free cross-section diameter Ø1.0 (diameter, not radius)
03 Centerline path corresponds to the KF-101 main groove; installed squeeze not assigned

Unspecified unless individually stated; confirm before release.

Elastomer compound, hardness, compression and chemical compatibility TBD

Elastomer compound, hardness, compression and chemical compatibility remain TBD.

KS-101 / DWG-KS-101

# KS-102 | 歧管圆形密封圈

### FEATURE / DIMENSION SCHEDULE | 特征尺寸表

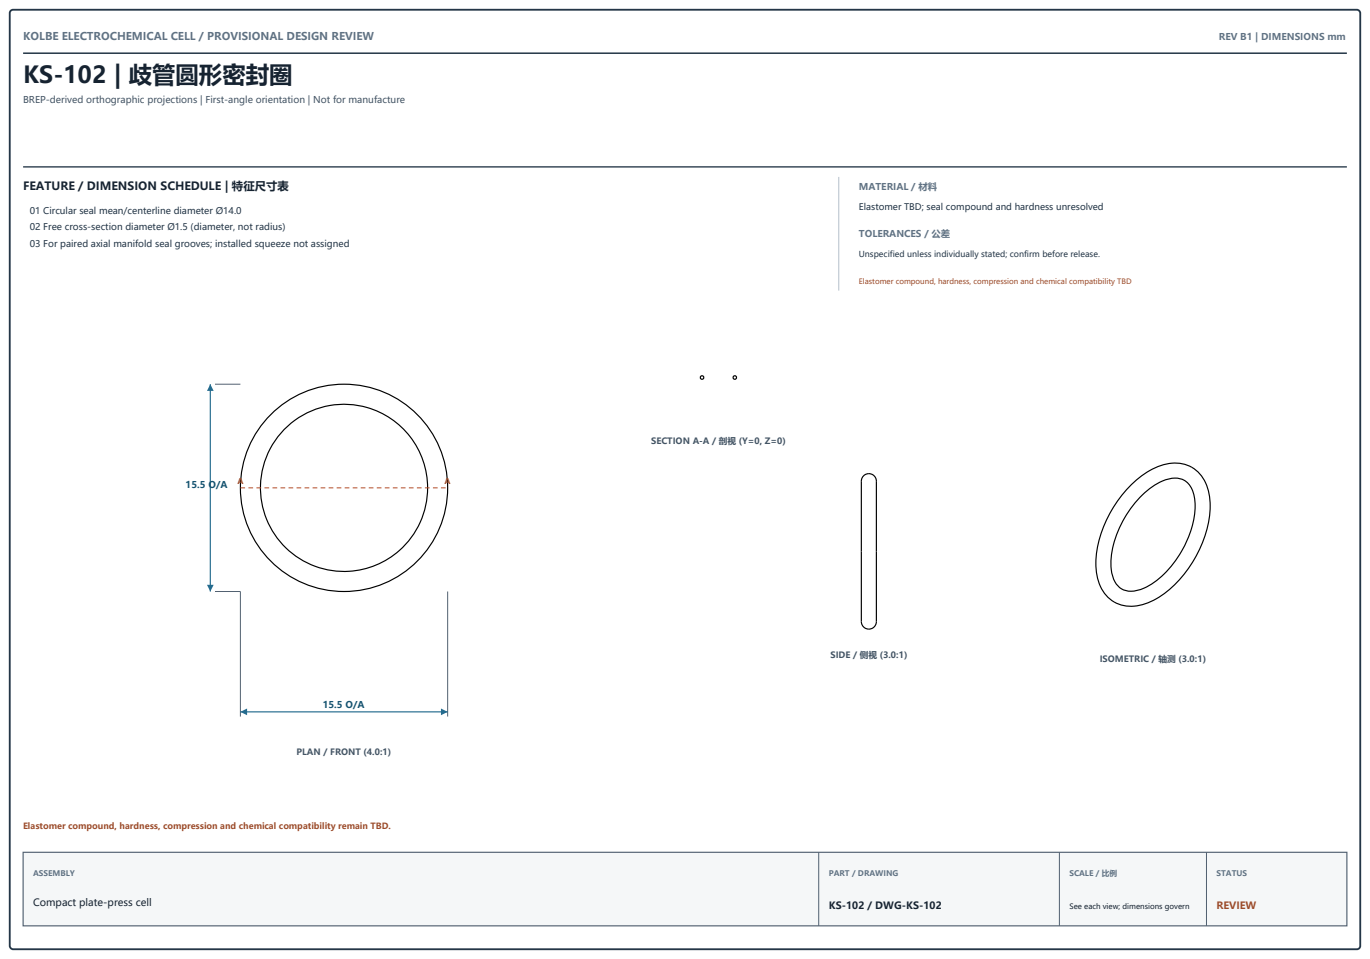
[picture p141: page 29]
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

BREP-derived orthographic projections | First-angle orientation | Not for manufacture

MATERIAL / 材料
Elastomer TBD; seal compound and hardness unresolved

01 Circular seal mean/centerline diameter Ø14.0
02 Free cross-section diameter Ø1.5 (diameter, not radius)
03 For paired axial manifold seal grooves; installed squeeze not assigned

Unspecified unless individually stated; confirm before release.

Elastomer compound, hardness, compression and chemical compatibility TBD

Elastomer compound, hardness, compression and chemical compatibility remain TBD.

KS-102 / DWG-KS-102
